jonasblixt/poetato/doc/review/schematic-readability-review-2026-10-13.md

# PoEtato schematic readability review

This review covers **readability only**: signal flow direction, density and sheet structure, font size consistency, naming, and text that collides with other items. Electrical correctness is covered by the 2026-10-09 review and is not repeated here. Like the other reviews, this is a living document: rows are updated in place and fixed items stay in the tables.

| | |
|---|---|
| Review started | 2026-10-13 |
| Revision checked | git `a62dd31` (schematic files unmodified in the working copy; only `poetato.kicad_pcb` had local changes). |
| Tools | `kicad-cli` 10.0.6 PDF export of all 10 sheets, rendered to PNG at 110 and 200 dpi and inspected visually. Font sizes and bold flags were read directly from the `.kicad_sch` files, not estimated from the renders. |
| Sheets | root `poetato`, `ethernet_poe`, `mcu`, `io` with sub-sheets `rs485`, `di` ×3, `do` ×2. |
| Preference applied | Inputs on the left, outputs on the right. Logic on the left and field on the right, where a sheet has both. Field connectors stay on the right even where that makes a channel read right to left (the DI channel stays as drawn). |
| Not checked | Electrical content, ERC and netlist. Anything about layout. |
| Status update | 2026-10-13: review closed. 19 fixed, 9 resolved by decision, 1 partly fixed (FONT-4: the LPUART1 debug port title and frame, left to Jonas). Every change was checked with ERC (0 errors, 0 warnings) and a pin-by-pin netlist comparison against the previous commit; connectivity is unchanged throughout. The schematic now has 12 A3 pages: root, MCU, MCU/Peripherals, Ethernet & PoE, Power, IO, IO/RS485, DO1, DO2, DI1–DI3. |

**Status:**
- **Open**: not addressed.
- **Partly fixed**: some of it is done; the row says what remains.
- **Fixed**: verified fixed in the schematic.
- **Resolved (decision)**: stays as it is by decision.

## Summary

The top level, the Ethernet PHY section, the isolated 24 V supply, the DO channel and the RS-485 transceiver already read left to right. Four power blocks read right to left. The MCU and Ethernet & PoE sheets each hold about 80 parts on A3 and are the hardest to read. Meanwhile RS485 is sparse and the top level is about 70 % empty. The smallest text on every sheet is the power symbol text (0.762 mm), and the LED fields are almost as small (0.99 mm).

Suggested order of work:
1. Fonts and value formatting (FONT-*, VAL-1). These are mechanical.
2. Rename and reorder the DO/DI sheets (NAME-1, NAME-2).
3. Mirror the RS-485 5 V buck (FLOW-3).
4. Split the sheets (DENS-1 to DENS-3). This also fixes FLOW-1 and FLOW-2.

## Outcome

What changed, in commit order (all 2026-10-13):

| Commit | Change |
|---|---|
| `58208a3` | Power tree on the top-level sheet (DENS-3). |
| `8686346`, `5b35b6c` (kicadlib) | Field text 1.27 mm in all hand-made symbol libraries; units on the misc R/C values. |
| `4df666f` | Symbols synced from kicadlib (FONT-1 to FONT-3, VAL-1 in part). |
| `cf830f9` | IO sub-sheets renamed DO1, DO2, DI1–DI3 and pages ordered (NAME-1, NAME-2). |
| `27c7142` | New top-level Power sheet with the 3.3 V, isolated 24 V and RS-485 5 V converters; the bucks mirrored to read left to right; eFuse next to J1 (FLOW-1, FLOW-3, FLOW-5, DENS-1). |
| `6f42cbc` | Local text collisions, KSZ8081 strap summary, BOM-only frame (LOC-*). |
| `6f4d484` | Flash, SE051 and status LEDs on an MCU peripherals sub-sheet (DENS-2). |
| `2837a36` | 2.54 mm block titles on MCU and Peripherals, DI sheets on A3 (FONT-4 in part, DENS-4). |

Jonas's own touch-ups in KiCad are in `a8c7976` and `56a763b` (the latter also updates J3 from kicadlib `81de170`).

## Findings

### Signal flow

| ID | Status | Sheet | Refs | Finding | Suggested fix |
|---|---|---|---|---|---|
| FLOW-1 | Fixed | MCU | U18, L4, C82, C83, C85 | **3.3 V buck reads right to left.** P12V0 enters on the right and P3V3 leaves on the left, because the symbol has SW on the left and VIN on the right. | Mirror the block, or redraw the TPS563252 library symbol with VIN on the left. Better still, move it to a power sheet (DENS-1). **Fixed 2026-10-13:** new top-level **Power** sheet (`power.kicad_sch`, page 4) holds the 3.3 V buck, the isolated 24 V supply (SN6507, T1, enable FET and LED) and the RS-485 5 V buck, laid out like the power tree. The PoE flyback stays on the Ethernet sheet by decision. Symbols keep their UUIDs and references; ERC 0, every net connects the same pins as before. The 3.3 V block is mirrored, so it reads left to right. |
| FLOW-2 | Resolved (decision) | Ethernet & PoE | T3, FB1–FB4, U4, T2, U5, P12V0 | **PoE PD reads right to left across the whole lower half.** Power enters at T3 (far right), passes U4 and then T2, and leaves as P12V0 at the far left edge. | Move it to its own sheet, with POE_CT1/CT2/SP1/SP2 entering from the left as hierarchical labels and P12V0 leaving on the right (DENS-1). **Closed 2026-10-13:** left as is by decision (Jonas). The PoE PD stays on the Ethernet sheet as drawn. |
| FLOW-3 | Fixed | RS485 | U17, L3, C76, C77, C79, C80, C93 | **5 V isolated buck reads right to left.** VIN (P24V0_FIELD) is on the right and P5V_RS485 leaves on the left. | Mirror the block. The page has plenty of room. **Fixed 2026-10-13:** moved to the Power sheet and mirrored; P24V0_FIELD enters on the left, P5V_RS485 leaves on the right. |
| FLOW-5 | Fixed | IO | U19, J1, D24 | The 24 V eFuse output leaves U19 OUT at the right edge. The wire then loops back left around the page to reach J1 in the middle. | Put a `P24V0_FIELD_PROT` net label at U19 OUT and at J1 pin 1, and drop the long wire. Alternatively, move the isolated supply to its own sheet. **Fixed 2026-10-13:** with the supply on the Power sheet, the eFuse block sits next to J1, just right of the isolation barrier, and P24V0_FIELD comes in through a power symbol. The output path to J1 pin 1 is short; the loop around the page is gone. |
| FLOW-6 | Resolved (decision) | MCU | U1 | The DO1_ON/DO2_ON hierarchical labels sit on the left of U1, while DI_EN, DI1–DI3 and P24V_FIELD_EN sit on the right. All of them go to the IO sheet, which is on the right at the top level. This follows from the pin sides of the bank symbol. | Low priority. If U1 is split into units (DENS-2), group the IO bank on the right. **Closed 2026-10-13:** left as is by decision (Jonas). |

### Density and sheet structure

| ID | Status | Sheet | Refs | Finding | Suggested fix |
|---|---|---|---|---|---|
| DENS-1 | Resolved (decision) | Ethernet & PoE, MCU | — | **Ethernet & PoE holds ~83 parts on A3 (test points not counted).** The T3 centre taps V1–V4 run from the PHY box down into the PoE box. The blue isolation barrier polyline also cuts across the PHY section to get there. Power is spread over four sheets: 12 V on Ethernet, 3.3 V on MCU, 24 V on IO and 5 V on RS485. | New **PoE & power** sheet: Si3402 → flyback → P12V0 → 3.3 V buck, left to right on one A3. That leaves the Ethernet sheet with just the PHY, straps, T3 and link LEDs. Note that an orphan `power.kicad_sch` was removed in `05cff1d`, so whether a power sheet comes back is your call. **Resolved 2026-10-13:** new top-level **Power** sheet (`power.kicad_sch`, page 4) holds the 3.3 V buck, the isolated 24 V supply (SN6507, T1, enable FET and LED) and the RS-485 5 V buck, laid out like the power tree. The PoE flyback stays on the Ethernet sheet by decision. Symbols keep their UUIDs and references; ERC 0, every net connects the same pins as before. The Ethernet sheet keeps the PD and flyback. |
| DENS-2 | Fixed | MCU | — | **The MCU sheet holds ~77 parts (test points not counted) and 11 functional blocks:** MCU, SWD, LPUART debug, USB, reset supervisor, flash, SE051, 3.3 V buck, RTC backup, status LEDs, crystals and decoupling. Several nets cross the page as long wires even though they also carry labels: SE_SCL/SE_SDA, SYS_STS_RED/GREEN, RESET_N (from J3 down to the supervisor), ISP_N and LPUART1_RXD/TXD. | Split into **MCU core** (U1, decoupling, crystals, reset/supervisor, VDD_CORE DCDC, RTC backup) and **MCU peripherals** (flash, SE051, SWD, LPUART, USB with ESD, status LEDs). Join them with labels rather than page-length wires. **Partly fixed 2026-10-13:** the 3.3 V buck has moved to the Power sheet. The MCU core/peripherals split is still open. **Fixed 2026-10-13:** flash (U11), SE051 (U10) and the status LEDs moved to a sub-sheet /MCU/Peripherals/ (`mcu_periph.kicad_sch`, A4, page 3). On the MCU sheet U1 connects to it through short labelled stubs, so the long SE_SCL/SE_SDA and SYS_STS wires are gone. Series resistor R44 stays next to U1. MCU sheet retitled "MCU core, debug and USB". Netlist unchanged, including net names. |
| DENS-3 | Fixed | Top level | — | The top level is about 70 % empty, and the power architecture does not appear on it. | Add a small power tree (PoE → 12 V → 3.3 V; isolated 24 V field supply; isolated 5 V RS-485 supply) as text or graphics in the free space. **Fixed 2026-10-13:** "Power tree" block added below the sheet symbols. It is drawn in native graphics only (no wires or symbols) and shows rail net names, both isolation barriers and the three ground domains. ERC 0 violations. |
| DENS-4 | Resolved (decision) | RS485 | — | Only ~29 parts on A3. The content sits in the middle and the lower left is empty. | No split needed. Mirroring the buck (FLOW-3) is a good moment to tighten it. Changing the sheet to A4 is optional. **2026-10-13:** with the 5 V buck on the Power sheet, the RS485 sheet holds only the transceiver, bus protection and LEDs, so A4 is now worth considering. **Resolved 2026-10-13:** A3 everywhere by decision. RS485 stays on A3; the DI sheets moved from A4 to A3 with the content placed where it sits on the DO sheets (ERC exclusion for COOL_POUR moved with it). |

### Font sizes

All sizes below are read from the files. The baseline is 1.27 mm for references, values, labels, sheet pins and notes.

| ID | Status | Sheet | Refs | Finding | Suggested fix |
|---|---|---|---|---|---|
| FONT-1 | Fixed | all | GND, P3V3, P12V0, GND_FIELD, P24V0_FIELD etc. | **Power symbol text is 0.762 mm**, which is about 60 % of the baseline and about 2 pt when printed on A3. All 154 placed GND and supply symbols use it: MCU 73, Ethernet 35, IO 19, RS485 18, DI 6, DO 3. This is the hardest text to read on every sheet. | Set 1.27 mm in the library symbols, then reset the placed instances with *Edit → Edit Text & Graphic Properties*. Field sizes are stored per instance, so a library update alone does not change them. **Fixed 2026-10-13:** kicadlib `8686346` sets field text to 1.27 mm in all hand-made symbol libraries; pulled in with Update Symbols from Library. Value sizes were synced to the library by script, because resetting Value in KiCad would also reset power-symbol net names. Field positions kept as before the update; R1, C6, Q6 and C75 text nudged where the larger power-symbol text collided. ERC 0, netlist unchanged. |
| FONT-2 | Fixed | all | D7, D8, D9, D13–D16, D22 + the other DI copies | **LED Reference and Color fields are 0.99 mm.** | Use 1.27 mm, as in FONT-1. **Fixed 2026-10-13:** kicadlib `8686346` sets field text to 1.27 mm in all hand-made symbol libraries; pulled in with Update Symbols from Library. Value sizes were synced to the library by script, because resetting Value in KiCad would also reset power-symbol net names. Field positions kept as before the update; R1, C6, Q6 and C75 text nudged where the larger power-symbol text collided. ERC 0, netlist unchanged. |
| FONT-3 | Fixed | MCU, Eth, IO, RS485, DI, DO | U7, U8, U9, U11, U17, U18, U20, J4, J5, J6, J8, Q1, Q3, Q6–Q10, Q12, D27 | **Reference and Value are 1.524 mm on some ICs, FETs and connectors**, while U1, U3, U4, U10, U12, U16 and everything else use 1.27 mm. Neighbouring parts on the same sheet therefore don't match. These parts probably came from libraries with a different default. | Pick one size (1.27 mm) and batch-set it. Fix the library defaults too. **Fixed 2026-10-13:** kicadlib `8686346` sets field text to 1.27 mm in all hand-made symbol libraries; pulled in with Update Symbols from Library. Value sizes were synced to the library by script, because resetting Value in KiCad would also reset power-symbol net names. Field positions kept as before the update; R1, C6, Q6 and C75 text nudged where the larger power-symbol text collided. ERC 0, netlist unchanged. |
| FONT-4 | Partly fixed | MCU, IO, RS485 | — | **Block titles are inconsistent.** "SWD Debug port", "3.3V Supply", "Voltage supervisor / Reset generation", "Ethernet PHY" and "PoE (Power over Ethernet)" are 2.54 mm inside a dashed box. "RTC & SRAM Backup power (>= 8h)" is a 1.27 mm title. "LPUART1 Debug Port" is 1.27 mm with no box. "RS485 5V Supply" is 2.54 mm with no box and sits *below* its block. On IO, "Isolated 24V, 3W supply" is loose 1.27 mm text on the right of the page, not near the supply. | Use one convention: a 2.54 mm title in the top left corner of a dashed box, one per functional block. Give LPUART debug, RS485 transceiver, RS485 5 V supply, the isolated 24 V supply and the status LEDs their own boxes. **Partly fixed 2026-10-13:** all block titles are now 2.54 mm in a dashed frame: Power sheet (3.3 V, 24 V, 5 V), Peripherals (Secure Element, 8MiB Mass storage flash, System status LEDs, left-aligned in each frame), and the MCU RTC block ("RTC & SRAM backup (≥ 8 h)", two lines; contents moved down 7.62 mm to make room). Remaining: the LPUART1 debug port still has a small title and no frame; J4 sits against the page border, so it needs moving first. |

### Naming and ordering

| ID | Status | Sheet | Refs | Finding | Suggested fix |
|---|---|---|---|---|---|
| NAME-1 | Fixed | IO, DO, DI | — | **Sub-sheet names are off by one compared with the channel numbers.** "Digital Output" is DO1, but "Digital Output1" is DO2 (K2, DO2_ON). "Digital Input", "Digital Input1" and "Digital Input2" are DI1, DI2 and DI3. The sheet path in the title block (for example `/IO/Digital Output1/`) therefore names the wrong channel. | Rename the sheets `DO1`, `DO2`, `DI1`, `DI2`, `DI3` to match the nets and the J1 pinout. **Fixed 2026-10-13:** renamed to DO1, DO2, DI1, DI2, DI3 (sheet UUIDs unchanged, so PCB footprint links are kept). The only nets renamed are the three ISO1211 `COOL_POUR` nets, now `/IO/DI1/COOL_POUR` to `/IO/DI3/COOL_POUR`. |
| NAME-2 | Fixed | — | — | **Page numbers interleave the channels:** 6 = DO, 7 = DI, 8 = DO1, 9 = DI1, 10 = DI2. | Renumber so the pages go DO1, DO2, DI1, DI2, DI3, and put RS485 next to IO. **Fixed 2026-10-13:** pages are now 1 root, 2 MCU, 3 Ethernet & PoE, 4 IO, 5 RS485, 6 DO1, 7 DO2, 8 DI1, 9 DI2, 10 DI3. |
| VAL-1 | Resolved (decision) | Eth, DO, DI | R11, R28, R30, R52, R53, R57, C50, C89, C90, C91 | **Value formatting is mixed.** Some resistors have no Ω: R52/R53 "10", R57 "1k", R11/R28/R30 "0". Capacitors use "uF" while inductors use "µH". Precision varies: "22uF" (C50) vs "22.0uF" elsewhere, and "1nF" (C89–C91) vs "1.0nF" (C62–C69). | Use one style, e.g. "10Ω", "1kΩ", "0Ω", "22.0µF", "1.0nF". This overlaps with F2-1 in the 2026-10-09 review. **Partly fixed 2026-10-13:** kicadlib `5b35b6c`: R11/R28/R30 0Ω, R52/R53 10Ω, R57–R59 1kΩ, R15 12MΩ, C89–C92 1.0nF. Left as is: "uF" vs "µH" and the 2-digit electrolytic values (C50 "22uF"), which follow the database library conventions. **Closed 2026-10-13:** left as is by decision (Jonas). The remaining items (uF vs µH, 2-digit electrolytic values) follow the database library conventions. |

### Local collisions and clutter

| ID | Status | Sheet | Refs | Finding | Suggested fix |
|---|---|---|---|---|---|
| LOC-1 | Fixed | MCU | SYS_STS_GREEN, P4_16/P4_17 wires | The SYS_STS_GREEN wire runs through the note "These share the same light pipe". The LED wires run through "TP18/TP70 Switch node measurement". | Move the notes, or replace the wires with labels (DENS-2). **Fixed 2026-10-13:** light-pipe note reworded to "D14 and D15 share the same light pipe" and moved right of D14, clear of the wire. The TP18/TP70 note no longer crosses anything after Jonas's touch-ups. |
| LOC-2 | Resolved (decision) | MCU | TP18, L1, DCDC_LX, PWR_FLAG | TP18, the vertical DCDC_LX label, L1 and PWR_FLAG are stacked on top of each other next to U1 pin 53. | Give the VDD_CORE DCDC a little more room, and put the label horizontally. **2026-10-13:** still cramped but readable; fixing it needs room around U1 pin 53, left to Jonas. **Closed 2026-10-13:** reviewed by Jonas, left as is. |
| LOC-3 | Fixed | MCU | TP22, P3V3_FB_1 | The P3V3_FB_1 label overlaps the TP22 reference. | Move one of them. **Fixed 2026-10-13:** the 3.3 V feedback divider moved to the Power sheet, where TP22 and the R88/R63/R89 text no longer collide. |
| LOC-4 | Fixed | MCU | TP64, TP65, ETH_RXDV | TP64 and TP65 crowd the ETH_RXDV net name at U1 pins 5–6. TP64 also sits next to the pin 5 no-connect marker. | Move the TPs a grid step to the left, or pull the net name back. **Fixed 2026-10-13:** TP64 reference left of the test point, TP65 reference right of it, both off the signal rows. |
| LOC-5 | Fixed | MCU | 3.3 V supply PWR_FLAG ×2 | The "PWR_FLAG" text is far to the left of its symbols, outside the block. | Move the text next to the symbol. **Fixed 2026-10-13:** the 3.3 V block moved to the Power sheet; the PWR_FLAG labels sit next to their symbols inside the frame. |
| LOC-6 | Resolved (decision) | Ethernet | R10, R27, R31, R32, R33, R35–R39, R41 | On the vertical strap and pull resistors, the value is rotated and printed through the resistor body, and R10/R27 text nearly touch. The 33 Ω series resistors (R17–R20, R24–R26) and R42/R43/R44 on MCU also print the value inside the body. Every other resistor puts its fields beside the body. | Put the fields beside the body, as on the other resistors. **2026-10-13:** left as is for now. The bottom strap row is on a 5.08 mm pitch, so values beside the bodies would collide; changing it means respacing the resistors. Jonas to decide. **Closed 2026-10-13:** reviewed by Jonas, left as is. |
| LOC-7 | Fixed | Ethernet | R10, R27, R31–R41 | Nothing says what the straps select (PHYAD, RMII mode, CONFIG, ISO), so reading the sheet needs the KSZ8081 datasheet. | Add a short strap table as a note next to U3. **Fixed 2026-10-13:** strap summary text box in the top left of the Ethernet PHY block (PHYAD 001 = address 1, CONFIG 001 = RMII, NWAYEN/SPEED high, NAND_Tree# high, DUPLEX/ISO/B-CAST_OFF internal defaults), from KSZ8081 DS00002202D Table 2-4 and the netlist. |
| LOC-8 | Resolved (decision) | Ethernet | TP6, TP69, TP1, TP10 | The TP6 reference overlaps the POE_VDD label. The "TP Placement" note is in the lower middle of the PoE box, far from TP1, TP4 and TP10. The dashed lines joining the TP pairs cross wires. | Move TP6 clear of POE_VDD, and put the placement notes next to the TPs they describe. **Partly fixed 2026-10-13:** TP6 reference moved above the test point, clear of POE_VDD. The TP placement note stays where it is; there is no free space next to the TP pairs. **Closed 2026-10-13:** reviewed by Jonas, left as is. |
| LOC-9 | Resolved (decision) | Ethernet | — | The "Place TP63 on signal without stub…" note is squeezed between the RXD1 and RXDV rows and runs right up to TP63. | Move it into free space, e.g. below the TXEN row, close to TP63/TP66. **2026-10-13:** left as is: the note does not overlap anything, and every nearby spot crosses the strap wires. **Closed 2026-10-13:** reviewed by Jonas, left as is. |
| LOC-10 | Fixed | IO | — | Spec notes ("Output 1 - 2: ≤ 30 V DC…", "Input 1 - 3: IEC 61131-2…", "Isolated 24V, 3W supply") float loosely to the right, beside the "Isolation:" text box. | Put each note next to its block (DO sheets, DI sheets, supply), or merge them all into the box. **Fixed 2026-10-13:** the two rating lines moved into the notes box under a "Ratings:" heading; the "Isolated 24V, 3W supply" line went with the supply to the Power sheet (block title). |
| LOC-11 | Fixed | RS485 | R81, C78, P5V_RS485_FB | R81's "1%" field and C78's (DNP) "C0G" field sit on the P5V_RS485_FB wire. | Move the fields, or route the FB wire one grid step lower. **Fixed 2026-10-13:** the 5 V feedback divider moved to the Power sheet and was laid out again there. |
| LOC-12 | Fixed | DO (×2) | K1/K2, R52/R53, F1/F2 | The notes "1.5-2.1 A peak @ 24V short", "< 20ms TtT @ 2A" and "PhotoMos: 3A, < 100ms req" are crowded between K1, R52 and F1, so it is unclear which part each one describes. | Put each note directly under the part it describes (R52, F1, K1). **Fixed 2026-10-13:** PhotoMOS note moved under K1 ("PhotoMOS: 3 A, < 100 ms required"); the R52 and F1 notes already sit under their parts. |
| LOC-13 | Fixed | Top level | BOM Entry ×16 | The BOM-only symbols in the lower left have no heading. | Add a "Mechanical / BOM-only items" heading, ideally inside a box. **Fixed 2026-10-13:** dashed frame with a "Mechanical / BOM-only items" title around the BOM entries. |
