jonasblixt/poetato/doc/pcb-stackup.md

# PoEtato — PCB stackup and controlled impedance

The board is 6 layers on JLCPCB's **JLC06161H-2116A** stackup (decided
2026-10-13), with controlled impedance for the RMII, USB and Ethernet MDI nets.

The same stackup and the impedance table are drawn on the `User.Stackup`
layer (User.3) of `hw/poetato/poetato.kicad_pcb`, to the right of the board,
with the fabrication notes of §7 below it. Board Setup → Physical Stackup
holds the same values, so the Gerber job file, IPC-2581 and ODB++ exports
carry them. The widths come from `doc/scripts/impedance.py` (§4).

---

## 1. Stackup

1.6 mm finished, 1 oz outer copper, 0.5 oz inner copper (both finished
weights), FR-4. Thicknesses and Dk are from JLCPCB's impedance page
(jlcpcb.com/impedance), read 2026-10-13. JLCPCB does not state the frequency
the Dk applies at.

| Layer | Use | Material | Thickness | Dk |
|---|---|---|---|---|
| F.Cu | **L1 signal** | Copper 1 oz | 0.035 mm | |
| | | Prepreg 2116 | 0.1164 mm | 4.16 |
| In1.Cu | **L2 GND** | Copper 0.5 oz | 0.0152 mm | |
| | | Core | 0.13 mm | 4.6 |
| In2.Cu | **L3 signal** | Copper 0.5 oz | 0.0152 mm | |
| | | Prepreg 2116 | 0.1164 mm | 4.16 |
| | | Core, no copper | 0.70 mm | 4.6 |
| | | Prepreg 2116 | 0.1164 mm | 4.16 |
| In3.Cu | **L4 PWR** | Copper 0.5 oz | 0.0152 mm | |
| | | Core | 0.13 mm | 4.6 |
| In4.Cu | **L5 GND** | Copper 0.5 oz | 0.0152 mm | |
| | | Prepreg 2116 | 0.1164 mm | 4.16 |
| B.Cu | **L6 signal** | Copper 1 oz | 0.035 mm | |

Laminate total 1.556 mm, plus solder mask (Dk 3.8).

The layer order was read from a flattened table on JLCPCB's page. Check it
against their stackup viewer before ordering.

## 2. Why this stackup

The layer assignment is Sig / GND / Sig / PWR / GND / Sig. Two things follow
from it:

- **L3 must return its current in GND, not PWR.** It needs to sit much closer
  to L2 than to L4. On 2116A it is 0.13 mm from L2 and 0.93 mm from L4.
- **L4 PWR and L5 GND should be close.** The planes then act as a distributed
  decoupling capacitor. On 2116A they are 0.13 mm apart.

Only JLCPCB's thin-core stackups do both. Of those, 2116A has the thickest
outer prepreg, so it gives the widest traces.

| Rejected | Why |
|---|---|
| JLC06161H-3313, -1080A, -2116B (thick cores) | L3 sits 0.10–0.15 mm from L4 PWR and 0.5–0.6 mm from L2 GND, so it references PWR. L4–L5 is 0.5 mm or more, so the planes barely couple |
| JLC06161H-1080B, -1080C, -3313E (thin cores, thinner outer prepreg) | Same structure as 2116A but with 0.076–0.099 mm to L2. The 100 Ω differential pairs come out at 0.06–0.10 mm wide, at or below JLCPCB's 0.09 mm minimum, where the etch tolerance becomes a large share of the width |
| 0.18 mm or more to L2 (-3313C, -3313D, -2116, -2116C, the 7628 family) | The outer 50 Ω trace grows to roughly 0.3 mm or more (estimated, not solved), wider than the 0.5 mm-pitch QFP pads it starts from. The L4–L5 gap is 0.1–0.4 mm |

## 3. Impedance classes

| Class | KiCad net class | Nets | L1 / L6, W / S | L3, W / S | Reference |
|---|---|---|---|---|---|
| 50 Ω single-ended | `50Ohm_RMII` | `ETH_REF_CLK`, `ETH_TXD0/1`, `ETH_TXEN`, `ETH_RXD0/1`, `ETH_RXDV`, and their PHY-side segments after the 33 Ω resistors | 0.18 mm | 0.16 mm | L2 / L5 GND |
| 50 Ω single-ended | `50Ohm_QSPI` | `FLASH_SCK`, `FLASH_CS_N`, `FLASH_D0`–`D3` | 0.18 mm | 0.16 mm | L2 / L5 GND |
| 50 Ω single-ended | `50Ohm_SWD` | `SWDCLK`, `SWDIO`, `SWO`, MCU → J3 | 0.18 mm | 0.16 mm | L2 / L5 GND |
| 90 Ω differential | `90Ohm-diff_USB` | `USB_D_P` / `USB_D_N`, connector → USBLC6 → MCU | 0.16 / 0.15 mm | 0.13 / 0.15 mm | L2 / L5 GND |
| 100 Ω differential | `100Ohm-diff_MDI` | `ETH_TX_P/N`, `ETH_RX_P/N`, PHY → magjack | 0.14 / 0.20 mm | 0.12 / 0.20 mm | L2 / L5 GND |

W is the trace width, S the gap between the two traces of a pair. The USB pair
was `USB_DP` / `USB_DM` until 2026-10-13. It was renamed because KiCad only
pairs nets whose names end in P/N or +/−.

- **`ETH_REF_CLK` matters most.** It is the 50 MHz clock from the MCU into the
  PHY's XI pin through a 33 Ω series resistor. Treat the rest of RMII as best
  effort.
- **QSPI is optional.** The S25FL064L runs up to about 108 MHz, but on traces
  of a few centimetres the series termination matters more than the impedance.
  Route at the 50 Ω width anyway, because it costs nothing.
- **SWD** runs up to 25 MHz, with SWD_CLK rise and fall times up to 3 ns
  (MCX N247 datasheet, Table 33 p.46). Added 2026-10-14. There are no series
  resistors on the board, so the probe's own termination is what damps the
  cable. If it rings, a 22–33 Ω series resistor on `SWDCLK` near U1 is the fix;
  that would be a schematic change. `RESET_N` is slow and has an RC, so it
  stays Default.
- **Not controlled:** RS-485 A/B (slow, short on-board stubs), MDC/MDIO,
  the crystals, field I/O.

## 4. How the widths were computed

`doc/scripts/impedance.py` is a 2D field solver. It solves the cross-section
on a nonuniform grid and computes Z0 from the capacitance with and without the
dielectric. `--check` compares it with two analytic cases, centred stripline
and microstrip, and it agrees with both within about 1 %.

```sh
pip install numpy scipy
python doc/scripts/impedance.py                 # JLC06161H-2116A
python doc/scripts/impedance.py --stackup all   # the thin-core candidates
python doc/scripts/impedance.py --check
```

Assumptions:

- 35 µm finished outer copper, 15.2 µm inner copper.
- Solder mask Dk 3.8, 30 µm over laminate, 15 µm over copper.
- Rectangular trace cross-section. Real traces are trapezoidal, which raises
  the impedance by a few ohms.

Expect the results to be within about ±5 % of the fab. **JLCPCB's impedance
calculator is the reference for the order:** confirm the widths there for
JLC06161H-2116A, and update §3 and the drawing on the board if they differ.

## 5. Routing rules that follow from the stackup

- Route controlled nets on L1 and L6 over unbroken GND on L2 and L5. No splits
  or slots under them.
- Route L3 signals only where L2 is unbroken GND. L4 is too far away to serve
  as a return path.
- When a controlled net changes layer, place a GND stitching via next to the
  signal via, so the return current can follow it between L2 and L5.

## 6. Open items

- **Confirm the widths** in JLCPCB's impedance calculator (§4).
- **Surface finish.** §7 says ENIG. At JLCPCB, 6-layer boards come in ENIG or
  OSP only, no HASL. ENIG is flat for the 0.5 mm QFP and keeps on the shelf.
  Change it here, in Board Setup and in the drawing if OSP is preferred.
- **Loss tangent.** Board Setup uses KiCad's placeholder 0.02, because JLCPCB
  publishes no Df. Nothing on this board is fast enough for it to matter.
- **Update PCB from Schematic (F8)** to bring the net classes and the USB
  rename into the board, then refill zones. The inner-layer via pads were
  removed in the file, so the zone fills are stale until then.
- **Isolation barrier rules** (§8) are on hold. When they are added, they go
  in `poetato.kicad_dru` as rule areas per domain.
- **Silkscreen.** The 0.15 mm silk clearance and 0.15 mm text-thickness
  minimum add about 80 silkscreen DRC findings on the current placement.
  Tidy them during layout.
- **Order with impedance control,** stackup JLC06161H-2116A and the Tg 155
  option. The impedance test report is checked in `doc/verification-plan.md`
  §8.

## 7. Fabrication requirements

This is what goes to the fab. It is written to work for any vendor: §1 is the
reference build at JLCPCB, but another fab can build to its own materials as
long as it meets these requirements. The same notes are on the board drawing.

1. **Build to IPC-6012 Class 2.** 6-layer rigid FR-4, Tg ≥ 150 °C, rated for
   lead-free assembly. Reference build: JLCPCB stackup JLC06161H-2116A, Tg 155
   option.
2. **Finished board thickness** 1.60 mm ±10 %.
3. **Finished copper:** outer layers 1 oz (35 µm), inner layers 0.5 oz.
4. **Layer order and use** as in §1. The dielectric thicknesses are nominal.
   Other materials and constructions are acceptable if the impedance targets
   and the finished thickness are met, and L1–L2, L2–L3, L4–L5 and L5–L6 each
   stay ≤ 0.15 mm. That last condition keeps what §2 depends on: L3 next to
   GND and the power planes tightly coupled.
5. **Controlled impedance** per §3, ±10 %. The fab may change the width of
   controlled traces by up to ±0.025 mm, keeping the pair pitch, to meet the
   targets. TDR test coupons and an impedance test report are required
   (IPC-TM-650 2.5.5.7).
6. **Surface finish** ENIG. LPI solder mask on both sides, Dk about 3.8.
7. **Vias** are plain plated through-holes, smallest finished hole 0.25 mm. No
   via filling or capping is required (no IPC-4761 Type VII). Non-functional
   inner-layer pads are removed in the data.

**Materials at JLCPCB.** Multilayer boards come as Tg 135–140 or Tg 155; order
Tg 155. The laminates on their certifications page are Nan Ya NP-155F,
Kingboard KB-6165F and Shengyi S1000H. JLCPCB doesn't say which one a given
order uses. Their impedance tolerance is ±10 % as standard, and ±5 % on
request.

**Keeping things in step.** The drawing comes from
`doc/scripts/stackup_drawing.py`. When the stackup, the widths or these notes
change, update this document, Board Setup → Physical Stackup and the script's
`STACK`, `IMP` and `FAB_NOTES`. Then close the board in KiCad and re-run the
script; it replaces the previous drawing:

```sh
python doc/scripts/stackup_drawing.py hw/poetato/poetato.kicad_pcb
```

## 8. Design rules

Decided 2026-10-13. The board-wide rules and net classes are in
`hw/poetato/poetato.kicad_pro` (Board Setup). The L3 widths are in
`hw/poetato/poetato.kicad_dru`. JLCPCB's limits are from their capabilities
page (jlcpcb.com/capabilities/pcb-capabilities, multilayer, 1 oz), read
2026-10-13.

| Rule | PoEtato | JLCPCB limit | Note |
|---|---|---|---|
| Track width, default | 0.18 mm | | The 50 Ω width on L1/L6, so plain signals there are 50 Ω for free. About 46 Ω on L3 |
| Track width, minimum | 0.12 mm | 0.09 mm, width tolerance ±20 % | The narrowest impedance geometry (L3, 100 Ω differential) |
| Clearance | 0.15 mm | 0.09 mm trace/space; 0.15 mm SMD pad to pad | Equals the USB pair gap. Leaves 0.2 mm between pads at 0.5 mm pitch |
| Via, default | 0.3 / 0.6 mm (hole / diameter) | min 0.15 / 0.25 mm; no extra cost from a 0.3 mm hole, or 0.2–0.25 mm with ≥ 0.45 mm diameter | Annular ring 0.15 mm; 5.3:1 aspect ratio in 1.6 mm |
| Via, small | 0.25 / 0.45 mm | as above | For tight fanout only, used sparingly. The board-wide minimums (hole 0.25, via 0.45) allow it |
| Via annular ring, minimum | 0.1 mm | via diameter ≥ hole + 0.1 mm | |
| Unused via pads | Removed on inner layers, kept on F.Cu/B.Cu | | Set on every via (`remove_unused_layers`, `keep_end_layers`). New vias need the same: use KiCad's Remove Unused Pads tool or the via properties |
| Hole clearance (hole to copper) | 0.3 mm | via 0.2; PTH 0.28 (0.35 recommended); inner via hole to copper 0.2, inner PTH pad to copper 0.3 | Covers the inner-layer limits too |
| Hole to hole | 0.3 mm | via 0.2; pad holes 0.45 | Keep component holes ≥ 0.45 apart by footprint |
| Copper to board edge | 0.5 mm | routed 0.2; V-cut 0.4 | Margin for the enclosure and for panelling |
| Solder mask | 1:1 (expansion 0), min web 0.1 mm | 1:1 since the LDI upgrade; bridge 0.10 mm (green, 1 oz) | |
| Silkscreen | text ≥ 1.0 mm high, ≥ 0.15 mm stroke; 0.15 mm to pads | the same | |

**Differential pair presets:** 0.16 / 0.15 mm (90 Ω, L1/L6), 0.14 / 0.20 mm
(100 Ω, L1/L6), 0.13 / 0.15 and 0.12 / 0.20 mm (the same on L3). Diff pair via
gap 0.25 mm.

**Where the net classes are assigned.** In the schematic, only with rule
areas: a dashed box with a net-class flag gives its class to every net with a
wire or pin inside it. The board gets them through Update PCB from Schematic.
Use rule areas for new assignments too, not hidden fields on labels, so every
assignment is visible on the sheet.

| Sheet | Rule area | Class |
|---|---|---|
| Ethernet & PoE | RXD0/RXD1, R17/R18 and their PHY-side wires | `50Ohm_RMII` |
| Ethernet & PoE | RXDV, TXD0/1, TXEN, R24/R19/R20/R25 and their PHY-side wires | `50Ohm_RMII` |
| Ethernet & PoE | ETH_REF_CLK, R26, ETH_REF_CLK_PHY | `50Ohm_RMII` |
| Ethernet & PoE | ETH_TX_P/N, ETH_RX_P/N between the PHY pins and the ESD taps | `100Ohm-diff_MDI` |
| MCU | the QSPI bundle, including R44 and its MCU-side stub | `50Ohm_QSPI` |
| MCU | SWDIO, SWDCLK, SWO between the pull-ups and the labels | `50Ohm_SWD` |
| MCU | USB_D_P / USB_D_N | `90Ohm-diff_USB` |

Each box covering a series resistor also covers both of its pins, so the net
on each side gets the class. The boxes stop short of IC pin ends, which
keeps no-connect pins and other nets out. The RMII nets are hierarchical, so
the Ethernet-sheet boxes also cover their wires on the MCU sheet. The PHY
side of R26 has a label, `ETH_REF_CLK_PHY`, for a readable net name on the
board.

**Vias in pads.** The design does not rely on filled and capped vias (IPC-4761
Type VII). JLCPCB makes them the default on 6-layer boards, but another fab
would charge for them. Avoid vias in pads where possible. Where an exposed
thermal pad needs vias, keep them small and few, and window the paste
stencil around them.

**Not covered here:**
- **Isolation barriers** (on hold, §6): cable/PoE side ↔ everything else at
  1500 Vrms, logic ↔ field.
- **Current-carrying widths** for the PoE input, flyback primary and 12 V
  rail. Size them for their current; inner copper is 0.5 oz.
