jonasblixt/poetato/datasheets/mcu/MCX_N_Series_Design_In_checklist_v4.xlsx

Sheet: Project Information
Copyright 2015, 2024 NXP
DESIGN-IN REVIEW CHECK-LIST (draft)
PROJECT INFORMATION
Completed by :
Date :
Customer : | Mass Production date:
Project name : | Platform Solution :
Revision : | NXP Driver version:

Sheet: CheckList_Schematic
Check number | SCHEMATICS DESIGN-IN REVIEW CHECK-LIST | Y/N/NA | Customer comments and/or actions | Check done by | NXP Feedback
1 | GENERAL
1.1 | Have the power supply requirements and strategy been discussed?
1.2 | Have the schematics been checked versus NXP reference schematics & Application Notes?
1.3 | Have the schematics been reviewed by several people?
1.4 | Does the application use standard components (components that have been previously used for such applications)?
1.5 | Have any non-standard components been qualified so that they can be used in the application?
1.6 | Are recommendations for layout written on the schematics?
1.7 | Are the components sized for the desired current drive capability?
1.8 | Has the MCX symbol pinning been checked?
1.9 | Have the programming and debug method been discussed?
2 | HF Reference Oscillator (Note : 24 MHz is required if USB ISP mode required with default configuration)
2.1 | Does the XTAL follow the recommended characteristics ?
2.2 | Are external load capacitors appropriate and included?
3 | RTC (32 KHz) Crystal Oscillator
3.1 | Does the XTAL follow the recommended characteristics?
3.2 | Are external load capacitors omitted?
4 | Power Supply
4.1 | Have all the VDD pins been connected according to NXP recommendations?
4.2 | Have all GND connections been connected to GND according to NXP recommendations
4.3 | If using the HLQFP100 package, has the thermal pad been connected to ground?
4.4 | Are the power supply regulators well sized?
4.5 | Has the decoupling of the supply regulators output been implemented?
4.6 | Have the power supply pins of the IC been properly decoupled (according to the Application Note and Reference Design schematics?)
4.7 | If the DCDC is to be used, has an appropriate inductor been sourced and included?
4.8 | If the DCDC is to be used, has the core LDO been disabled properly (if applicable)?
4.9 | If the Core LDO is to be used, has the DCDC been disabled properly (if applicable)?
4.10 | Do the ouput capacitors of the on-board regulators (LDO_SYS, LDO_CORE / DCDC) meet datasheet specifications?
4.11 | Has it been verified that the power sequencing requirements will not be violated?
4.12 | Have Vrefh / Vrefl been properly constrained within their specified operating limits?
4.13 | Has proper filtering of VDDA been applied such that the maximum allowable ripple will not be exceeded?
5 | GPIO
5.1 | Has the compatibilty of the I/O logic levels of the MCX with other components been checked?
5.2 | Does the max source/sink current of the GPIO fit the application?
5.3 | If pull-ups are used on any GPIO in the design, are the pull-ups sourced from the correct power supply for that GPIO port?
5.4 | If the Tamper pins are to be used, have they been properly connected?
5.5 | Do Tamper pins 0, 1, and 2 have a note to bury them between ground planes? Alternatively (if this cannot be done) 3pF bypass capacitors could be added to each pin.
5.6 | Has the VBAT_WAKEUP_b pin (P5_2) been properly handled for the application (this pin drives low on reset)?
5.7 | Does the design ensure that GPIO will not be driven before the application of power to the supplies?
6 | ADC
6.1 | Does the ADC characteristics fit the application?
6.2 | Has the VREFH voltage been chosen according to the desired ADC range?
6.3 | Does the input impedance to the ADC channels fall under the maximum ADC impedance?
7 | DAC
7.1 | Has the VREFH voltage been chosen according to the desired DAC range?
7.2 | Have the load capacitors for the DAC been included?
8 | VREFOUT
8.1 | Has a 100nF capacitor to GND been connected to VREF_OUT in case the VREF_OUT functionality is being used for either an internal or external reference?
9 | Programming and Debug
9.1 | Has the debug connector been connected to the correct I/O on the microcontroller?
9.2 | Has a connector been added that allows the microcontroller to be put into programming mode?
9.3 | Is RESET_b properly connected to the debug connector?
10 | External Memory
10.1 | Is the external memory used a supported memory type?
10.2 | If used for boot, is it connected to FlexSPI A?
10.3 | If using DDR mode, is DQS connected to the memory devices's DQS pin and only this pin?
10.4 | Has the flash memory symbol pinning been checked?
11 | Reset and ISP pin
11.1 | Has the ISP mode pin been configured appropriately?
11.2 | Have capacitors been placed on the reset pin?
11.3 | If using ISP mode, are the bootloader pins correctly connected for the chosen interface(s)?
12 | USB FS
12.1 | Has the VBUS pin been properly connected through a voltage divider circuit?
12.2 | Have the inline 33 ohm resistors been placed with the CAD note that they should be placed as close as possible to the USB0_DM and USB0_DP pins?
12.3 | Has the USB circuit been properly de-coupled (if used)?
12.4 | Have transient protection diodes been placed on USB data lines and supply lines (if using USB)?
12.5 | Has the USB shield (casing) been properly grounded (if using USB)?
13 | USB HS
13.1 | Has the VBUS pin been directly connected to the USB VBUS?
13.2 | Have the inline resistors been from USB0_DM and USB0_DP pins?
13.3 | Has the ID pin been appropriately connected for OTG applications?

Sheet: CheckList_Layout
Check number | LAYOUT DESIGN-IN REVIEW CHECK-LIST | Y/N/NA | Customer comments and/or actions | Check done by | NXP feedback
1 | GENERAL
1.1 | Has the number of layers been clearly discussed?
1.2 | Has the layout been checked versus NXP reference board (latest revision) ?
1.3 | Has the correct PCB material been specified?
1.4 | Has the correct PCB thicknesses been specified?
2 | High Frequency Crystal reference Oscillator
2.1 | Has the XTAL been placed close to the IC?
2.2 | Have GND vias been placed around the XTAL ?
3 | Power Supply
3.1 | Have all the decoupling capacitors been placed as close as possible to the power pins and voltage regulators outputs?
3.2 | Have multiple vias been added to inter-connect power lines when power is routed on several layers ?
3.3 | For low supply voltage application – close to 1.71V, please ensure that the supply track is well dimensioned so as to avoid IR drop and hence falsely trigger the brown-out. (IR drop is the voltage drop due to the supply current "I" flowing into the supply track resistance "R").
3.4 | Have the VDD lines been isolated from potential interferences on all layers?
3.5 | Have the crystal references been placed on the same side of the board as the MCU?
3.6 | If the DCDC regulator is used, has the inductor been placed on the same side of the board as the MCU?
3.7 | If the DCDC regulator is used, has the recommended DCDC layout been followed?
4 | EMC and Misc
4.1 | In case more than 2 layers are used, does layer two right below the top/component side act as a continuous ground plane (GND reference plane)?
4.2 | Have traces been avoided below noisy or sensitive components?
4.3 | Do traces cut across power or ground planes unnecessarily?
4.4 | Where possible has a GND area or trace been added to isolate one signal from another one? (the ground area or trace must be properly connected to the reference GND plane with vias; otherwise it is better to remove it)
4.5 | Have all the connections between a component and GND be doubled with a via to the GND plane?
4.6 | Have the small GND fills and isolated fingers that cannot be connected to the reference GND plane with a via been removed?
4.7 | Have silk screens been added with relevant information? (components ref, logo, board name…)
4.8 | Are all silkscreen texts readable when the board is populated?
4.9 | Is the footprint strictly similar to the NXP reference?
4.10 | Are copper wires or areas clearance to the PCB edge respected according to the PCB manufacturer rules ?
4.11 | Have the soldering/non soldering areas been respected? Is solder resist layer check in the empty area?
4.12 | If using the DCDC regulator, have the charge / discharge loops been minimized per the Hardware Design Guidelines?

Sheet: Additional Comments
Copyright 2015, 2024 NXP
ADDITIONNAL COMMENTS DESIGN-IN REVIEW CHECK-LIST | Y/N/NR | Comments and/or actions | Owner

Sheet: Revision History
Copyright 2015, 2024 NXP
TOP DESIGN REVIEW CHECK-LIST
REVISION HISTORY
Version # | Done by | Date | Section changed | Change owner | Comment
1 | NXA07750 | 2024-05-13 | All | SE team - Austin | Creation
2 | NXA07750 | 2024-12-06 | CheckList_Schematic - Section 4, Section 5, Section 13 Checklist_Layout - Section 3 | SE team - Austin | Added check for output capacitors of on-board regulators. Added check for VBAT_WAKEUP_b pin. Added check for ensuring GPIO are not driven before supply voltage is applied. Corrected borders in section 13. Added check for proper DCDC layout.
3 | NXA07750 | 2026-01-15 | Added HLQFP100 thermal pad check to Schematic Section 4 Updated item 4.8 and 4.9 in Schematic tab. Updated item 5.6 in the Schematic tab. Updated item 9.3 in the Schematic tab.
