jonasblixt/poetato/datasheets/mcu/MCXNP184M150F70_Pinout.xlsx

Sheet: MCX_N94_N54_N53_N52_N24_Pinmux
184BGA ALL | 184BGA ALL Pin Name | 172HDQFP ALL | 172HDQFP ALL Pin Name | 100HLQFP N94 | 100HLQFP N94 Pin Name | 100HLQFP N54/N53/N52/N24 | 100HLQFP N54/N53/N52/N24 Pin Name | I/O Supply | Default | ISP | ANALOG | ALT0 | ALT1 | ALT2 | ALT3 | ALT4 | ALT5 | ALT6 | ALT7 | ALT8 | ALT9 | ALT10 | ALT11 | VDD_SYS | Pad type
A1 | P1_8 | 172 | P1_8 | 1 | P1_8 | 1 | P1_8 | VDD | DIS | UART_RXD | TSI0_CH17/ADC1_A8 | P1_8 | TRACE_DATA0 | FC4_P0 | FC5_P4 | CT_INP8 | SCT0_OUT2 | FLEXIO0_D16 | SMARTDMA_PIO4 | PLU_OUT0 | ENET0_TXD2 | I3C1_SDA |  | WUU0_IN10/LPTMR1_ALT3 | MED+I2C+I3C
B1 | P1_9 | 1 | P1_9 | 2 | P1_9 | 2 | P1_9 | VDD | DIS | UART_TXD | TSI0_CH18/ADC1_A9 | P1_9 | TRACE_DATA1 | FC4_P1 | FC5_P5 | CT_INP9 | SCT0_OUT3 | FLEXIO0_D17 | SMARTDMA_PIO5 | PLU_OUT1 | ENET0_TXD3 | I3C1_SCL |  |  | MED+I2C
C3 | P1_10 | 2 | P1_10 | 3 | P1_10 | 3 | P1_10 | VDD | DIS | CAN_TXD | TSI0_CH19/ADC1_A10 | P1_10 | TRACE_DATA2 | FC4_P2 | FC5_P6 | CT2_MAT0 | SCT0_IN2 | FLEXIO0_D18 | SMARTDMA_PIO6 | PLU_IN0 | ENET0_TXER |  | CAN0_TXD |  | MED
D3 | P1_11 | 3 | P1_11 | 4 | P1_11 | 4 | P1_11 | VDD | DIS | CAN_RXD | TSI0_CH20/ADC1_A11 | P1_11 | TRACE_DATA3 | FC4_P3 |  | CT2_MAT1 | SCT0_IN3 | FLEXIO0_D19 | SMARTDMA_PIO7 | PLU_IN1 | ENET0_RX_CLK | I3C1_PUR | CAN0_RXD | WUU0_IN11 | MED
D2 | P1_12 | 4 | P1_12 | 5 | P1_12 | 5 | P1_12 | VDD | DIS |  | TSI0_CH21/ADC1_A12 | P1_12 | TRACE_CLK | FC4_P4 | FC3_P0 | CT2_MAT2 | SCT0_OUT4 | FLEXIO0_D20 | SMARTDMA_PIO8 | PLU_OUT2 | ENET0_RXER |  | CAN1_RXD | WUU0_IN12 | MED
D1 | P1_13 | 5 | P1_13 | 6 | P1_13 | 6 | P1_13 | VDD | DIS |  | TSI0_CH22/ADC1_A13 | P1_13 | TRIG_IN3 | FC4_P5 | FC3_P1 | CT2_MAT3 | SCT0_OUT5 | FLEXIO0_D21 | SMARTDMA_PIO9 | PLU_OUT3 | ENET0_RXDV |  | CAN1_TXD |  | MED
D4 | P1_14 | 6 | P1_14 | 7 | P1_14 | 7 | P1_14 | VDD | DIS |  | TSI0_CH23/ADC1_A14 | P1_14 |  | FC4_P6 | FC3_P2 | CT_INP10 | SCT0_IN4 | FLEXIO0_D22 | SMARTDMA_PIO10 | PLU_IN2 | ENET0_RXD0 |  |  |  | MED
E4 | P1_15 | 7 | P1_15 | 8 | P1_15 | 8 | P1_15 | VDD | DIS |  | TSI0_CH24/ADC1_A15 | P1_15 |  |  | FC3_P3 | CT_INP11 | SCT0_IN5 | FLEXIO0_D23 | SMARTDMA_PIO11 | PLU_IN3 | ENET0_RXD1 | I3C1_PUR |  | WUU0_IN13 | MED
P14 | VSS |  |  |  |  |  |  | VDD |  |  |  |  |  |  |  |  |  |  |  |  |  |  |  |  | VSSIO
F6 | P1_16 | 8 | P1_16 |  |  |  |  | VDD | DIS |  | ADC1_A16 | P1_16 |  | FC5_P0 | FC3_P4 | CT_INP12 | SCT0_OUT6 | FLEXIO0_D24 | SMARTDMA_PIO12 | PLU_OUT4 | ENET0_RXD2 | I3C1_SDA |  | WUU0_IN14 | MED+I2C+I3C
F4 | P1_17 | 9 | P1_17 |  |  |  |  | VDD | DIS |  | ADC1_A17 | P1_17 |  | FC5_P1 | FC3_P5 | CT_INP13 | SCT0_OUT7 | FLEXIO0_D25 | SMARTDMA_PIO13 | PLU_OUT5 | ENET0_RXD3 | I3C1_SCL |  |  | MED+I2C
G4 | P1_18 | 10 | P1_18 |  |  |  |  | VDD | DIS |  | ADC1_A18 | P1_18 | FREQME_CLK_IN0 | FC5_P2 | FC3_P6 | CT3_MAT0 | SCT0_IN6 | FLEXIO0_D26 | SMARTDMA_PIO14 | PLU_IN4 | ENET0_COL |  | CAN0_TXD |  | MED
G5 | P1_19 | 11 | P1_19 |  |  |  |  | VDD | DIS |  | ADC1_A19 | P1_19 | FREQME_CLK_IN1 | FC5_P3 |  | CT3_MAT1 | SCT0_IN7 | FLEXIO0_D27 | SMARTDMA_PIO15 | PLU_IN5 | ENET0_CRS |  | CAN0_RXD | WUU0_IN15 | MED
K5 | P1_20 |  |  |  |  |  |  | VDD | DIS |  | ADC1_A20/CMP1_IN3 | P1_20 | TRIG_IN2 | FC5_P4 | FC4_P0 | CT3_MAT2 | SCT0_OUT8 | FLEXIO0_D28 | SMARTDMA_PIO16 | PLU_OUT6 | ENET0_MDC |  | CAN1_TXD |  | MED
L5 | P1_21 |  |  |  |  |  |  | VDD | DIS |  | ADC1_A21/CMP2_IN3 | P1_21 | TRIG_OUT2 | FC5_P5 | FC4_P1 | CT3_MAT3 | SCT0_OUT9 | FLEXIO0_D29 | SMARTDMA_PIO17 | PLU_OUT7 | ENET0_MDIO | SAI1_MCLK | CAN1_RXD |  | MED
L4 | P1_22 |  |  |  |  |  |  | VDD | DIS |  | ADC1_A22 | P1_22 | TRIG_IN3 | FC5_P6 | FC4_P2 | CT_INP14 | SCT0_OUT4 | FLEXIO0_D30 | SMARTDMA_PIO18 |  |  |  |  |  | MED
M4 | P1_23 |  |  |  |  |  |  | VDD | DIS |  | ADC1_A23 | P1_23 |  |  | FC4_P3 | CT_INP15 | SCT0_OUT5 | FLEXIO0_D31 | SMARTDMA_PIO19 |  |  |  |  |  | MED
F3 | RESET_B | 12 | RESET_B | 9 | RESET_B | 9 | RESET_B | VDD | RESET_B |  |  |  |  |  |  |  |  |  |  |  |  |  |  |  | RST
F1 | P1_30 | 13 | P1_30 | 10 | P1_30 | 10 | P1_30 | VDD | DIS |  | XTAL48M | P1_30 | TRIG_OUT3 |  |  | CT_INP16 | SCT0_OUT8 |  |  |  |  | SAI0_MCLK |  |  | MED
F2 | P1_31 | 14 | P1_31 | 11 | P1_31 | 11 | P1_31 | VDD | DIS |  | EXTAL48M | P1_31 | TRIG_IN4 |  |  | CT_INP17 | SCT0_OUT9 |  |  |  |  |  |  |  | MED
D6 | VSS | 15 | VSS | 0 | VSS | 0 | VSS | VDD |  |  |  |  |  |  |  |  |  |  |  |  |  |  |  |  | VSSIO
K10 | VDD_CORE | 16 | VDD_CORE | 12 | VDD_CORE | 12 | VDD_CORE | VDD |  |  |  |  |  |  |  |  |  |  |  |  |  |  |  |  | VDDINT
K6 | VDD_LDO_CORE | 17 | VDD_LDO_CORE | 13 | VDD | 13 | VDD | VDD |  |  | VDD_LDO_CORE |  |  |  |  |  |  |  |  |  |  |  |  |  | VDDINT_3V
H8 | VDD | 18 | VDD | 13 | VDD | 13 | VDD | VDD |  |  |  |  |  |  |  |  |  |  |  |  |  |  |  |  | VDDIO
K8 | VDD_P2 | 19 | VDD_P2 | 13 | VDD | 13 | VDD | VDD_P2 |  |  |  |  |  |  |  |  |  |  |  |  |  |  |  |  | VDDIO
E5 | VSS |  |  | 0 | VSS | 0 | VSS | VDD_P2 |  |  |  |  |  |  |  |  |  |  |  |  |  |  |  |  | VSSIO
H2 | P2_0 | 20 | P2_0 | 14 | P2_0 | 14 | P2_0 | VDD_P2 | DIS |  |  | P2_0 | TRIG_IN5 | FC9_P6 | uSDHC0_D5 | SCT0_IN0 | PWM1_A3 | FLEXIO0_D8 | SMARTDMA_PIO20 | FLEXSPI0_B_SS1_b |  | SAI0_RX_BCLK | ESPI0_RST |  | FAST
H1 | P2_1 | 21 | P2_1 | 15 | P2_1 | 15 | P2_1 | VDD_P2 | DIS |  |  | P2_1 | TRACE_CLK |  | uSDHC0_D4 | SCT0_IN1 | PWM1_B3 | FLEXIO0_D9 | SMARTDMA_PIO21 | FLEXSPI0_B_DQS | SINC0_MCLK_OUT0 | SAI0_RX_FS | ESPI0_NOTIFY |  | FAST
H3 | P2_2 | 22 | P2_2 | 16 | P2_2 | 16 | P2_2 | VDD_P2 | DIS |  |  | P2_2 | CLKOUT | FC9_P3 | uSDHC0_D1 | SCT0_OUT0 | PWM1_A2 | FLEXIO0_D10 | SMARTDMA_PIO22 | FLEXSPI0_B_SS0_b | SINC0_MCLK0 | SAI0_TXD0 | ESPI0_CSn | WUU0_IN16 | FAST
J3 | P2_3 | 23 | P2_3 | 17 | P2_3 | 17 | P2_3 | VDD_P2 | DIS |  |  | P2_3 |  | FC9_P1 | uSDHC0_D0 | SCT0_OUT1 | PWM1_B2 | FLEXIO0_D11 | SMARTDMA_PIO23 | FLEXSPI0_B_SCLK | SINC0_MBIT0 | SAI0_RXD0 | ESPI0_CLK |  | FAST
K3 | P2_4 | 24 | P2_4 | 18 | P2_4 | 18 | P2_4 | VDD_P2 | DIS |  |  | P2_4 |  | FC9_P0 | uSDHC0_CLK | SCT0_OUT2 | PWM1_A1 | FLEXIO0_D12 | SMARTDMA_PIO24 | FLEXSPI0_B_DATA0 | SINC0_MCLK1 | SAI0_RXD1 | ESPI0_DATA0 | WUU0_IN17 | FAST
K1 | P2_5 | 25 | P2_5 | 19 | P2_5 | 19 | P2_5 | VDD_P2 | DIS |  |  | P2_5 | TRIG_OUT3 | FC9_P2 | uSDHC0_CMD | SCT0_OUT3 | PWM1_B1 | FLEXIO0_D13 | SMARTDMA_PIO25 | FLEXSPI0_B_DATA1 | SINC0_MBIT1 | SAI0_TXD1 | ESPI0_DATA1 |  | FAST
G2 | VSS | 26 | VSS | 0 | VSS | 0 | VSS | VDD_P2 |  |  |  |  |  |  |  |  |  |  |  |  |  |  |  |  | VSSIO
L7 | VDD_P2 | 27 | VDD_P2 |  |  |  |  | VDD_P2 |  |  |  |  |  |  |  |  |  |  |  |  |  |  |  |  | VDDIO
K2 | P2_6 | 28 | P2_6 | 20 | P2_6 | 20 | P2_6 | VDD_P2 | DIS |  |  | P2_6 | TRIG_IN4 | FC9_P4 | uSDHC0_D3 | SCT0_OUT4 | PWM1_A0 | FLEXIO0_D14 | SMARTDMA_PIO26 | FLEXSPI0_B_DATA2 | SINC0_MCLK2 | SAI0_TX_BCLK | ESPI0_DATA2 |  | FAST
L2 | P2_7 | 29 | P2_7 | 21 | P2_7 | 21 | P2_7 | VDD_P2 | DIS |  |  | P2_7 | TRIG_IN5 | FC9_P5 | uSDHC0_D2 | SCT0_OUT5 | PWM1_B0 | FLEXIO0_D15 | SMARTDMA_PIO27 | FLEXSPI0_B_DATA3 | SINC0_MBIT2 | SAI0_TX_FS | ESPI0_DATA3 |  | FAST
M2 | P2_8 | 30 | P2_8 |  |  |  |  | VDD_P2 | DIS |  |  | P2_8 | TRACE_DATA0 |  | uSDHC0_D7 | SCT0_IN2 | PWM1_X0 | FLEXIO0_D16 | SMARTDMA_PIO28 | FLEXSPI0_B_DATA4 | SINC0_MCLK3 | SAI1_TXD0 |  |  | FAST
M1 | P2_9 | 31 | P2_9 |  |  |  |  | VDD_P2 | DIS |  |  | P2_9 | TRACE_DATA1 |  | uSDHC0_D6 | SCT0_IN3 | PWM1_X1 | FLEXIO0_D17 | SMARTDMA_PIO29 | FLEXSPI0_B_DATA5 | SINC0_MBIT3 | SAI1_RXD0 |  |  | FAST
M3 | P2_10 | 32 | P2_10 |  |  |  |  | VDD_P2 | DIS |  |  | P2_10 | TRACE_DATA2 |  |  | SCT0_IN4 | PWM1_X2 | FLEXIO0_D18 | SMARTDMA_PIO31 | FLEXSPI0_B_DATA6 | SINC0_MCLK4 | SAI1_RXD1 |  |  | FAST
N4 | P2_11 | 33 | P2_11 |  |  |  |  | VDD_P2 | DIS |  |  | P2_11 | TRACE_DATA3 |  |  | SCT0_IN5 | PWM1_X3 | FLEXIO0_D19 | SMARTDMA_PIO30 | FLEXSPI0_B_DATA7 | SINC0_MBIT4 | SAI1_TXD1 |  |  | FAST
H5 | VSS | 34 | VSS | 0 | VSS | 0 | VSS | VDD_P2 |  |  |  |  |  |  |  |  |  |  |  |  |  |  |  |  | VSSIO
 | VDD_P2 | 35 | VDD_P2 |  |  |  |  | VDD_P2 |  |  |  |  |  |  |  |  |  |  |  |  |  |  |  |  | VDDIO
P4 | VDD_P4 | 36 | VDD_P4 |  |  |  |  | VDD_P4 |  |  |  |  |  |  |  |  |  |  |  |  |  |  |  |  | VDDIO
P7 | VSS_P4 | 37 | VSS_P4 |  |  |  |  | VDD_P4 |  |  |  |  |  |  |  |  |  |  |  |  |  |  |  |  | VSSIO
P1 | P4_0 | 38 | P4_0 | 22 | P4_0/ANA_0 | 22 | P4_0/ANA_0 | VDD_P4 | DIS |  |  | P4_0 | TRIG_IN6 | FC2_P0 |  | CT_INP16 |  |  | SMARTDMA_PIO24 | PLU_IN0 | SINC0_MCLK3 |  |  | WUU0_IN18 | SLOW
P3 | ANA_0 | 39 | ANA_0 | 22 | P4_0/ANA_0 | 22 | P4_0/ANA_0 | VDD_P4 |  |  | ADC0_A0 |  |  |  |  |  |  |  |  |  |  |  |  |  | ANA
R3 | ANA_1 | 40 | ANA_1 | 23 | P4_1/ANA_1 | 23 | P4_1/ANA_1 | VDD_P4 |  |  | ADC0_B0 |  |  |  |  |  |  |  |  |  |  |  |  |  | ANA
P2 | P4_1 | 41 | P4_1 | 23 | P4_1/ANA_1 | 23 | P4_1/ANA_1 | VDD_P4 | DIS |  |  | P4_1 | TRIG_IN7 | FC2_P1 |  | CT_INP17 |  |  | SMARTDMA_PIO25 | PLU_IN1 |  |  |  |  | SLOW
T1 | P4_2 | 42 | P4_2 | 24 | P4_2 | 24 | P4_2 | VDD_P4 | DIS |  | DAC0_OUT/ADC0_A4/ADC1_A4/CMP0_IN4N/CMP1_IN4N/CMP2_IN4N | P4_2 | TRIG_IN6 | FC2_P2 |  | CT_INP12 |  |  | SMARTDMA_PIO26 | PLU_IN2 | SINC0_MBIT3 |  |  |  | SLOW
U1 | P4_3 | 43 | P4_3 | 25 | P4_3 | 25 | P4_3 | VDD_P4 | DIS |  | DAC1_OUT/ADC0_B4/ADC1_B4/CMP0_IN5N/CMP1_IN5N/CMP2_IN5N | P4_3 | TRIG_IN7 | FC2_P3 |  | CT_INP13 |  |  | SMARTDMA_PIO27 | PLU_IN3 |  |  |  | WUU0_IN19 | SLOW
M6 | P4_4 | 44 | P4_4 | 26 | P4_4/ANA_4 | 26 | P4_4/ANA_4 | VDD_P4 | DIS |  |  | P4_4 |  | FC2_P4 |  | CT_INP14 |  |  | SMARTDMA_PIO28 | PLU_IN4 | SINC0_MCLK4 |  |  |  | SLOW
T2 | ANA_4 | 45 | ANA_4 | 26 | P4_4/ANA_4 | 26 | P4_4/ANA_4 | VDD_P4 |  |  | ADC1_A0 |  |  |  |  |  |  |  |  |  |  |  |  |  | ANA
T3 | ANA_5 | 46 | ANA_5 | 27 | P4_5/ANA_5 | 27 | P4_5/ANA_5 | VDD_P4 |  |  | ADC1_B0 |  |  |  |  |  |  |  |  |  |  |  |  |  | ANA
M8 | P4_5 | 47 | P4_5 | 27 | P4_5/ANA_5 | 27 | P4_5/ANA_5 | VDD_P4 | DIS |  |  | P4_5 |  | FC2_P5 |  | CT_INP15 |  |  | SMARTDMA_PIO29 | PLU_IN5 | SINC0_MBIT4 |  |  |  | SLOW
U2 | ANA_6 | 48 | ANA_6 | 28 | P4_6/ANA_6 | 28 | P4_6/ANA_6 | VDD_P4 |  |  | DAC2_OUT/ADC0_A3/ADC1_A3 |  |  |  |  |  |  |  |  |  |  |  |  |  | ANA
N7 | P4_6 | 49 | P4_6 | 28 | P4_6/ANA_6 | 28 | P4_6/ANA_6 | VDD_P4 | DIS |  |  | P4_6 | TRIG_OUT4 | FC2_P6 |  | CT_INP18 |  |  | SMARTDMA_PIO30 | PLU_CLK |  |  |  |  | SLOW
T4 | P4_7 | 50 | P4_7 | 29 | P4_7/ANA_7 | 29 | P4_7/ANA_7 | VDD_P4 | DIS |  |  | P4_7 |  |  |  | CT_INP19 |  |  | SMARTDMA_PIO31 |  |  |  |  |  | SLOW
U4 | ANA_7 | 51 | ANA_7 | 29 | P4_7/ANA_7 | 29 | P4_7/ANA_7 | VDD_P4 |  |  | VREFI/VREFO/ADC0_A7/ADC1_A7 |  |  |  |  |  |  |  |  |  |  |  |  |  | ANA
R4 | VDD_ANA | 52 | VDD_ANA | 30 | VDD_ANA | 30 | VDD_ANA | VDD_P4 |  |  |  |  |  |  |  |  |  |  |  |  |  |  |  |  | VDDINT_3V
R5 | VREFH | 53 | VREFH | 31 | VREFH | 31 | VREFH | VDD_P4 |  |  | VREFH |  |  |  |  |  |  |  |  |  |  |  |  |  | ANA
R6 | VREFL | 54 | VREFL | 32 | VREFL | 32 | VREFL | VDD_P4 |  |  | VREFL |  |  |  |  |  |  |  |  |  |  |  |  |  | VSSINT
P6 | VSS_P4 | 55 | VSS_P4 | 33 | VSS_P4 | 33 | VSS_P4 | VDD_P4 |  |  |  |  |  |  |  |  |  |  |  |  |  |  |  |  | VSSIO
N5 | VDD_P4 | 56 | VDD_P4 | 34 | VDD_P4 | 34 | VDD_P4 | VDD_P4 |  |  |  |  |  |  |  |  |  |  |  |  |  |  |  |  | VDDIO
T6 | P4_12 | 57 | P4_12 | 35 | P4_12 | 35 | P4_12 | VDD_P4 | DIS | USB0_VBUS_DET | OPAMP0_INP0/ADC0_A5/ADC1_A5 | P4_12 | USB0_VBUS_DET | FC2_P0 |  | CT4_MAT0 |  | FLEXIO0_D20 |  | PLU_OUT0 | SINC0_MCLK0 |  | CAN0_RXD | WUU0_IN20 | SLOW
T7 | P4_13 | 58 | P4_13 | 36 | P4_13/ANA_14 | 36 | P4_13/ANA_14 | VDD_P4 | DIS |  | OPAMP0_INP1/ADC0_B5/ADC1_B5 | P4_13 | TRIG_IN8 | FC2_P1 | USB1_OTGn_ID | CT4_MAT1 |  | FLEXIO0_D21 |  | PLU_OUT1 | SINC0_MBIT0 |  | CAN0_TXD |  | SLOW
U6 | ANA_14 | 59 | ANA_14 | 36 | P4_13/ANA_14 | 36 | P4_13/ANA_14 | VDD_P4 |  |  | OPAMP0_INN |  |  |  |  |  |  |  |  |  |  |  |  |  | LOLK
N8 | P4_14 | 60 | P4_14 |  |  |  |  | VDD_P4 | DIS |  |  | P4_14 |  |  |  | CT4_MAT2 |  | FLEXIO0_D22 |  | PLU_OUT2 |  |  |  |  | SLOW
T8 | P4_15 | 61 | P4_15 | 37 | P4_15 | 37 | P4_15 | VDD_P4 | DIS |  | OPAMP0_OUT/ADC0_A1/CMP0_IN4P | P4_15 | TRIG_OUT4 |  | USB1_VBUSVALID_EXT | CT4_MAT3 |  | FLEXIO0_D23 |  | PLU_OUT3 | SINC0_MCLK_OUT0 |  | CAN1_RXD | WUU0_IN21 | SLOW
R8 | P4_16 | 62 | P4_16 | 38 | P4_16 | 38 | P4_16 | VDD_P4 | DIS |  | OPAMP1_INP0/ADC0_A6 | P4_16 |  | FC2_P2 | USB1_OTGn_PWR | CT3_MAT0 |  | FLEXIO0_D24 |  | PLU_OUT4 | SINC0_MCLK1 |  | CAN1_TXD |  | SLOW
R9 | P4_17 | 63 | P4_17 | 39 | P4_17/ANA_18 | 39 | P4_17/ANA_18 | VDD_P4 | DIS |  | OPAMP1_INP1/ADC0_B6 | P4_17 | TRIG_IN9 | FC2_P3 | USB1_OTGn_OC | CT3_MAT1 |  | FLEXIO0_D25 |  | PLU_OUT5 | SINC0_MBIT1 |  |  |  | SLOW
U8 | ANA_18 | 64 | ANA_18 | 39 | P4_17/ANA_18 | 39 | P4_17/ANA_18 | VDD_P4 |  |  | OPAMP1_INN |  |  |  |  |  |  |  |  |  |  |  |  |  | LOLK
N10 | P4_18 | 65 | P4_18 |  |  |  |  | VDD_P4 | DIS |  |  | P4_18 |  |  |  | CT3_MAT2 |  | FLEXIO0_D26 |  | PLU_OUT6 |  |  |  |  | SLOW
R10 | P4_19 | 66 | P4_19 | 40 | P4_19 |  |  | VDD_P4 | DIS |  | OPAMP1_OUT/ADC0_B1/CMP1_IN4P | P4_19 | TRIG_OUT5 |  |  | CT3_MAT3 |  | FLEXIO0_D27 |  | PLU_OUT7 | SINC0_MCLK_OUT1 |  |  |  | SLOW
T10 | P4_20 | 67 | P4_20 | 41 | P4_20 |  |  | VDD_P4 | DIS |  | OPAMP2_INP0/ADC1_A6 | P4_20 | TRIG_IN8 | FC2_P4 |  | CT2_MAT0 |  | FLEXIO0_D28 |  |  | SINC0_MCLK2 |  |  |  | SLOW
T11 | P4_21 | 68 | P4_21 | 42 | P4_21/ANA_22 |  |  | VDD_P4 | DIS |  | OPAMP2_INP1/ADC1_B6 | P4_21 | TRIG_IN9 | FC2_P5 |  | CT2_MAT1 |  | FLEXIO0_D29 |  |  | SINC0_MBIT2 |  |  |  | SLOW
U10 | ANA_22 | 69 | ANA_22 | 42 | P4_21/ANA_22 |  |  | VDD_P4 |  |  | OPAMP2_INN |  |  |  |  |  |  |  |  |  |  |  |  |  | LOLK
T12 | P4_22 | 70 | P4_22 |  |  |  |  | VDD_P4 | DIS |  |  | P4_22 |  |  |  | CT2_MAT2 |  | FLEXIO0_D30 |  |  |  |  |  |  | SLOW
U12 | P4_23 | 71 | P4_23 | 43 | P4_23 |  |  | VDD_P4 | DIS |  | OPAMP2_OUT/ADC0_A2/ADC0_B2/ADC1_B3/CMP2_IN4P | P4_23 | TRIG_OUT5 | FC2_P6 |  | CT2_MAT3 |  | FLEXIO0_D31 |  |  | SINC0_MCLK_OUT2 |  |  |  | SLOW
P9 | VSS_P4 | 72 | VSS_P4 |  |  |  |  | VDD_P4 |  |  |  |  |  |  |  |  |  |  |  |  |  |  |  |  | VSSIO
 | VDD_P4 | 73 | VDD_P4 |  |  |  |  | VDD_P4 |  |  |  |  |  |  |  |  |  |  |  |  |  |  |  |  | VDDIO
J4 | VSS |  |  |  |  | 0 | VSS | VDD_USB |  |  |  |  |  |  |  |  |  |  |  |  |  |  |  |  | VSSIO
R13 | USB1_DP | 74 | USB1_DP |  |  | 40 | USB1_DP | VDD_USB |  |  | USB1_DP |  |  |  |  |  |  |  |  |  |  |  |  |  | ANA
R14 | USB1_DM | 75 | USB1_DM |  |  | 41 | USB1_DM | VDD_USB |  |  | USB1_DM |  |  |  |  |  |  |  |  |  |  |  |  |  | ANA
P11 | USB1_ID |  |  |  |  |  |  | VDD_USB |  |  | USB1_ID |  |  |  |  |  |  |  |  |  |  |  |  |  | ANA
U14 | USB1_VBUS | 76 | USB1_VBUS |  |  | 42 | USB1_VBUS | VDD_USB |  |  | USB1_VBUS |  |  |  |  |  |  |  |  |  |  |  |  |  | VDDINT_5V
J8 | VSS | 77 | VSS |  |  | 43 | VSS | VDD_USB |  |  |  |  |  |  |  |  |  |  |  |  |  |  |  |  | VSSIO
R12 | VDD_USB | 78 | VDD_USB | 44 | VDD_USB | 44 | VDD_USB | VDD_USB |  |  |  |  |  |  |  |  |  |  |  |  |  |  |  |  | VDDIO
T14 | USB0_DM | 79 | USB0_DM | 45 | USB0_DM | 45 | USB0_DM | VDD_USB |  |  | USB0_DM |  |  |  |  |  |  |  |  |  |  |  |  | WUU0_IN28 | ANA
T15 | USB0_DP | 80 | USB0_DP | 46 | USB0_DP | 46 | USB0_DP | VDD_USB |  |  | USB0_DP |  |  |  |  |  |  |  |  |  |  |  |  | WUU0_IN29 | ANA
T16 | VSS | 81 | VSS | 0 | VSS | 0 | VSS | VDD_BAT |  |  |  |  |  |  |  |  |  |  |  |  |  |  |  |  | VSSIO
T17 | VDD_BAT | 82 | VDD_BAT | 47 | VDD_BAT | 47 | VDD_BAT | VDD_BAT |  |  |  |  |  |  |  |  |  |  |  |  |  |  |  |  | VDDIO
U16 | P5_0 | 83 | P5_0 | 48 | P5_0 | 48 | P5_0 | VDD_BAT | DIS |  | EXTAL32K/ADC1_B8 | P5_0 | TRIG_IN10 | LPTMR0_ALT2 |  |  |  |  |  |  |  |  |  |  | AON
U17 | P5_1 | 84 | P5_1 | 49 | P5_1 | 49 | P5_1 | VDD_BAT | DIS |  | XTAL32K/ADC1_B9 | P5_1 | TRIG_OUT6 | LPTMR1_ALT2 |  |  |  |  |  |  |  |  |  |  | AON
M10 | P5_2 | 85 | P5_2 | 50 | P5_2 | 50 | P5_2 | VDD_BAT | ALT1 |  | ADC1_B10 | P5_2 | VBAT_WAKEUP_b | SPC_LPREQ | TAMPER0 |  |  |  |  |  |  |  |  |  | RST
N11 | P5_3 | 86 | P5_3 | 51 | P5_3 | 51 | P5_3 | VDD_BAT | DIS |  | ADC1_B11 | P5_3 | TRIG_IN11 | RTC_CLKOUT | TAMPER1 |  |  |  |  |  |  |  |  |  | AON
M12 | P5_4 | 87 | P5_4 |  |  |  |  | VDD_BAT | DIS |  | ADC1_B12 | P5_4 | TRIG_OUT7 | SPC_LPREQ | TAMPER2 |  |  |  |  |  |  |  |  |  | AON
K12 | P5_5 | 88 | P5_5 |  |  |  |  | VDD_BAT | DIS |  | ADC1_B13 | P5_5 | TRIG_IN10 | LPTMR0_ALT2 | TAMPER3 |  |  |  |  |  |  |  |  |  | AON
K13 | P5_6 | 89 | P5_6 |  |  |  |  | VDD_BAT | DIS |  | ADC1_B14 | P5_6 | TRIG_OUT6 | LPTMR1_ALT2 | TAMPER4 |  |  |  |  |  |  |  |  |  | AON
L13 | P5_7 | 90 | P5_7 |  |  |  |  | VDD_BAT | DIS |  | ADC1_B15 | P5_7 | TRIG_IN11 |  | TAMPER5 |  |  |  |  |  |  |  |  |  | AON
L14 | P5_8 | 91 | P5_8 |  |  |  |  | VDD_BAT | DIS |  | ADC1_B16 | P5_8 | TRIG_OUT7 |  | TAMPER6 |  |  |  |  |  |  |  |  |  | AON
M14 | P5_9 | 92 | P5_9 |  |  |  |  | VDD_BAT | DIS |  | ADC1_B17 | P5_9 |  |  | TAMPER7 |  |  |  |  |  |  |  |  |  | AON
E13 | VSS |  |  |  |  |  |  | VDD_BAT |  |  |  |  |  |  |  |  |  |  |  |  |  |  |  |  | VSSIO
P16 | VSS_DCDC | 93,94 | VSS_DCDC | 52 | VSS_DCDC | 52 | VSS_DCDC | VDD_DCDC |  |  |  |  |  |  |  |  |  |  |  |  |  |  |  |  | VSSIO
P17 | DCDC_LX | 95,96 | DCDC_LX | 53 | DCDC_LX | 53 | DCDC_LX | VDD_DCDC |  |  | DCDC_LX |  |  |  |  |  |  |  |  |  |  |  |  |  | ANA
R15 | VDD_DCDC | 97 | VDD_DCDC | 54 | VDD_DCDC | 54 | VDD_DCDC | VDD_DCDC |  |  |  |  |  |  |  |  |  |  |  |  |  |  |  |  | VDDIO
P15 | VDD_LDO_SYS | 98 | VDD_LDO_SYS | 54 | VDD_DCDC | 54 | VDD_DCDC | VDD_P3 |  |  |  |  |  |  |  |  |  |  |  |  |  |  |  |  | VDDIO
N14 | VDD_SYS | 99 | VDD_SYS | 55 | VDD_SYS | 55 | VDD_SYS | VDD_P3 |  |  |  |  |  |  |  |  |  |  |  |  |  |  |  |  | VDDINT
J14 | VSS |  |  | 0 | VSS | 0 | VSS | VDD_P3 |  |  |  |  |  |  |  |  |  |  |  |  |  |  |  |  | VSSIO
M15 | P3_23 | 100 | P3_23 |  |  |  |  | VDD_P3 | DIS |  |  | P3_23 |  |  | FC6_P3 | CT_INP11 | PWM1_X3 | FLEXIO0_D31 | SMARTDMA_PIO23 |  |  | SAI1_TXD1 |  |  | FAST
M16 | P3_22 | 101 | P3_22 |  |  |  |  | VDD_P3 | DIS |  |  | P3_22 |  | FC8_P6 | FC6_P2 | CT_INP10 | PWM1_X2 | FLEXIO0_D30 | SMARTDMA_PIO22 |  | SIM0_VCCEN | SAI1_RXD1 |  |  | FAST
L16 | P3_21 | 102 | P3_21 | 56 | P3_21 | 56 | P3_21 | VDD_P3 | DIS |  |  | P3_21 | TRIG_OUT1 | FC8_P5 | FC6_P1 | CT2_MAT3 | PWM1_B3 | FLEXIO0_D29 | SMARTDMA_PIO21 |  | SIM0_RST | SAI1_RXD0 | PF_SPI_CS1_DIS_n |  | FAST
M17 | P3_20 | 103 | P3_20 | 57 | P3_20 | 57 | P3_20 | VDD_P3 | DIS |  |  | P3_20 | TRIG_OUT0 | FC8_P4 | FC6_P0 | CT2_MAT2 | PWM1_A3 | FLEXIO0_D28 | SMARTDMA_PIO20 |  | SIM0_PD | SAI1_TXD0 | PF_SPI_CS0_DIS_n | WUU0_IN27 | FAST
K17 | P3_19 |  |  |  |  |  |  | VDD_P3 | DIS |  |  | P3_19 |  | FC7_P6 |  | CT2_MAT1 | PWM1_X1 | FLEXIO0_D27 | SMARTDMA_PIO19 |  |  | SAI1_RX_FS |  |  | FAST
K9 | VSS | 104 | VSS | 0 | VSS | 0 | VSS | VDD_P3 |  |  |  |  |  |  |  |  |  |  |  |  |  |  |  |  | VSSIO
L11 | VDD_CORE | 105 | VDD_CORE | 58 | VDD_CORE | 58 | VDD_CORE | VDD_P3 |  |  |  |  |  |  |  |  |  |  |  |  |  |  |  |  | VDDINT
G11 | VDD_P3 | 106 | VDD_P3 | 59 | VDD_P3 | 59 | VDD_P3 | VDD_P3 |  |  |  |  |  |  |  |  |  |  |  |  |  |  |  |  | VDDIO
K16 | P3_18 |  |  |  |  |  |  | VDD_P3 | DIS |  |  | P3_18 |  |  | FC6_P6 | CT2_MAT0 | PWM1_X0 | FLEXIO0_D26 | SMARTDMA_PIO18 |  |  | SAI1_RX_BCLK |  |  | FAST
K15 | P3_17 | 107 | P3_17 | 60 | P3_17 | 60 | P3_17 | VDD_P3 | DIS |  |  | P3_17 |  | FC8_P3 |  | CT_INP9 | PWM1_B2 | FLEXIO0_D25 | SMARTDMA_PIO17 |  | SIM0_IO | SAI1_TX_FS |  | WUU0_IN26 | FAST
J15 | P3_16 | 108 | P3_16 | 61 | P3_16 | 61 | P3_16 | VDD_P3 | DIS |  |  | P3_16 |  | FC8_P2 |  | CT_INP8 | PWM1_A2 | FLEXIO0_D24 | SMARTDMA_PIO16 |  | SIM0_CLK | SAI1_TX_BCLK |  |  | FAST
H15 | P3_15 | 109 | P3_15 | 62 | P3_15 | 62 | P3_15 | VDD_P3 | DIS |  |  | P3_15 |  | FC8_P1 |  | CT_INP7 | PWM1_B1 | FLEXIO0_D23 | SMARTDMA_PIO15 | FLEXSPI0_A_DATA7 |  | SAI0_RX_FS | PF_SPI_SCKIN |  | FAST
H17 | P3_14 | 110 | P3_14 | 63 | P3_14 | 63 | P3_14 | VDD_P3 | DIS |  |  | P3_14 |  | FC8_P0 |  | CT_INP6 | PWM1_A1 | FLEXIO0_D22 | SMARTDMA_PIO14 | FLEXSPI0_A_DATA6 |  | SAI0_RX_BCLK | PF_SPI_DATA | WUU0_IN25 | FAST
H16 | P3_13 | 111 | P3_13 | 64 | P3_13 | 64 | P3_13 | VDD_P3 | DIS |  |  | P3_13 |  | FC7_P5 | FC6_P5 | CT1_MAT3 | PWM1_B0 | FLEXIO0_D21 | SMARTDMA_PIO13 | FLEXSPI0_A_DATA5 |  | SAI0_TXD1 | PF_SPI_CS0_n |  | FAST
G16 | P3_12 | 112 | P3_12 | 65 | P3_12 | 65 | P3_12 | VDD_P3 | DIS |  |  | P3_12 |  | FC7_P4 | FC6_P4 | CT1_MAT2 | PWM1_A0 | FLEXIO0_D20 | SMARTDMA_PIO12 | FLEXSPI0_A_DATA4 |  | SAI0_RXD1 |  |  | FAST
N13 | VSS | 113 | VSS | 0 | VSS | 0 | VSS | VDD_P3 |  |  |  |  |  |  |  |  |  |  |  |  |  |  |  |  | VSSIO
H10 | VDD_P3 | 114 | VDD_P3 | 66 | VDD_P3 | 66 | VDD_P3 | VDD_P3 |  |  |  |  |  |  |  |  |  |  |  |  |  |  |  |  | VDDIO
F16 | P3_11 | 115 | P3_11 | 67 | P3_11 | 67 | P3_11 | VDD_P3 | DIS |  |  | P3_11 |  | FC6_P3 | FC7_P5 | CT1_MAT1 | PWM0_B3 | FLEXIO0_D19 | SMARTDMA_PIO11 | FLEXSPI0_A_DATA3 | SIM0_IO | SAI0_RXD0 | PF_QSPI_DATA3 | WUU0_IN24 | FAST
F17 | P3_10 | 116 | P3_10 | 68 | P3_10 | 68 | P3_10 | VDD_P3 | DIS |  |  | P3_10 |  | FC6_P2 | FC7_P4 | CT1_MAT0 | PWM0_A3 | FLEXIO0_D18 | SMARTDMA_PIO10 | FLEXSPI0_A_DATA2 | SIM0_CLK | SAI0_TXD0 | PF_QSPI_DATA2 |  | FAST
F15 | P3_9 | 117 | P3_9 | 69 | P3_9 | 69 | P3_9 | VDD_P3 | DIS |  |  | P3_9 |  | FC6_P5 | FC7_P2 | CT_INP5 | PWM0_B2 | FLEXIO0_D17 | SMARTDMA_PIO9 | FLEXSPI0_A_DATA1 | SIM0_RST | SAI0_TX_FS | PF_QSPI_DATA1 |  | FAST
E14 | P3_8 | 118 | P3_8 | 70 | P3_8 | 70 | P3_8 | VDD_P3 | DIS |  |  | P3_8 |  | FC6_P4 | FC7_P0 | CT_INP4 | PWM0_A2 | FLEXIO0_D16 | SMARTDMA_PIO8 | FLEXSPI0_A_DATA0 | SIM0_PD | SAI0_TX_BCLK | PF_QSPI_DATA0 | WUU0_IN23 | FAST
D14 | P3_7 | 119 | P3_7 | 71 | P3_7 | 71 | P3_7 | VDD_P3 | DIS |  |  | P3_7 |  | FC6_P6 | FC7_P1 | CT4_MAT3 | PWM0_B1 | FLEXIO0_D15 | SMARTDMA_PIO7 | FLEXSPI0_A_SCLK | SIM0_VCCEN | SAI0_MCLK | PF_QSPI_SCKIN |  | FAST
D17 | P3_6 | 120 | P3_6 | 72 | P3_6 | 72 | P3_6 | VDD_P3 | DIS |  |  | P3_6 | CLKOUT | FC6_P1 |  | CT4_MAT2 | PWM0_A1 | FLEXIO0_D14 | SMARTDMA_PIO6 | FLEXSPI0_A_DQS | SIM1_VCCEN | SAI1_MCLK | PF_QSPI_CS_n |  | FAST
P12 | VSS | 121 | VSS | 0 | VSS | 0 | VSS | VDD_P3 |  |  |  |  |  |  |  |  |  |  |  |  |  |  |  |  | VSSIO
H12 | VDD_P3 | 122 | VDD_P3 | 73 | VDD_P3 | 73 | VDD_P3 | VDD_P3 |  |  |  |  |  |  |  |  |  |  |  |  |  |  |  |  | VDDIO
G14 | P3_5 | 123 | P3_5 |  |  |  |  | VDD_P3 | DIS |  |  | P3_5 |  | FC7_P3 |  | CT_INP19 | PWM0_X3 | FLEXIO0_D13 | SMARTDMA_PIO5 |  | SIM1_IO |  |  |  | FAST
F14 | P3_4 | 124 | P3_4 |  |  |  |  | VDD_P3 | DIS |  |  | P3_4 |  | FC7_P2 |  | CT_INP18 | PWM0_X2 | FLEXIO0_D12 | SMARTDMA_PIO4 |  | SIM1_CLK |  |  |  | FAST
D16 | P3_3 | 125 | P3_3 |  |  |  |  | VDD_P3 | DIS |  |  | P3_3 |  | FC7_P1 |  | CT4_MAT1 | PWM0_X1 | FLEXIO0_D11 | SMARTDMA_PIO3 |  | SIM1_RST |  |  |  | FAST
D15 | P3_2 | 126 | P3_2 |  |  |  |  | VDD_P3 | DIS |  |  | P3_2 |  | FC7_P0 |  | CT4_MAT0 | PWM0_X0 | FLEXIO0_D10 | SMARTDMA_PIO2 |  | SIM1_PD |  |  |  | FAST
C15 | P3_1 | 127 | P3_1 | 74 | P3_1 | 74 | P3_1 | VDD_P3 | DIS |  |  | P3_1 | TRIG_IN1 | FC6_P0 | FC7_P6 | CT_INP17 | PWM0_B0 | FLEXIO0_D9 | SMARTDMA_PIO1 | FLEXSPI0_A_SS1_b |  |  | PF_QSPI_CS1_DIS |  | FAST
B17 | P3_0 | 128 | P3_0 | 75 | P3_0 | 75 | P3_0 | VDD_P3 | DIS |  |  | P3_0 | TRIG_IN0 |  | FC7_P3 | CT_INP16 | PWM0_A0 | FLEXIO0_D8 | SMARTDMA_PIO0 | FLEXSPI0_A_SS0_b |  |  | PF_QSPI_CS0_DIS | WUU0_IN22 | FAST
H9 | VSS |  |  |  |  |  |  | VDD_P3 |  |  |  |  |  |  |  |  |  |  |  |  |  |  |  |  | VSSIO
 | VDD_P3 | 129 | VDD_P3 |  |  |  |  | VDD_P3 |  |  |  |  |  |  |  |  |  |  |  |  |  |  |  |  | VDDIO
 | VDD | 130 | VDD |  |  |  |  | VDD |  |  |  |  |  |  |  |  |  |  |  |  |  |  |  |  | VDDIO
J10 | VSS | 131 | VSS |  |  |  |  | VDD |  |  |  |  |  |  |  |  |  |  |  |  |  |  |  |  | VSSIO
A17 | P0_0 | 132 | P0_0 | 76 | P0_0 | 76 | P0_0 | VDD | ALT1 |  |  | P0_0 | TMS/SWDIO | FC1_P0 |  | CT_INP0 |  |  |  |  |  |  |  |  | MED
A16 | P0_1 | 133 | P0_1 | 77 | P0_1 | 77 | P0_1 | VDD | ALT1 |  |  | P0_1 | TCLK/SWCLK | FC1_P1 |  | CT_INP1 |  |  |  |  |  |  |  |  | MED
B16 | P0_2 | 134 | P0_2 | 78 | P0_2 | 78 | P0_2 | VDD | ALT1 |  |  | P0_2 | TDO/SWO | FC1_P2 |  | CT0_MAT0 | UTICK_CAP0 |  |  |  |  | I3C0_PUR |  |  | MED
B15 | P0_3 | 135 | P0_3 | 79 | P0_3 | 79 | P0_3 | VDD | ALT1 |  | CMP1_IN1 | P0_3 | TDI | FC1_P3 |  | CT0_MAT1 | UTICK_CAP1 |  |  | HSCMP0_OUT |  |  |  |  | MED
B14 | P0_4 | 136 | P0_4 | 80 | P0_4 | 80 | P0_4 | VDD | DIS |  | TSI0_CH8 | P0_4 | EWM0_IN | FC0_P0 | FC1_P4 | CT0_MAT2 | UTICK_CAP2 |  |  | HSCMP1_OUT | PDM0_CLK |  |  | WUU0_IN0 | MED+I2C
A14 | P0_5 | 137 | P0_5 | 81 | P0_5 | 81 | P0_5 | VDD | DIS |  | TSI0_CH9 | P0_5 | EWM0_OUT_b | FC0_P1 | FC1_P5 | CT0_MAT3 | UTICK_CAP3 |  |  |  | PDM0_DATA0 |  |  |  | MED+I2C
C14 | P0_6 | 138 | P0_6 | 82 | P0_6 | 82 | P0_6 | VDD | ALT1 | ISPMODE_N | TSI0_CH10 | P0_6 | ISPMODE_N | FC0_P2 | FC1_P6 | CT_INP2 |  |  |  | HSCMP2_OUT | PDM0_DATA1 |  |  |  | MED
C13 | P0_7 | 139 | P0_7 |  |  |  |  | VDD | DIS |  | CMP2_IN1 | P0_7 |  | FC0_P3 |  | CT_INP3 |  |  |  |  |  |  |  | WUU0_IN1 | MED
C12 | P0_8 | 140 | P0_8 |  |  |  |  | VDD | DIS |  | ADC0_B8 | P0_8 |  | FC0_P4 |  | CT_INP0 |  | FLEXIO0_D0 |  |  |  |  |  |  | MED
A12 | P0_9 | 141 | P0_9 |  |  |  |  | VDD | DIS |  | ADC0_B9 | P0_9 |  | FC0_P5 |  | CT_INP1 |  | FLEXIO0_D1 |  |  |  |  |  |  | MED
B12 | P0_10 | 142 | P0_10 |  |  |  |  | VDD | DIS |  | ADC0_B10 | P0_10 |  | FC0_P6 |  | CT0_MAT0 |  | FLEXIO0_D2 |  |  |  |  |  |  | MED
B11 | P0_11 | 143 | P0_11 |  |  |  |  | VDD | DIS |  | ADC0_B11 | P0_11 |  |  |  | CT0_MAT1 |  | FLEXIO0_D3 |  | HSCMP2_OUT |  |  |  |  | MED
G7 | VDD | 144 | VDD | 83 | VDD | 83 | VDD | VDD |  |  |  |  |  |  |  |  |  |  |  |  |  |  |  |  | VDDIO
D9 | VSS | 145 | VSS | 0 | VSS | 0 | VSS | VDD |  |  |  |  |  |  |  |  |  |  |  |  |  |  |  |  | VSSIO
D11 | P0_12 | 146 | P0_12 |  |  |  |  | VDD | DIS |  | ADC0_B12/NVM_TM0 | P0_12 |  | FC1_P4 | FC0_P0 | CT0_MAT2 |  | FLEXIO0_D4 |  |  |  |  |  |  | MED
F12 | P0_13 | 147 | P0_13 |  |  |  |  | VDD | DIS |  | ADC0_B13/NVM_TM1 | P0_13 |  | FC1_P5 | FC0_P1 | CT0_MAT3 |  | FLEXIO0_D5 |  |  |  |  |  |  | MED
E11 | P0_14 | 148 | P0_14 |  |  |  |  | VDD | DIS |  | ADC0_B14/NVM_TM2 | P0_14 |  | FC1_P6 | FC0_P2 | CT_INP2 | UTICK_CAP0 | FLEXIO0_D6 |  |  |  |  |  |  | MED
G13 | P0_15 | 149 | P0_15 |  |  |  |  | VDD | DIS |  | ADC0_B15/NVM_TM3 | P0_15 |  |  | FC0_P3 | CT_INP3 | UTICK_CAP1 | FLEXIO0_D7 |  |  |  |  |  |  | MED
B10 | P0_16 | 150 | P0_16 | 84 | P0_16 | 84 | P0_16 | VDD | DIS | I2C_SDA | TSI0_CH11/ADC0_A8 | P0_16 |  | FC0_P0 |  | CT0_MAT0 | UTICK_CAP2 | FLEXIO0_D0 |  |  | PDM0_CLK | I3C0_SDA |  | WUU0_IN2 | MED+I2C+I3C
A10 | P0_17 | 151 | P0_17 | 85 | P0_17 | 85 | P0_17 | VDD | DIS | I2C_SCL | TSI0_CH12/ADC0_A9 | P0_17 |  | FC0_P1 |  | CT0_MAT1 | UTICK_CAP3 | FLEXIO0_D1 |  |  | PDM0_DATA0 | I3C0_SCL |  |  | MED+I2C
C10 | P0_18 | 152 | P0_18 | 86 | P0_18 | 86 | P0_18 | VDD | DIS |  | TSI0_CH13/ADC0_A10 | P0_18 | EWM0_IN | FC0_P2 |  | CT0_MAT2 |  | FLEXIO0_D2 |  | HSCMP0_OUT | PDM0_DATA1 |  |  |  | MED
C9 | P0_19 | 153 | P0_19 | 87 | P0_19 | 87 | P0_19 | VDD | DIS |  | TSI0_CH14/ADC0_A11 | P0_19 | EWM0_OUT_b | FC0_P3 |  | CT0_MAT3 |  | FLEXIO0_D3 |  | HSCMP1_OUT |  |  |  | WUU0_IN3 | MED
C8 | P0_20 | 154 | P0_20 | 88 | P0_20 | 88 | P0_20 | VDD | DIS |  | TSI0_CH15/ADC0_A12 | P0_20 |  | FC0_P4 | FC1_P0 | CT_INP0 |  | FLEXIO0_D4 |  |  |  | I3C0_SDA |  | WUU0_IN4 | MED+I2C+I3C
A8 | P0_21 | 155 | P0_21 | 89 | P0_21 | 89 | P0_21 | VDD | DIS |  | TSI0_CH16/ADC0_A13 | P0_21 |  | FC0_P5 | FC1_P1 | CT_INP1 |  | FLEXIO0_D5 |  |  |  | I3C0_SCL |  |  | MED+I2C
B8 | P0_22 | 156 | P0_22 | 90 | P0_22 | 90 | P0_22 | VDD | DIS |  | ADC0_A14/CMP1_IN2 | P0_22 | EWM0_IN | FC0_P6 | FC1_P2 | CT_INP2 |  | FLEXIO0_D6 |  |  |  | I3C0_PUR |  |  | MED
B7 | P0_23 | 157 | P0_23 | 91 | P0_23 | 91 | P0_23 | VDD | DIS |  | ADC0_A15/CMP2_IN2 | P0_23 | EWM0_OUT_b |  | FC1_P3 | CT_INP3 |  | FLEXIO0_D7 |  |  |  |  |  | WUU0_IN5 | MED
H13 | VSS |  |  |  |  |  |  | VDD |  |  |  |  |  |  |  |  |  |  |  |  |  |  |  |  | VSSIO
B6 | P0_24 | 158 | P0_24 |  |  |  |  | VDD | DIS |  | ADC0_B16 | P0_24 |  | FC1_P0 |  | CT0_MAT0 |  |  |  |  |  |  |  |  | MED
A6 | P0_25 | 159 | P0_25 |  |  |  |  | VDD | DIS |  | ADC0_B17 | P0_25 |  | FC1_P1 |  | CT0_MAT1 |  |  |  |  |  |  |  |  | MED
F10 | P0_26 | 160 | P0_26 |  |  |  |  | VDD | DIS |  | ADC0_B18 | P0_26 |  | FC1_P2 |  | CT0_MAT2 |  |  |  |  |  |  |  |  | MED
E10 | P0_27 | 161 | P0_27 |  |  |  |  | VDD | DIS |  | ADC0_B19 | P0_27 |  | FC1_P3 |  | CT0_MAT3 |  |  |  |  |  |  |  |  | MED
E8 | P0_28 |  |  |  |  |  |  | VDD | DIS |  | ADC0_B20 | P0_28 |  | FC1_P4 | FC0_P4 | CT_INP0 |  |  |  |  |  |  |  |  | MED
F8 | P0_29 |  |  |  |  |  |  | VDD | DIS |  | ADC0_B21 | P0_29 |  | FC1_P5 | FC0_P5 | CT_INP1 |  |  |  |  |  |  |  |  | MED
E7 | P0_30 |  |  |  |  |  |  | VDD | DIS |  | ADC0_B22 | P0_30 |  | FC1_P6 | FC0_P6 | CT_INP2 |  |  |  |  |  |  |  |  | MED
D7 | P0_31 |  |  |  |  |  |  | VDD | DIS |  | ADC0_B23 | P0_31 |  |  |  | CT_INP3 |  |  |  |  |  |  |  |  | MED
C6 | P1_0 | 162 | P1_0 | 92 | P1_0 | 92 | P1_0 | VDD | DIS | SPI_SDO | TSI0_CH0/ADC0_A16/CMP0_IN0 | P1_0 | TRIG_IN0 | FC3_P0 | FC4_P4 | CT_INP4 | SCT0_OUT6 | FLEXIO0_D8 |  |  |  | SAI1_TX_BCLK |  | WUU0_IN6/LPTMR0_ALT3 | MED+I2C
C5 | P1_1 | 163 | P1_1 | 93 | P1_1 | 93 | P1_1 | VDD | DIS | SPI_SCK | TSI0_CH1/ADC0_A17/CMP1_IN0 | P1_1 | TRIG_IN1 | FC3_P1 | FC4_P5 | CT_INP5 | SCT0_OUT7 | FLEXIO0_D9 |  |  |  | SAI1_TX_FS |  |  | MED+I2C
C4 | P1_2 | 164 | P1_2 | 94 | P1_2 | 94 | P1_2 | VDD | DIS | SPI_SDI | TSI0_CH2/ADC0_A18/CMP2_IN0 | P1_2 | TRIG_OUT0 | FC3_P2 | FC4_P6 | CT1_MAT0 | SCT0_IN6 | FLEXIO0_D10 |  |  | ENET0_MDC | SAI1_TXD0 | CAN0_TXD |  | MED
B4 | P1_3 | 165 | P1_3 | 95 | P1_3 | 95 | P1_3 | VDD | DIS | SPI_PCS | TSI0_CH3/ADC0_A19/CMP0_IN1 | P1_3 | TRIG_OUT1 | FC3_P3 |  | CT1_MAT1 | SCT0_IN7 | FLEXIO0_D11 |  |  | ENET0_MDIO | SAI1_RXD0 | CAN0_RXD | WUU0_IN7 | MED
H6 | VDD | 166 | VDD | 96 | VDD | 96 | VDD | VDD |  |  |  |  |  |  |  |  |  |  |  |  |  |  |  |  | VDDIO
D12 | VSS | 167 | VSS | 0 | VSS | 0 | VSS | VDD |  |  |  |  |  |  |  |  |  |  |  |  |  |  |  |  | VSSIO
A4 | P1_4 | 168 | P1_4 | 97 | P1_4 | 97 | P1_4 | VDD | DIS |  | TSI0_CH4/ADC0_A20/CMP0_IN2 | P1_4 | FREQME_CLK_IN0 | FC3_P4 | FC5_P0 | CT1_MAT2 | SCT0_OUT0 | FLEXIO0_D12 | SMARTDMA_PIO0 |  | ENET0_TX_CLK | SAI0_TXD1 |  | WUU0_IN8 | MED
B3 | P1_5 | 169 | P1_5 | 98 | P1_5 | 98 | P1_5 | VDD | DIS |  | TSI0_CH5/ADC0_A21/CMP0_IN3 | P1_5 | FREQME_CLK_IN1 | FC3_P5 | FC5_P1 | CT1_MAT3 | SCT0_OUT1 | FLEXIO0_D13 | SMARTDMA_PIO1 |  | ENET0_TXEN | SAI0_RXD1 |  |  | MED
B2 | P1_6 | 170 | P1_6 | 99 | P1_6 | 99 | P1_6 | VDD | DIS |  | TSI0_CH6/ADC0_A22 | P1_6 | TRIG_IN2 | FC3_P6 | FC5_P2 | CT_INP6 | SCT0_IN0 | FLEXIO0_D14 | SMARTDMA_PIO2 |  | ENET0_TXD0 | SAI1_RX_BCLK | CAN1_TXD |  | MED
A2 | P1_7 | 171 | P1_7 | 100 | P1_7 | 100 | P1_7 | VDD | DIS |  | TSI0_CH7/ADC0_A23 | P1_7 | TRIG_OUT2 |  | FC5_P3 | CT_INP7 | SCT0_IN1 | FLEXIO0_D15 | SMARTDMA_PIO3 | PLU_CLK | ENET0_TXD1 | SAI1_RX_FS | CAN1_RXD | WUU0_IN9 | MED
Note: 1. For BGA package, all balls with same name are shorted together on BGA package. 2. VSS_ANA and VSS_P4 are shorted together on package. 3. +I3C in Pad Type means strong pull up resistor is implemented on the pin. PV bit is implemented in the Pin Control register of the pin. 4. +I2C in Pad Type represents I2C filter is implemented on the pin. PFE bit is implemented in the Pin Control register of the pin. 5. DIS in default column means the pin's input buffer is disabled by default. 6. AON and RST pads support passive filter. PFE bit is implemented in the Pin Control register of the pin. 7. PE, PS, SRE, and DSE are supported in the Pin Control register of all types of IO. 8. Some of the peripherals are not available in all part numbers. Please get detail peripheral configuration from datasheet.

Sheet: VFBGA184
 | 1 | 2 | 3 | 4 | 5 | 6 | 7 | 8 | 9 | 10 | 11 | 12 | 13 | 14 | 15 | 16 | 17
A | P1_8 | P1_7 |  | P1_4 |  | P0_25 |  | P0_21 |  | P0_17 |  | P0_9 |  | P0_5 |  | P0_1 | P0_0
B | P1_9 | P1_6 | P1_5 | P1_3 |  | P0_24 | P0_23 | P0_22 |  | P0_16 | P0_11 | P0_10 |  | P0_4 | P0_3 | P0_2 | P3_0
C |  |  | P1_10 | P1_2 | P1_1 | P1_0 |  | P0_20 | P0_19 | P0_18 |  | P0_8 | P0_7 | P0_6 | P3_1
D | P1_13 | P1_12 | P1_11 | P1_14 |  | VSS | P0_31 |  | VSS |  | P0_12 | VSS |  | P3_7 | P3_2 | P3_3 | P3_6
E |  |  |  | P1_15 | VSS |  | P0_30 | P0_28 |  | P0_27 | P0_14 |  | VSS | P3_8
F | P1_30 | P1_31 | RESET_B | P1_17 |  | P1_16 |  | P0_29 |  | P0_26 |  | P0_13 |  | P3_4 | P3_9 | P3_11 | P3_10
G |  | VSS |  | P1_18 | P1_19 |  | VDD |  |  |  | VDD_P3 |  | P0_15 | P3_5 |  | P3_12
H | P2_1 | P2_0 | P2_2 |  | VSS | VDD |  | VDD | VSS | VDD_P3 |  | VDD_P3 | VSS |  | P3_15 | P3_13 | P3_14
J |  |  | P2_3 | VSS |  |  |  | VSS |  | VSS |  |  |  | VSS | P3_16
K | P2_5 | P2_6 | P2_4 |  | P1_20 | VDD_LDO_CORE |  | VDD_P2 | VSS | VDD_CORE |  | P5_5 | P5_6 |  | P3_17 | P3_18 | P3_19
L |  | P2_7 |  | P1_22 | P1_21 |  | VDD_P2 |  |  |  | VDD_CORE |  | P5_7 | P5_8 |  | P3_21
M | P2_9 | P2_8 | P2_10 | P1_23 |  | P4_4 |  | P4_5 |  | P5_2 |  | P5_4 |  | P5_9 | P3_23 | P3_22 | P3_20
N |  |  |  | P2_11 | VDD_P4 |  | P4_6 | P4_14 |  | P4_18 | P5_3 |  | VSS | VDD_SYS
P | P4_0 | P4_1 | ANA_0 | VDD_P4 |  | VSS_P4 | VSS_P4 |  | VSS_P4 |  | USB1_ID | VSS |  | VSS | VDD_LDO_SYS | VSS_DCDC | DCDC_LX
R |  |  | ANA_1 | VDD_ANA | VREFH | VREFL |  | P4_16 | P4_17 | P4_19 |  | VDD_USB | USB1_DP | USB1_DM | VDD_DCDC
T | P4_2 | ANA_4 | ANA_5 | P4_7 |  | P4_12 | P4_13 | P4_15 |  | P4_20 | P4_21 | P4_22 |  | USB0_DM | USB0_DP | VSS | VDD_BAT
U | P4_3 | ANA_6 |  | ANA_7 |  | ANA_14 |  | ANA_18 |  | ANA_22 |  | P4_23 |  | USB1_VBUS |  | P5_0 | P5_1

Sheet: HDQFP172
 |  | P1_8 | P1_7 | P1_6 | P1_5 | P1_4 | VSS | VDD | P1_3 | P1_2 | P1_1 | P1_0 | P0_27 | P0_26 | P0_25 | P0_24 | P0_23 | P0_22 | P0_21 | P0_20 | P0_19 | P0_18 | P0_17 | P0_16 | P0_15 | P0_14 | P0_13 | P0_12 | VSS | VDD | P0_11 | P0_10 | P0_9 | P0_8 | P0_7 | P0_6 | P0_5 | P0_4 | P0_3 | P0_2 | P0_1 | P0_0 | VSS | VDD
 |  | 172 | 171 | 170 | 169 | 168 | 167 | 166 | 165 | 164 | 163 | 162 | 161 | 160 | 159 | 158 | 157 | 156 | 155 | 154 | 153 | 152 | 151 | 150 | 149 | 148 | 147 | 146 | 145 | 144 | 143 | 142 | 141 | 140 | 139 | 138 | 137 | 136 | 135 | 134 | 133 | 132 | 131 | 130
P1_9 | 1 |  |  |  |  |  |  |  |  |  |  |  |  |  |  |  |  |  |  |  |  |  |  |  |  |  |  |  |  |  |  |  |  |  |  |  |  |  |  |  |  |  |  |  | 129 | VDD_P3
P1_10 | 2 |  |  |  |  |  |  |  |  |  |  |  |  |  |  |  |  |  |  |  |  |  |  |  |  |  |  |  |  |  |  |  |  |  |  |  |  |  |  |  |  |  |  |  | 128 | P3_0
P1_11 | 3 |  |  |  |  |  |  |  |  |  |  |  |  |  |  |  |  |  |  |  |  |  |  |  |  |  |  |  |  |  |  |  |  |  |  |  |  |  |  |  |  |  |  |  | 127 | P3_1
P1_12 | 4 |  |  |  |  |  |  |  |  |  |  |  |  |  |  |  |  |  |  |  |  |  |  |  |  |  |  |  |  |  |  |  |  |  |  |  |  |  |  |  |  |  |  |  | 126 | P3_2
P1_13 | 5 |  |  |  |  |  |  |  |  |  |  |  |  |  |  |  |  |  |  |  |  |  |  |  |  |  |  |  |  |  |  |  |  |  |  |  |  |  |  |  |  |  |  |  | 125 | P3_3
P1_14 | 6 |  |  |  |  |  |  |  |  |  |  |  |  |  |  |  |  |  |  |  |  |  |  |  |  |  |  |  |  |  |  |  |  |  |  |  |  |  |  |  |  |  |  |  | 124 | P3_4
P1_15 | 7 |  |  |  |  |  |  |  |  |  |  |  |  |  |  |  |  |  |  |  |  |  |  |  |  |  |  |  |  |  |  |  |  |  |  |  |  |  |  |  |  |  |  |  | 123 | P3_5
P1_16 | 8 |  |  |  |  |  |  |  |  |  |  |  |  |  |  |  |  |  |  |  |  |  |  |  |  |  |  |  |  |  |  |  |  |  |  |  |  |  |  |  |  |  |  |  | 122 | VDD_P3
P1_17 | 9 |  |  |  |  |  |  |  |  |  |  |  |  |  |  |  |  |  |  |  |  |  |  |  |  |  |  |  |  |  |  |  |  |  |  |  |  |  |  |  |  |  |  |  | 121 | VSS
P1_18 | 10 |  |  |  |  |  |  |  |  |  |  |  |  |  |  |  |  |  |  |  |  |  |  |  |  |  |  |  |  |  |  |  |  |  |  |  |  |  |  |  |  |  |  |  | 120 | P3_6
P1_19 | 11 |  |  |  |  |  |  |  |  |  |  |  |  |  |  |  |  |  |  |  |  |  |  |  |  |  |  |  |  |  |  |  |  |  |  |  |  |  |  |  |  |  |  |  | 119 | P3_7
RESET_b | 12 |  |  |  |  |  |  |  |  |  |  |  |  |  |  |  |  |  |  |  |  |  |  |  |  |  |  |  |  |  |  |  |  |  |  |  |  |  |  |  |  |  |  |  | 118 | P3_8
P1_30 | 13 |  |  |  |  |  |  |  |  |  |  |  |  |  |  |  |  |  |  |  |  |  |  |  |  |  |  |  |  |  |  |  |  |  |  |  |  |  |  |  |  |  |  |  | 117 | P3_9
P1_31 | 14 |  |  |  |  |  |  |  |  |  |  |  |  |  |  |  |  |  |  |  |  |  |  |  |  |  |  |  |  |  |  |  |  |  |  |  |  |  |  |  |  |  |  |  | 116 | P3_10
VSS | 15 |  |  |  |  |  |  |  |  |  |  |  |  |  |  |  |  |  |  |  |  |  |  |  |  |  |  |  |  |  |  |  |  |  |  |  |  |  |  |  |  |  |  |  | 115 | P3_11
VDD_CORE | 16 |  |  |  |  |  |  |  |  |  |  |  |  |  |  |  |  |  |  |  |  |  |  |  |  |  |  |  |  |  |  |  |  |  |  |  |  |  |  |  |  |  |  |  | 114 | VDD_P3
VDD_LDO_CORE | 17 |  |  |  |  |  |  |  |  |  |  |  |  |  |  |  |  |  |  |  |  |  |  |  |  |  |  |  |  |  |  |  |  |  |  |  |  |  |  |  |  |  |  |  | 113 | VSS
VDD | 18 |  |  |  |  |  |  |  |  |  |  |  |  |  |  |  |  |  |  |  |  |  |  |  |  |  |  |  |  |  |  |  |  |  |  |  |  |  |  |  |  |  |  |  | 112 | P3_12
VDD_P2 | 19 |  |  |  |  |  |  |  |  |  |  |  |  |  |  |  |  |  |  |  |  |  |  |  |  |  |  |  |  |  |  |  |  |  |  |  |  |  |  |  |  |  |  |  | 111 | P3_13
P2_0 | 20 |  |  |  |  |  |  |  |  |  |  |  |  |  |  |  |  |  |  |  |  |  |  |  |  |  |  |  |  |  |  |  |  |  |  |  |  |  |  |  |  |  |  |  | 110 | P3_14
P2_1 | 21 |  |  |  |  |  |  |  |  |  |  |  |  |  |  |  |  |  |  |  |  |  |  |  |  |  |  |  |  |  |  |  |  |  |  |  |  |  |  |  |  |  |  |  | 109 | P3_15
P2_2 | 22 |  |  |  |  |  |  |  |  |  |  |  |  |  |  |  |  |  |  |  |  |  |  |  |  |  |  |  |  |  |  |  |  |  |  |  |  |  |  |  |  |  |  |  | 108 | P3_16
P2_3 | 23 |  |  |  |  |  |  |  |  |  |  |  |  |  |  |  |  |  |  |  |  |  |  |  |  |  |  |  |  |  |  |  |  |  |  |  |  |  |  |  |  |  |  |  | 107 | P3_17
P2_4 | 24 |  |  |  |  |  |  |  |  |  |  |  |  |  |  |  |  |  |  |  |  |  |  |  |  |  |  |  |  |  |  |  |  |  |  |  |  |  |  |  |  |  |  |  | 106 | VDD_P3
P2_5 | 25 |  |  |  |  |  |  |  |  |  |  |  |  |  |  |  |  |  |  |  |  |  |  |  |  |  |  |  |  |  |  |  |  |  |  |  |  |  |  |  |  |  |  |  | 105 | VDD_CORE
VSS | 26 |  |  |  |  |  |  |  |  |  |  |  |  |  |  |  |  |  |  |  |  |  |  |  |  |  |  |  |  |  |  |  |  |  |  |  |  |  |  |  |  |  |  |  | 104 | VSS
VDD_P2 | 27 |  |  |  |  |  |  |  |  |  |  |  |  |  |  |  |  |  |  |  |  |  |  |  |  |  |  |  |  |  |  |  |  |  |  |  |  |  |  |  |  |  |  |  | 103 | P3_20
P2_6 | 28 |  |  |  |  |  |  |  |  |  |  |  |  |  |  |  |  |  |  |  |  |  |  |  |  |  |  |  |  |  |  |  |  |  |  |  |  |  |  |  |  |  |  |  | 102 | P3_21
P2_7 | 29 |  |  |  |  |  |  |  |  |  |  |  |  |  |  |  |  |  |  |  |  |  |  |  |  |  |  |  |  |  |  |  |  |  |  |  |  |  |  |  |  |  |  |  | 101 | P3_22
P2_8 | 30 |  |  |  |  |  |  |  |  |  |  |  |  |  |  |  |  |  |  |  |  |  |  |  |  |  |  |  |  |  |  |  |  |  |  |  |  |  |  |  |  |  |  |  | 100 | P3_23
P2_9 | 31 |  |  |  |  |  |  |  |  |  |  |  |  |  |  |  |  |  |  |  |  |  |  |  |  |  |  |  |  |  |  |  |  |  |  |  |  |  |  |  |  |  |  |  | 99 | VDD_SYS
P2_10 | 32 |  |  |  |  |  |  |  |  |  |  |  |  |  |  |  |  |  |  |  |  |  |  |  |  |  |  |  |  |  |  |  |  |  |  |  |  |  |  |  |  |  |  |  | 98 | VDD_LDO_SYS
P2_11 | 33 |  |  |  |  |  |  |  |  |  |  |  |  |  |  |  |  |  |  |  |  |  |  |  |  |  |  |  |  |  |  |  |  |  |  |  |  |  |  |  |  |  |  |  | 97 | VDD_DCDC
VSS | 34 |  |  |  |  |  |  |  |  |  |  |  |  |  |  |  |  |  |  |  |  |  |  |  |  |  |  |  |  |  |  |  |  |  |  |  |  |  |  |  |  |  |  |  | 96 | DCDC_LX
VDD_P2 | 35 |  |  |  |  |  |  |  |  |  |  |  |  |  |  |  |  |  |  |  |  |  |  |  |  |  |  |  |  |  |  |  |  |  |  |  |  |  |  |  |  |  |  |  | 95 | DCDC_LX
VDD_P4 | 36 |  |  |  |  |  |  |  |  |  |  |  |  |  |  |  |  |  |  |  |  |  |  |  |  |  |  |  |  |  |  |  |  |  |  |  |  |  |  |  |  |  |  |  | 94 | VSS_DCDC
VSS_P4 | 37 |  |  |  |  |  |  |  |  |  |  |  |  |  |  |  |  |  |  |  |  |  |  |  |  |  |  |  |  |  |  |  |  |  |  |  |  |  |  |  |  |  |  |  | 93 | VSS_DCDC
P4_0 | 38 |  |  |  |  |  |  |  |  |  |  |  |  |  |  |  |  |  |  |  |  |  |  |  |  |  |  |  |  |  |  |  |  |  |  |  |  |  |  |  |  |  |  |  | 92 | P5_9
ANA_0 | 39 |  |  |  |  |  |  |  |  |  |  |  |  |  |  |  |  |  |  |  |  |  |  |  |  |  |  |  |  |  |  |  |  |  |  |  |  |  |  |  |  |  |  |  | 91 | P5_8
ANA_1 | 40 |  |  |  |  |  |  |  |  |  |  |  |  |  |  |  |  |  |  |  |  |  |  |  |  |  |  |  |  |  |  |  |  |  |  |  |  |  |  |  |  |  |  |  | 90 | P5_7
P4_1 | 41 |  |  |  |  |  |  |  |  |  |  |  |  |  |  |  |  |  |  |  |  |  |  |  |  |  |  |  |  |  |  |  |  |  |  |  |  |  |  |  |  |  |  |  | 89 | P5_6
P4_2 | 42 |  |  |  |  |  |  |  |  |  |  |  |  |  |  |  |  |  |  |  |  |  |  |  |  |  |  |  |  |  |  |  |  |  |  |  |  |  |  |  |  |  |  |  | 88 | P5_5
P4_3 | 43 |  |  |  |  |  |  |  |  |  |  |  |  |  |  |  |  |  |  |  |  |  |  |  |  |  |  |  |  |  |  |  |  |  |  |  |  |  |  |  |  |  |  |  | 87 | P5_4
 |  | 44 | 45 | 46 | 47 | 48 | 49 | 50 | 51 | 52 | 53 | 54 | 55 | 56 | 57 | 58 | 59 | 60 | 61 | 62 | 63 | 64 | 65 | 66 | 67 | 68 | 69 | 70 | 71 | 72 | 73 | 74 | 75 | 76 | 77 | 78 | 79 | 80 | 81 | 82 | 83 | 84 | 85 | 86
 |  | P4_4 | ANA_4 | ANA_5 | P4_5 | ANA_6 | P4_6 | P4_7 | ANA_7 | VDD_ANA | VREFH | VREFL | VSS_P4 | VDD_P4 | P4_12 | P4_13 | ANA_14 | P4_14 | P4_15 | P4_16 | P4_17 | ANA_18 | P4_18 | P4_19 | P4_20 | P4_21 | ANA_22 | P4_22 | P4_23 | VSS_P4 | VDD_P4 | USB1_DP | USB1_DM | USB1_VBUS | VSS_USB | VDD_USB | USB0_DM | USB0_DP | VSS | VDD_BAT | P5_0 | P5_1 | P5_2 | P5_3

Sheet: HLQFP100
N54/N53/N52/N24 |  |  | P1_7 | P1_6 | P1_5 | P1_4 | VDD | P1_3 | P1_2 | P1_1 | P1_0 | P0_23 | P0_22 | P0_21 | P0_20 | P0_19 | P0_18 | P0_17 | P0_16 | VDD | P0_6 | P0_5 | P0_4 | P0_3 | P0_2 | P0_1 | P0_0 |  |  | N52x/N53x/N54X
 | N94 |  | P1_7 | P1_6 | P1_5 | P1_4 | VDD | P1_3 | P1_2 | P1_1 | P1_0 | P0_23 | P0_22 | P0_21 | P0_20 | P0_19 | P0_18 | P0_17 | P0_16 | VDD | P0_6 | P0_5 | P0_4 | P0_3 | P0_2 | P0_1 | P0_0 |  | N94X
 |  |  | 100 | 99 | 98 | 97 | 96 | 95 | 94 | 93 | 92 | 91 | 90 | 89 | 88 | 87 | 86 | 85 | 84 | 83 | 82 | 81 | 80 | 79 | 78 | 77 | 76
P1_8 | P1_8 | 1 |  |  |  |  |  |  |  |  |  |  |  |  |  |  |  |  |  |  |  |  |  |  |  |  |  | 75 | P3_0 | P3_0
P1_9 | P1_9 | 2 |  |  |  |  |  |  |  |  |  |  |  |  |  |  |  |  |  |  |  |  |  |  |  |  |  | 74 | P3_1 | P3_1
P1_10 | P1_10 | 3 |  |  |  |  |  |  |  |  |  |  |  |  |  |  |  |  |  |  |  |  |  |  |  |  |  | 73 | VDD_P3 | VDD_P3
P1_11 | P1_11 | 4 |  |  |  |  |  |  |  |  |  |  |  |  |  |  |  |  |  |  |  |  |  |  |  |  |  | 72 | P3_6 | P3_6
P1_12 | P1_12 | 5 |  |  |  |  |  |  |  |  |  |  |  |  |  |  |  |  |  |  |  |  |  |  |  |  |  | 71 | P3_7 | P3_7
P1_13 | P1_13 | 6 |  |  |  |  |  |  |  |  |  |  |  |  |  |  |  |  |  |  |  |  |  |  |  |  |  | 70 | P3_8 | P3_8
P1_14 | P1_14 | 7 |  |  |  |  |  |  |  |  |  |  |  |  |  |  |  |  |  |  |  |  |  |  |  |  |  | 69 | P3_9 | P3_9
P1_15 | P1_15 | 8 |  |  |  |  |  |  |  |  |  |  |  |  |  |  |  |  |  |  |  |  |  |  |  |  |  | 68 | P3_10 | P3_10
RESET_b | RESET_b | 9 |  |  |  |  |  |  |  |  |  |  |  |  |  |  |  |  |  |  |  |  |  |  |  |  |  | 67 | P3_11 | P3_11
P1_30 | P1_30 | 10 |  |  |  |  |  |  |  |  |  |  |  |  |  |  |  |  |  |  |  |  |  |  |  |  |  | 66 | VDD_P3 | VDD_P3
P1_31 | P1_31 | 11 |  |  |  |  |  |  |  |  |  |  |  |  |  |  |  |  |  |  |  |  |  |  |  |  |  | 65 | P3_12 | P3_12
VDD_CORE | VDD_CORE | 12 |  |  |  |  |  |  |  |  |  |  |  |  |  |  |  |  |  |  |  |  |  |  |  |  |  | 64 | P3_13 | P3_13
VDD | VDD | 13 |  |  |  |  |  |  |  |  |  |  |  |  |  |  |  |  |  |  |  |  |  |  |  |  |  | 63 | P3_14 | P3_14
P2_0 | P2_0 | 14 |  |  |  |  |  |  |  |  |  |  |  |  |  |  |  |  |  |  |  |  |  |  |  |  |  | 62 | P3_15 | P3_15
P2_1 | P2_1 | 15 |  |  |  |  |  |  |  |  |  |  |  |  |  |  |  |  |  |  |  |  |  |  |  |  |  | 61 | P3_16 | P3_16
P2_2 | P2_2 | 16 |  |  |  |  |  |  |  |  |  |  |  |  |  |  |  |  |  |  |  |  |  |  |  |  |  | 60 | P3_17 | P3_17
P2_3 | P2_3 | 17 |  |  |  |  |  |  |  |  |  |  |  |  |  |  |  |  |  |  |  |  |  |  |  |  |  | 59 | VDD_P3 | VDD_P3
P2_4 | P2_4 | 18 |  |  |  |  |  |  |  |  |  |  |  |  |  |  |  |  |  |  |  |  |  |  |  |  |  | 58 | VDD_CORE | VDD_CORE
P2_5 | P2_5 | 19 |  |  |  |  |  |  |  |  |  |  |  |  |  |  |  |  |  |  |  |  |  |  |  |  |  | 57 | P3_20 | P3_20
P2_6 | P2_6 | 20 |  |  |  |  |  |  |  |  |  |  |  |  |  |  |  |  |  |  |  |  |  |  |  |  |  | 56 | P3_21 | P3_21
P2_7 | P2_7 | 21 |  |  |  |  |  |  |  |  |  |  |  |  |  |  |  |  |  |  |  |  |  |  |  |  |  | 55 | VDD_SYS | VDD_SYS
P4_0/ANA_0 | P4_0/ANA_0 | 22 |  |  |  |  |  |  |  |  |  |  |  |  |  |  |  |  |  |  |  |  |  |  |  |  |  | 54 | VDD_DCDC | VDD_DCDC
P4_1/ANA_1 | P4_1/ANA_1 | 23 |  |  |  |  |  |  |  |  |  |  |  |  |  |  |  |  |  |  |  |  |  |  |  |  |  | 53 | DCDC_LX | DCDC_LX
P4_2 | P4_2 | 24 |  |  |  |  |  |  |  |  |  |  |  |  |  |  |  |  |  |  |  |  |  |  |  |  |  | 52 | VSS_DCDC | VSS_DCDC
P4_3 | P4_3 | 25 |  |  |  |  |  |  |  |  |  |  |  |  |  |  |  |  |  |  |  |  |  |  |  |  |  | 51 | P5_3 | P5_3
 |  |  | 26 | 27 | 28 | 29 | 30 | 31 | 32 | 33 | 34 | 35 | 36 | 37 | 38 | 39 | 40 | 41 | 42 | 43 | 44 | 45 | 46 | 47 | 48 | 49 | 50
 | N94 |  | P4_4/ANA_4 | P4_5/ANA_5 | P4_6/ANA_6 | P4_7/ANA_7 | VDD_ANA | VREFH | VREFL | VSS_P4 | VDD_P4 | P4_12 | P4_13/ANA_14 | P4_15 | P4_16 | P4_17/ANA_18 | P4_19 | P4_20 | P4_21/ANA_22 | P4_23 | VDD_USB | USB0_DM | USB0_DP | VDD_BAT | P5_0 | P5_1 | P5_2 |  | N94X
N54/N53/N52/N24 |  |  | P4_4/ANA_4 | P4_5/ANA_5 | P4_6/ANA_6 | P4_7/ANA_7 | VDD_ANA | VREFH | VREFL | VSS_P4 | VDD_P4 | P4_12 | P4_13/ANA_14 | P4_15 | P4_16 | P4_17/ANA_18 | USB1_DP | USB1_DM | USB1_VBUS | VSS_USB | VDD_USB | USB0_DM | USB0_DP | VDD_BAT | P5_0 | P5_1 | P5_2 |  |  | N52x/N53x/N54X
