jonasblixt/poetato/doc/mech/poetato-outline.dxf

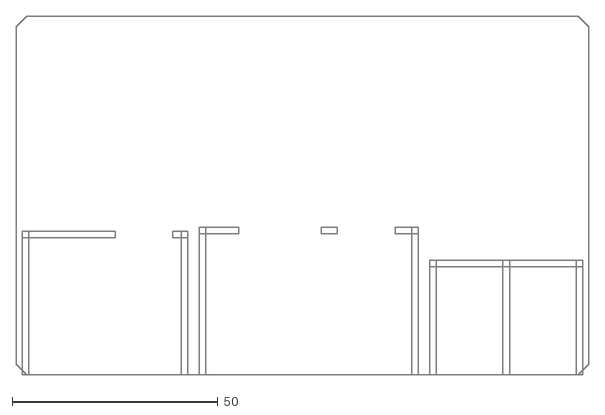
[picture p1: CAD file, 2026-10-07]
doc/mech/poetato-outline.dxf
139.0 x 87.0
