jonasblixt/poetato/hw/poetato/poetato.step

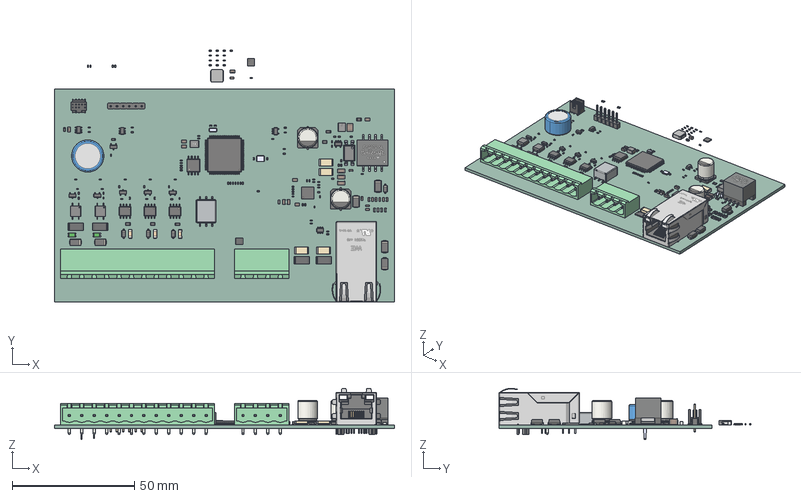
[picture p2: CAD file, 2026-10-07]
hw/poetato/poetato.step
139.0 x 102.9 x 21.0 mm
CP_Elec_8x10 x 2
R_0402_1005Metric x 55
D_SOD-123 x 4
C_0402_1005Metric x 34
IHLP2020BZ
Body001 (Mirror #1) x 4
XY-plane x 24
X-axis x 24
R_0805_2012Metric x 6
R_2512_6332Metric x 4
SOT-23 x 6
C_0603_1608Metric x 11
SOT-23-5 x 2
C_Murata_GA3_5.7x2.8 x 4
C_0805_2012Metric x 9
D_SMA x 6
R_MiniMELF_MMA-0204 x 3
LED_0402_1005Metric x 9
NX3225SA-12.000M-STD-CRS-2
L_0603_1608Metric x 5
PinHeader_1x06_P254mm_Vertical
SOIC-8_3.9x4.9mm_P1.27mm x 3
SOIC-8_5.3x5.3mm_P1.27mm
R_0603_1608Metric x 2
SOT-23-6 x 3
T_Wurth_WE-RJ45LAN_7499511440
C_1206_3216Metric x 3
NX3215SA-32.768K-STD-MUA-8
UQFN-20-1EP_3x3mm_Pitch0.4mm
MSTBA_01x04_G_5_08mm
MSTBA_01x12_G_5_08mm
User Library-IHLP1212 x 2
R_1210_3225Metric
T_Wurth_WE-PPTI-1308
KW-5R5C104_224_334-R
LQFP-100_14x14mm_P0.5mm
FA2672-AL
VO618A-3X017T
C_1210_3225Metric
FTSH-105-01-L-DV-007-K-TR_body
FTSH-105-01-L-DV-007-K-TR_pins1
FTSH-105-01-L-DV-007-K-TR_pins2
QFN_32_1EP_5x5mm_P05mm_EP33x33mm
poetato_PCB
