jonasblixt/poetato/hw/poetato/poetato.kicad_pcb

## KiCad design hw/poetato/poetato.kicad_pcb (2026-10-17)

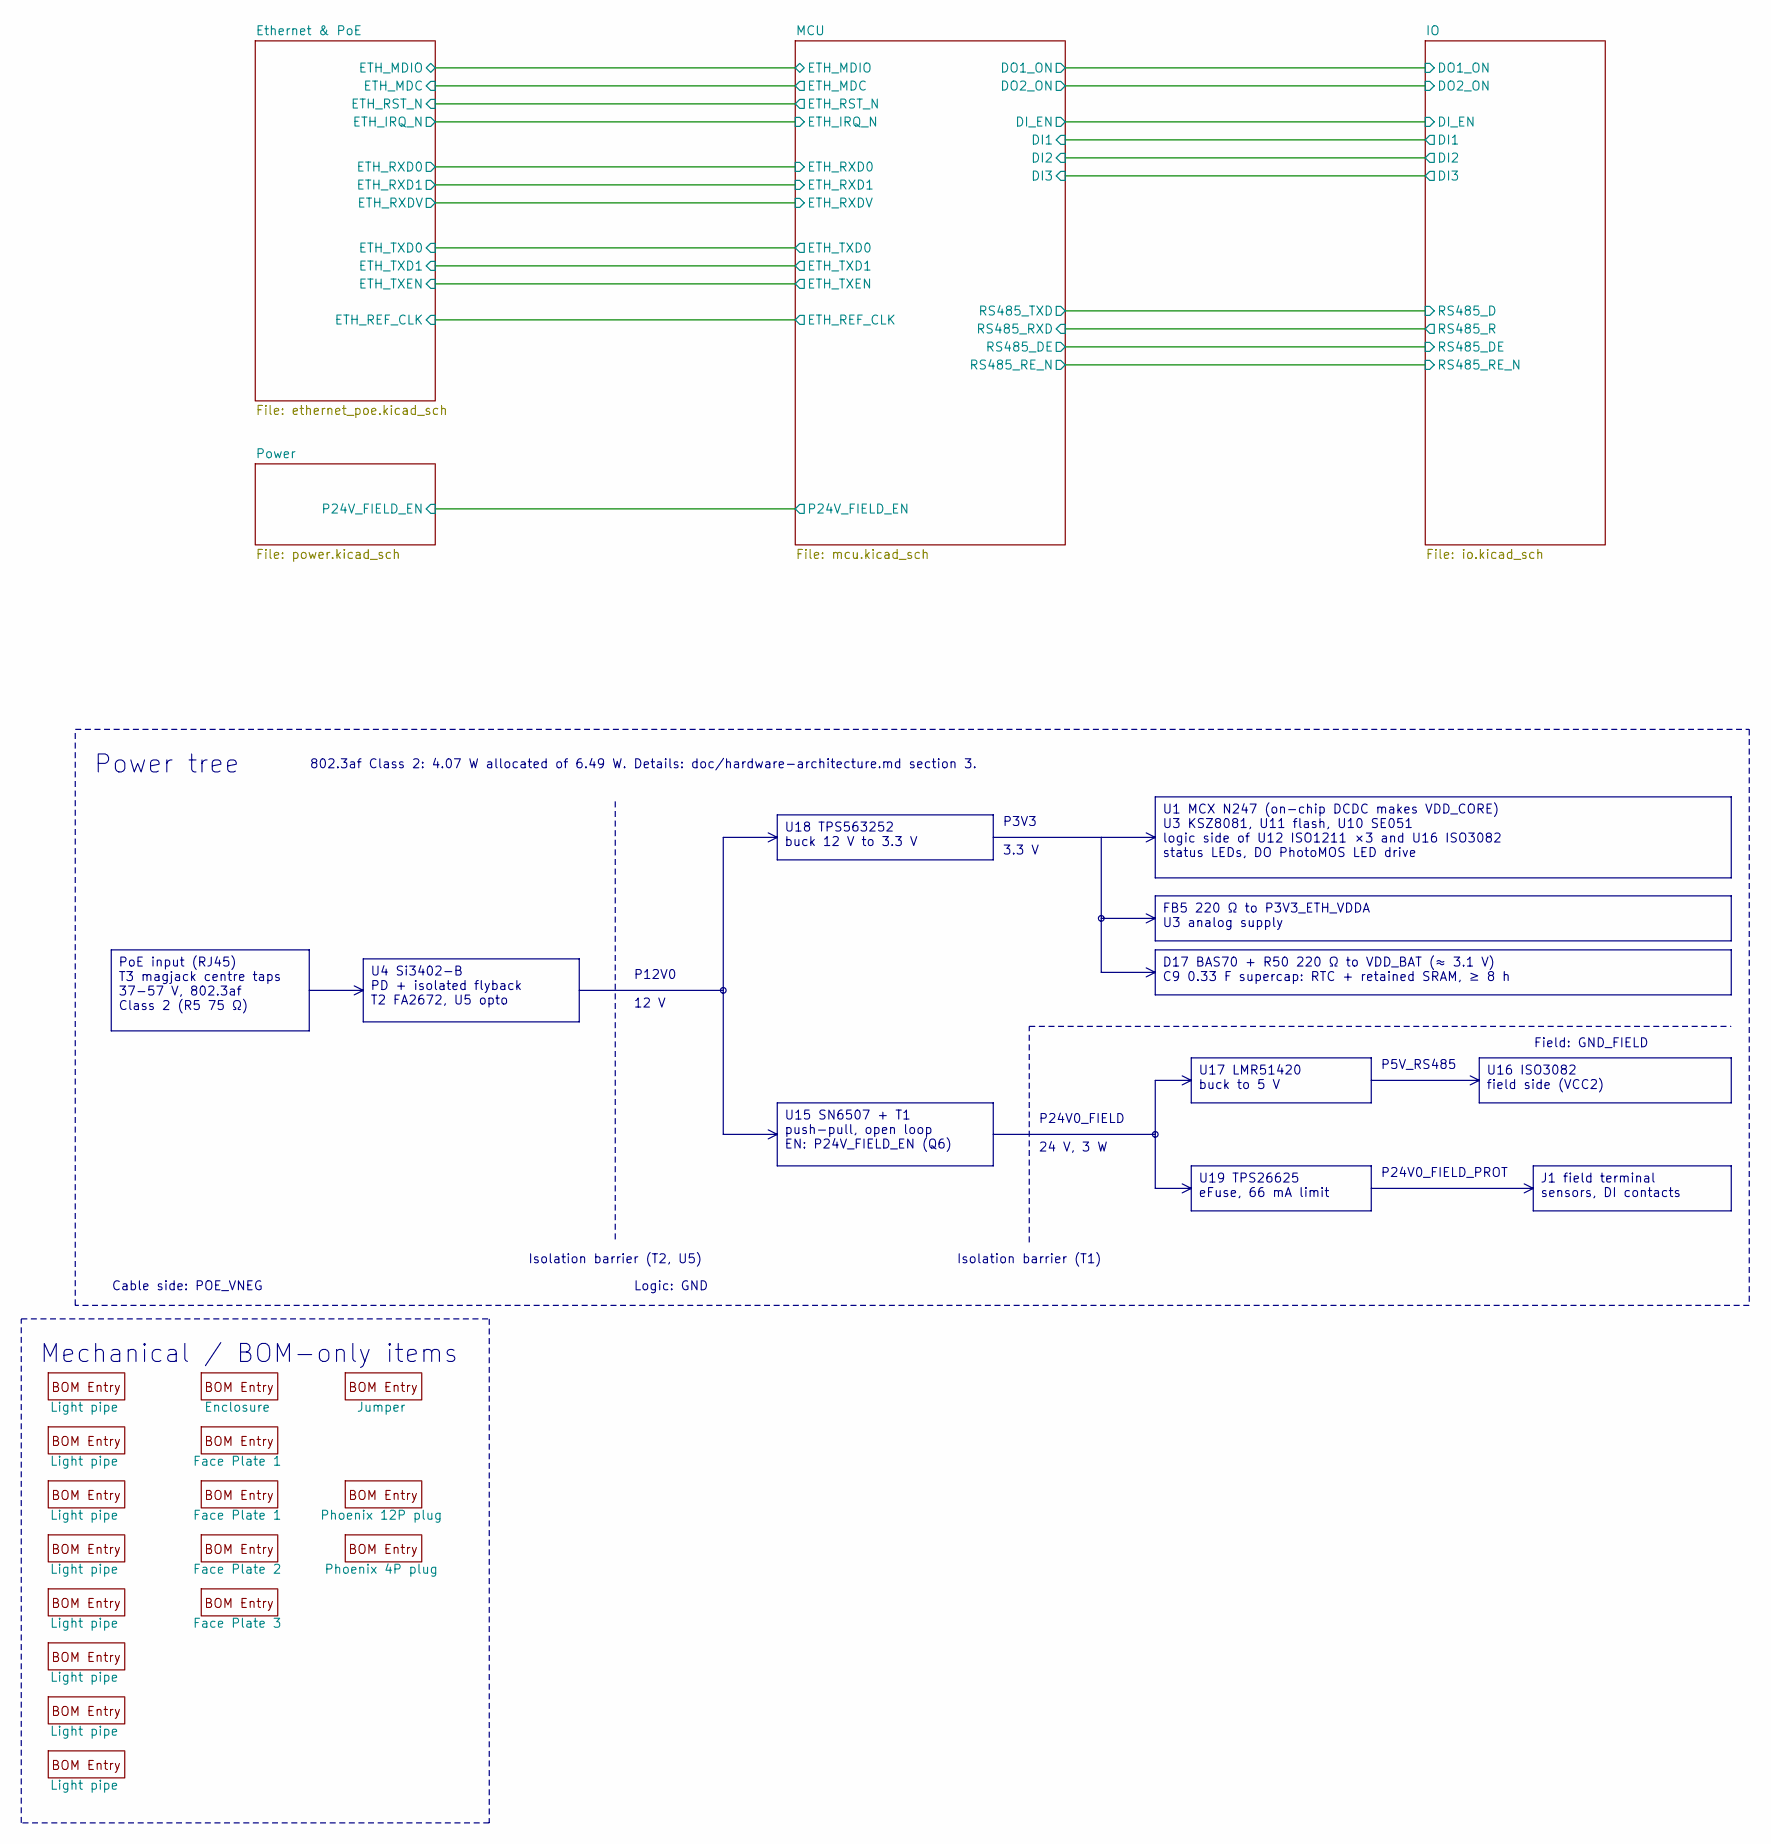
[picture p3: schematic poetato.kicad_sch, PoEtato - Top level]

Parts:
M1, M2, M3, M4, M5, M6, M7, M8: Light pipe; Part Number PLP2-750
M9: Enclosure; Part Number 35.0807000.BL
M10: Jumper; Part Number 60900213421
M11, M12: Face Plate 1; Part Number P05040206T.BL
M13: Face Plate 2; Part Number P05040201T.BL
M14: Face Plate 3; Part Number P05040254T.BL
M15: Phoenix 12P plug; Part Number 1757116
M16: Phoenix 4P plug; Part Number 1757035

Notes on the sheet:
P12V0
802.3af Class 2: 4.07 W allocated of 6.49 W. Details: doc/hardware-architecture.md section 3.
P5V_RS485
Power tree
P3V3
P24V0_FIELD_PROT
Field: GND_FIELD
Mechanical / BOM-only items
Logic: GND
Isolation barrier (T1)
Isolation barrier (T2, U5)
24 V, 3 W
Cable side: POE_VNEG
12 V
P24V0_FIELD
3.3 V
U18 TPS563252 buck 12 V to 3.3 V
U15 SN6507 + T1 push-pull, open loop EN: P24V_FIELD_EN (Q6)
U16 ISO3082 field side (VCC2)
PoE input (RJ45) T3 magjack centre taps 37-57 V, 802.3af Class 2 (R5 75 Ω)
FB5 220 Ω to P3V3_ETH_VDDA U3 analog supply
U19 TPS26625 eFuse, 66 mA limit
D17 BAS70 + R50 220 Ω to VDD_BAT (≈ 3.1 V) C9 0.33 F supercap: RTC + retained SRAM, ≥ 8 h
U1 MCX N247 (on-chip DCDC makes VDD_CORE) U3 KSZ8081, U11 flash, U10 SE051 logic side of U12 ISO1211 ×3 and U16 ISO3082 status LEDs, DO PhotoMOS LED drive
U4 Si3402-B PD + isolated flyback T2 FA2672, U5 opto
J1 field terminal sensors, DI contacts
U17 LMR51420 buck to 5 V

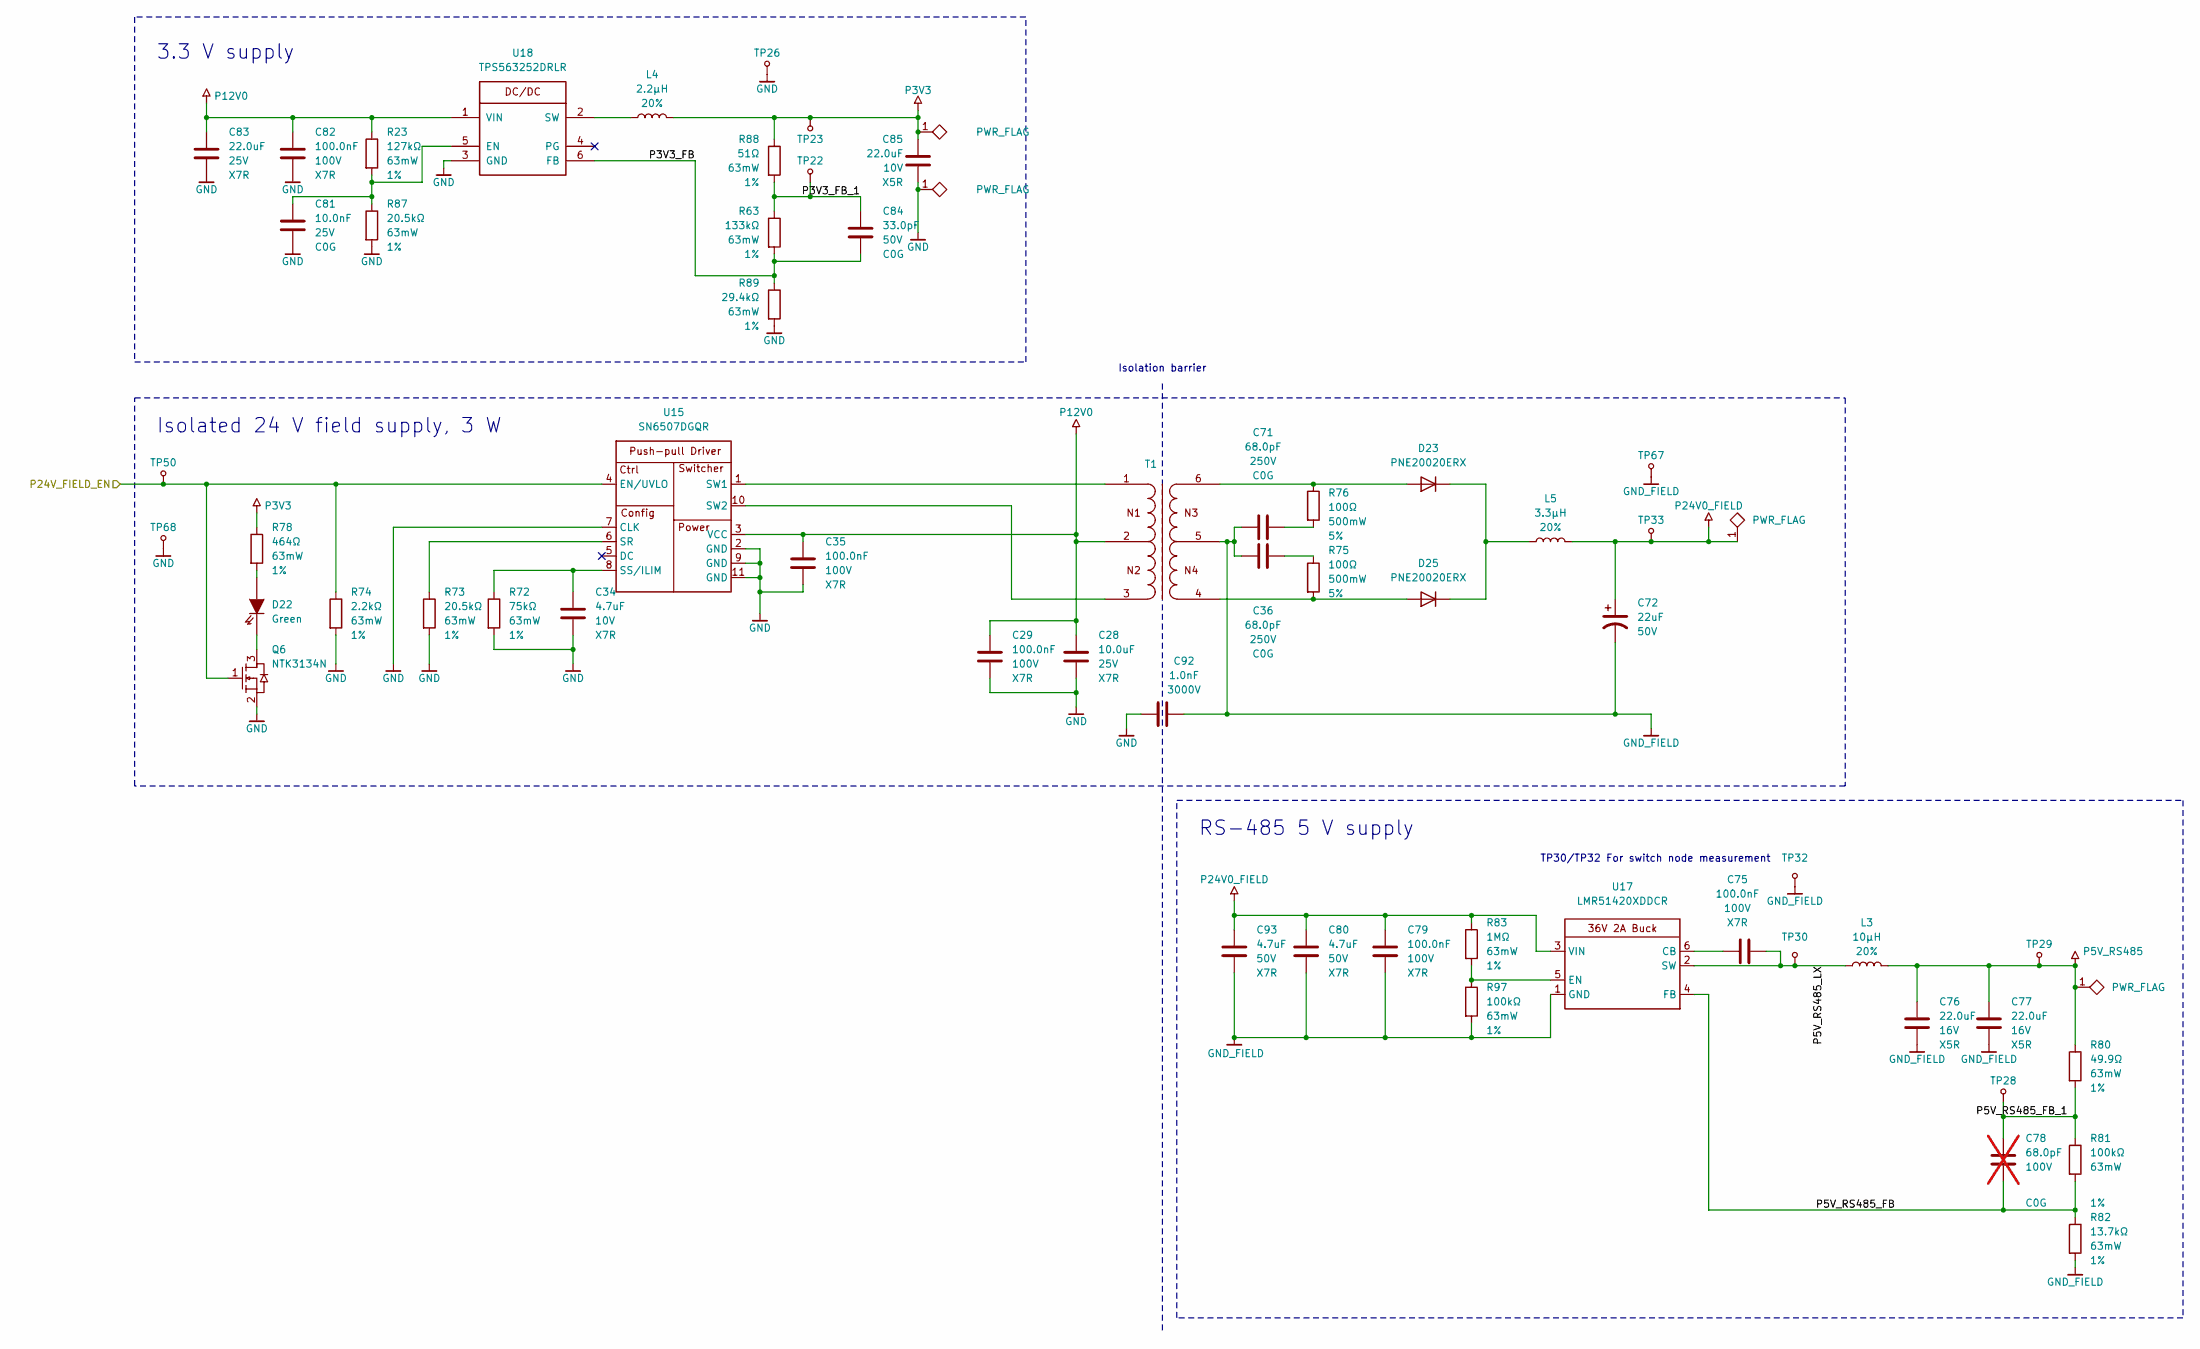
[picture p4: schematic power.kicad_sch, PoEtato - DC/DC converters]

Parts:
C28: 10.0uF; C_0805_2012Metric; Voltage 25V; Part Number GRM21BZ71E106KE15
C29, C35, C75, C79, C82: 100.0nF; C_0603_1608Metric; Voltage 100V; Part Number GRM188R72A104KA35
C34: 4.7uF; C_0603_1608Metric; Voltage 10V; Part Number GRM188Z71A475KE15
C36, C71: 68.0pF; C_0603_1608Metric; Voltage 250V; Part Number GQM1875C2E680JB12
C72: 22uF; CP_Elec_5x5.8; Voltage 50V; Part Number EMZR500ARA220ME61G
C76, C77: 22.0uF; C_0805_2012Metric; Voltage 16V; Part Number GRM21BR61C226ME44
C78: 68.0pF; C_0402_1005Metric; Voltage 100V; Part Number GRM1555C2A680JA01; not fitted
C80, C93: 4.7uF; C_1206_3216Metric; Voltage 50V; Part Number GRM31CR71H475KA12
C81: 10.0nF; C_0402_1005Metric; Voltage 25V; Part Number GRM1555C1E103JE01
C83: 22.0uF; C_1210_3225Metric; Voltage 25V; Part Number GRM32ER71E226KE15
C84: 33.0pF; C_0402_1005Metric; Voltage 50V; Part Number GRM1555C1H330GA01
C85: 22.0uF; C_0603_1608Metric; Voltage 10V; Part Number GRM188R61A226ME15
C92: 1.0nF; C_1808_4520Metric; Voltage 3000V; Part Number C1808C102KHRACTU
D22: LED0402_150040VS73240; LED_0402_1005Metric; Part Number 150040VS73240
D23, D25: PNE20020ERX; Nexperia_CFP3_SOD-123W; Part Number PNE20020ERX
L3: 10µH; IHLP2020CZ; Tolerance 20%; Part Number IHLP2020CZER100M01
L4: 2.2µH; IHLP1212BZ; Tolerance 20%; Part Number IHLP1212BZEZ2R2M1Z
L5: 3.3µH; IHLP1212BZ; Tolerance 20%; Part Number IHLP1212BZEZ3R3M1Z
Q6: NTK3134N; SOT-723; Part Number NTK3134NT1G
R23: 127kΩ; R_0402_1005Metric; Tolerance 1%; Part Number CRCW0402127KFKED
R63: 133kΩ; R_0402_1005Metric; Tolerance 1%; Part Number CRCW0402133KFKED
R72: 75kΩ; R_0402_1005Metric; Tolerance 1%; Part Number CRCW040275K0FKED
R73, R87: 20.5kΩ; R_0402_1005Metric; Tolerance 1%; Part Number CRCW040220K5FKED
R74: 2.2kΩ; R_0402_1005Metric; Tolerance 1%; Part Number CRCW04022K20FKED
R75, R76: 100Ω; R_1210_3225Metric; Tolerance 5%; Part Number ERJT14J101U
R78: 464Ω; R_0402_1005Metric; Tolerance 1%; Part Number CRCW0402464RFKED
R80: 49.9Ω; R_0402_1005Metric; Tolerance 1%; Part Number CRCW040249R9FKED
R81, R97: 100kΩ; R_0402_1005Metric; Tolerance 1%; Part Number CRCW0402100KFKED
R82: 13.7kΩ; R_0402_1005Metric; Tolerance 1%; Part Number CRCW040213K7FKED
R83: 1MΩ; R_0402_1005Metric; Tolerance 1%; Part Number CRCW04021M00FKED
R88: 51Ω; R_0402_1005Metric; Tolerance 1%; Part Number CRCW040251R0FKED
R89: 29.4kΩ; R_0402_1005Metric; Tolerance 1%; Part Number CRCW040229K4FKED
T1: 1308_750319693; T_Wurth_WE-PPTI-1308; Part Number 750319693
TP22, TP23, TP26, TP28, TP29, TP30, TP32, TP33, TP50, TP67, TP68: TP; TestPoint_Pad_D1.0mm
U15: SN6507DGQR; HVSSOP-10-1EP_3x3mm_P0.5mm_EP1.83x1.89mm; Part Number SN6507DGQR
U17: LMR51420XDDCR; TSOT-23-6; Part Number LMR51420XDDCR
U18: TPS563252DRLR; SOT-563; Part Number TPS563252DRLR

Connections:
/MCU/P24V_FIELD_EN: Q6.1, R74.1, TP50.1, U15.4 (EN/UVLO); also elsewhere on the board
/Power/P3V3_FB: C84.2, R63.2, R89.1, U18.6 (FB)
/Power/P3V3_FB_1: C84.1, R63.1, R88.2, TP22.1
/Power/P5V_RS485_FB: C78.2, R81.2, R82.1, U17.4 (FB)
/Power/P5V_RS485_FB_1: C78.1, R80.2, R81.1, TP28.1
/Power/P5V_RS485_LX: C75.1, L3.2, TP30.1, U17.2 (SW)
GND: C28.2, C29.2, C34.2, C35.2, C81.2, C82.2, C83.2, C85.2, C92.1, Q6.2, R72.2, R73.2, R74.2, R87.2, R89.2, TP26.1, TP68.1, U15.2 (GND), U15.7 (CLK), U15.9 (GND), U15.11 (GND), U18.3 (GND); also elsewhere on the board
GND_FIELD: C36.1, C71.1, C72.2, C76.2, C77.2, C79.1, C80.2, C92.2, C93.2, R82.2, R97.2, T1.5, TP32.1, TP67.1, U17.1 (GND); also elsewhere on the board
unnamed: C36.2, R75.1
unnamed: C71.2, R76.2
unnamed: D22.1, Q6.3
unnamed: D22.2, R78.2
unnamed: D23.2 (A), R76.1, T1.6
unnamed: D23.1 (K), D25.1 (K), L5.1
unnamed: D25.2 (A), R75.2, T1.4
unnamed: R73.1, U15.6 (SR)
unnamed: C34.1, R72.1, U15.8 (SS/ILIM)
unnamed: T1.1, U15.1 (SW1)
unnamed: T1.3, U15.10 (SW2)
unnamed: C75.2, U17.6 (CB)
unnamed: R83.2, R97.1, U17.5 (EN)
unnamed: C81.1, R23.2, R87.1, U18.5 (EN)
unnamed: L4.2, U18.2 (SW)
P3V3: C85.1, L4.1, R78.1, R88.1, TP23.1; also elsewhere on the board
P5V_RS485: C76.1, C77.1, L3.1, R80.1, TP29.1; also elsewhere on the board
P12V0: C28.1, C29.1, C35.1, C82.1, C83.1, R23.1, T1.2, U15.3 (VCC), U18.1 (VIN); also elsewhere on the board
P24V0_FIELD: C72.1, C79.2, C80.1, C93.1, L5.2, R83.1, TP33.1, U17.3 (VIN); also elsewhere on the board

Notes on the sheet:
3.3 V supply
RS-485 5 V supply
TP30/TP32 For switch node measurement
Isolated 24 V field supply, 3 W
Isolation barrier

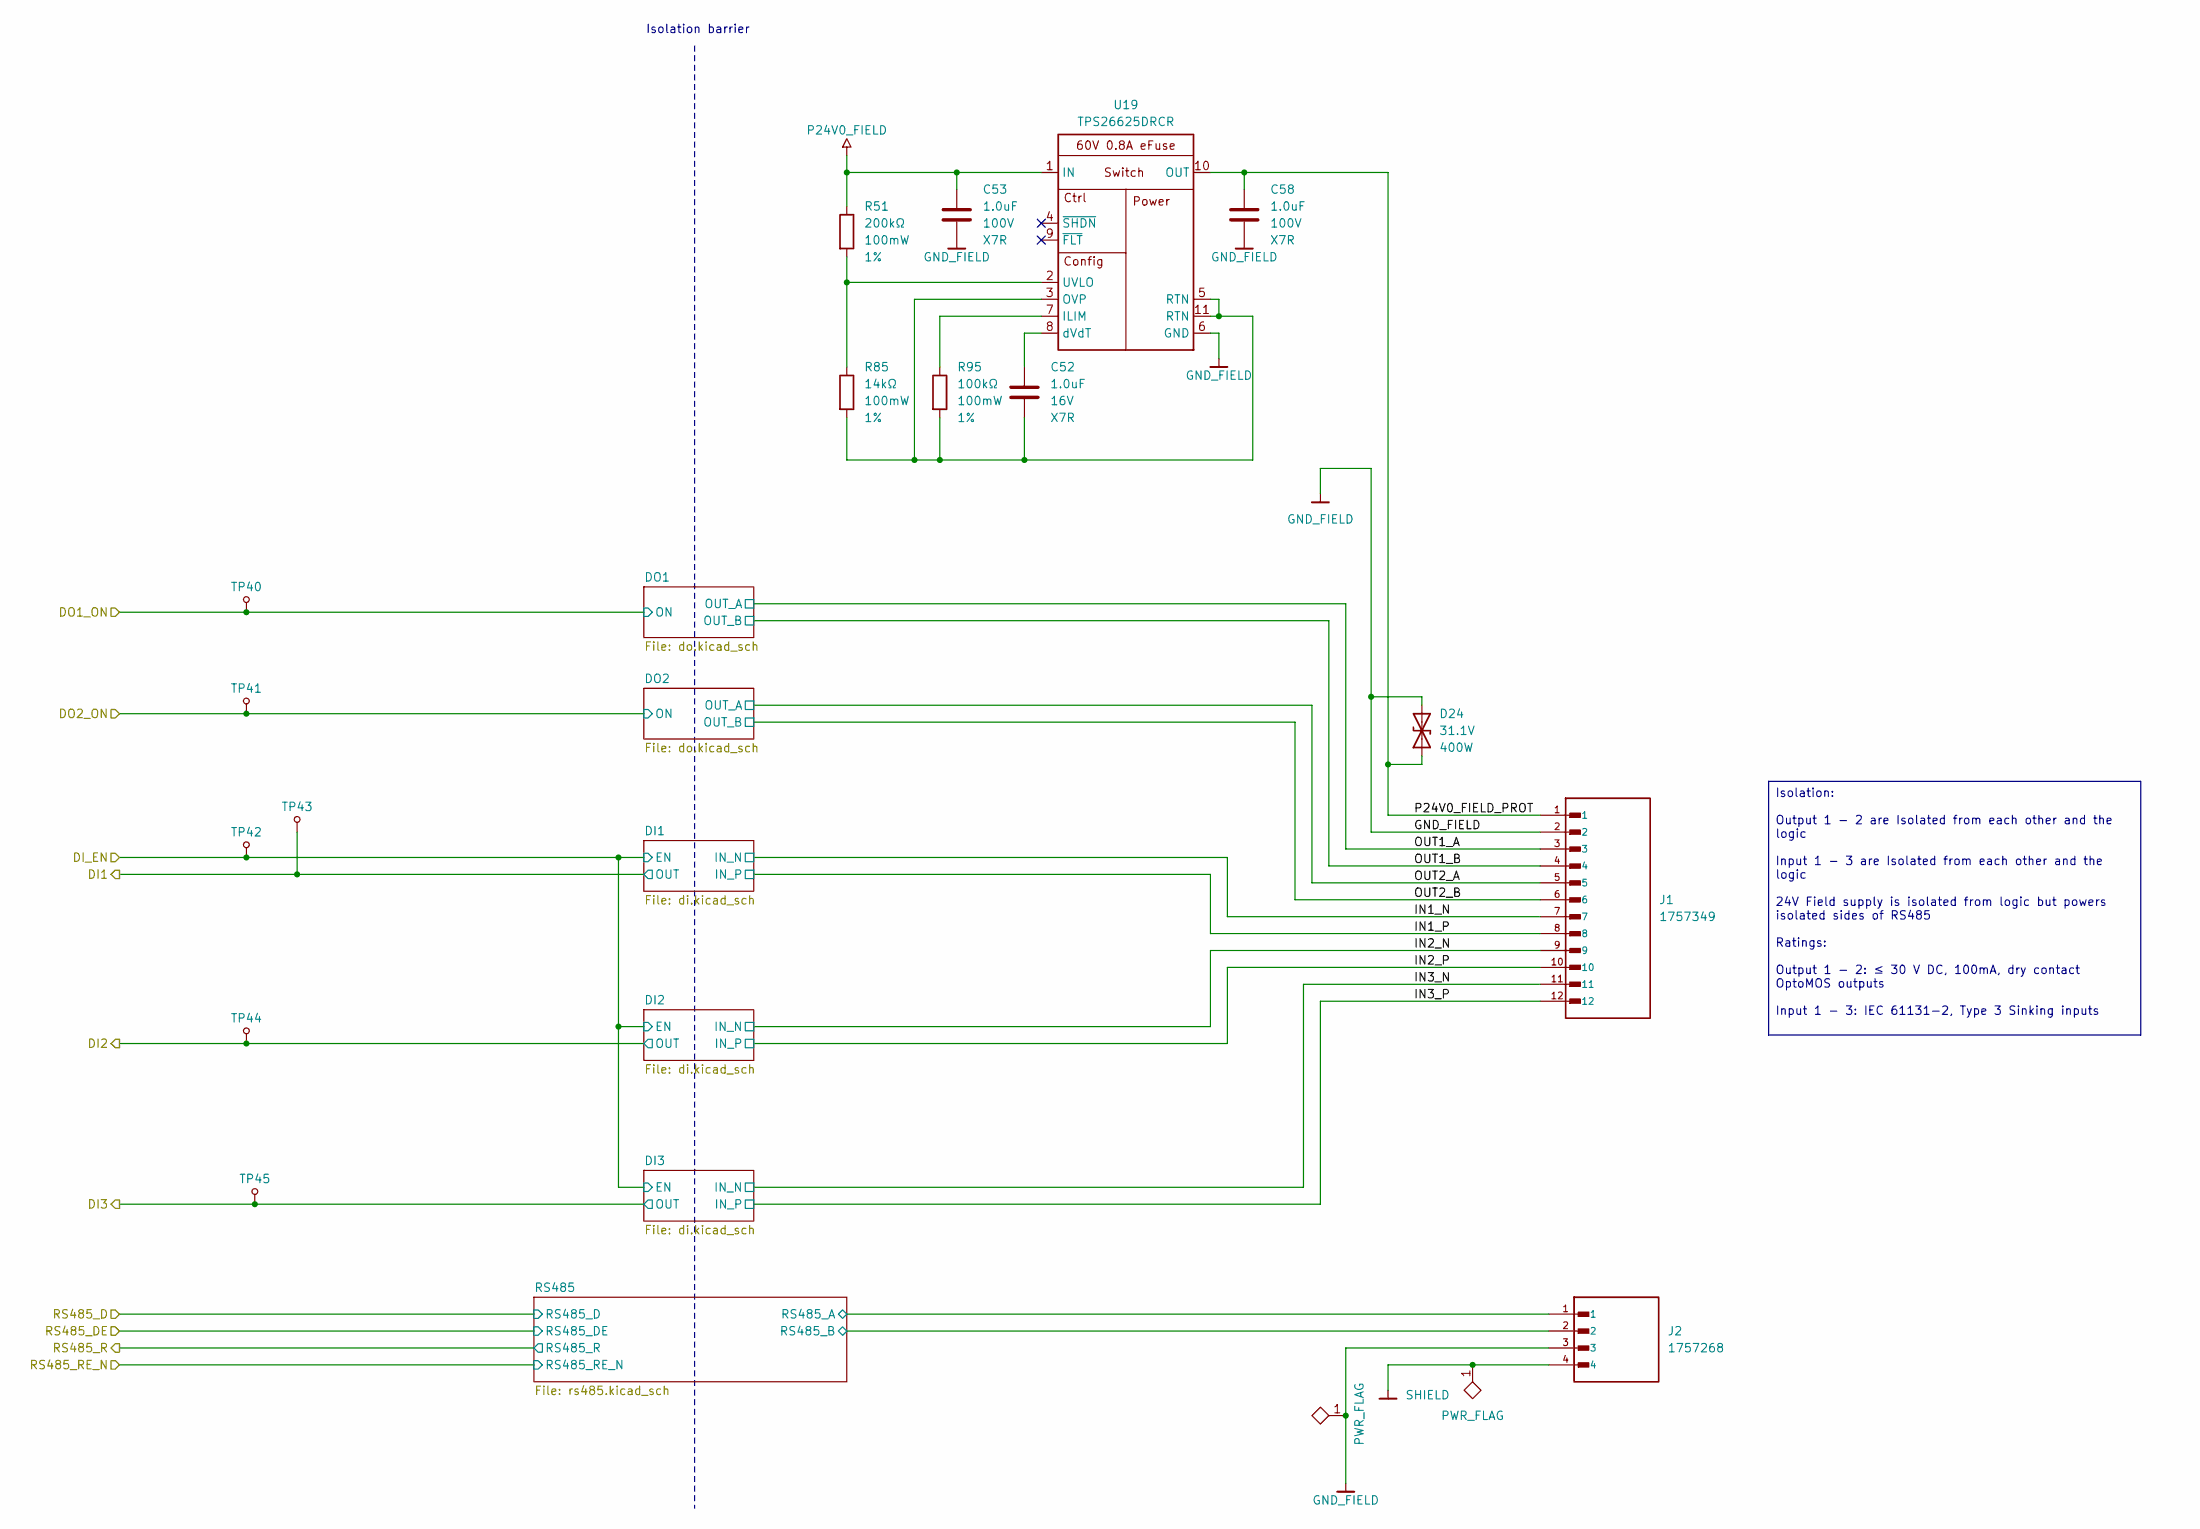
[picture p5: schematic io.kicad_sch, PoEtato - Field I/O]

Parts:
C52: 1.0uF; C_0805_2012Metric; Voltage 16V; Part Number GRM21BR71C105KA01
C53, C58: 1.0uF; C_1206_3216Metric; Voltage 100V; Part Number GRM31CR72A105KA01
D24: 31.1V; D_SMA; Breakdown Voltage 31.1V; Standoff Voltage 28V; Part Number SMAJ28CA
J1: 1757349; PhoenixContact_MSTBA_2,5_12-G-5,08_1x12_P5.08mm_Horizontal; Part Number 1757349
J2: 1757268; PhoenixContact_MSTBA_2,5_4-G-5,08_1x04_P5.08mm_Horizontal; Part Number 1757268
R51: 200kΩ; R_0603_1608Metric; Tolerance 1%; Part Number CRCW0603200KFKEA
R85: 14kΩ; R_0603_1608Metric; Tolerance 1%; Part Number CRCW060314K0FKEA
R95: 100kΩ; R_0603_1608Metric; Tolerance 1%; Part Number CRCW0603100KFKEA
TP40, TP41, TP42, TP43, TP44, TP45: TP; TestPoint_Pad_D1.0mm
U19: TPS26625DRCR; VSON-10-1EP_3x3mm_P0.5mm_EP1.65x2.4mm; Part Number TPS26625DRCR

Connections:
/IO/DI1: TP43.1; also elsewhere on the board
/IO/DI2: TP44.1; also elsewhere on the board
/IO/DI3: TP45.1; also elsewhere on the board
/IO/DI_EN: TP42.1; also elsewhere on the board
/IO/IN1_N: J1.7; also elsewhere on the board
/IO/IN1_P: J1.8; also elsewhere on the board
/IO/IN2_N: J1.9; also elsewhere on the board
/IO/IN2_P: J1.10; also elsewhere on the board
/IO/IN3_N: J1.11; also elsewhere on the board
/IO/IN3_P: J1.12; also elsewhere on the board
/IO/OUT1_A: J1.3; also elsewhere on the board
/IO/OUT1_B: J1.4; also elsewhere on the board
/IO/OUT2_A: J1.5; also elsewhere on the board
/IO/OUT2_B: J1.6; also elsewhere on the board
/IO/P24V0_FIELD_PROT: C58.1, D24.1 (A1), J1.1, U19.10 (OUT)
/IO/RS485/RS485_A: J2.1; also elsewhere on the board
/IO/RS485/RS485_B: J2.2; also elsewhere on the board
/MCU/DO1_ON: TP40.1; also elsewhere on the board
/MCU/DO2_ON: TP41.1; also elsewhere on the board
GND_FIELD: C53.2, C58.2, D24.2 (A2), J1.2, J2.3, U19.6 (GND); also elsewhere on the board
unnamed: R95.1, U19.7 (ILIM)
unnamed: C52.2, R85.2, R95.2, U19.3 (OVP), U19.5 (RTN), U19.11 (RTN)
unnamed: R51.2, R85.1, U19.2 (UVLO)
unnamed: C52.1, U19.8 (dVdT)
P24V0_FIELD: C53.1, R51.1, U19.1 (IN); also elsewhere on the board
SHIELD: J2.4; also elsewhere on the board

Notes on the sheet:
Isolation barrier
Isolation: Output 1 - 2 are Isolated from each other and the logic Input 1 - 3 are Isolated from each other and the logic 24V Field supply is isolated from logic but powers isolated sides of RS485 Ratings: Output 1 - 2: ≤ 30 V DC, 100mA, dry contact OptoMOS outputs Input 1 - 3: IEC 61131-2, Type 3 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

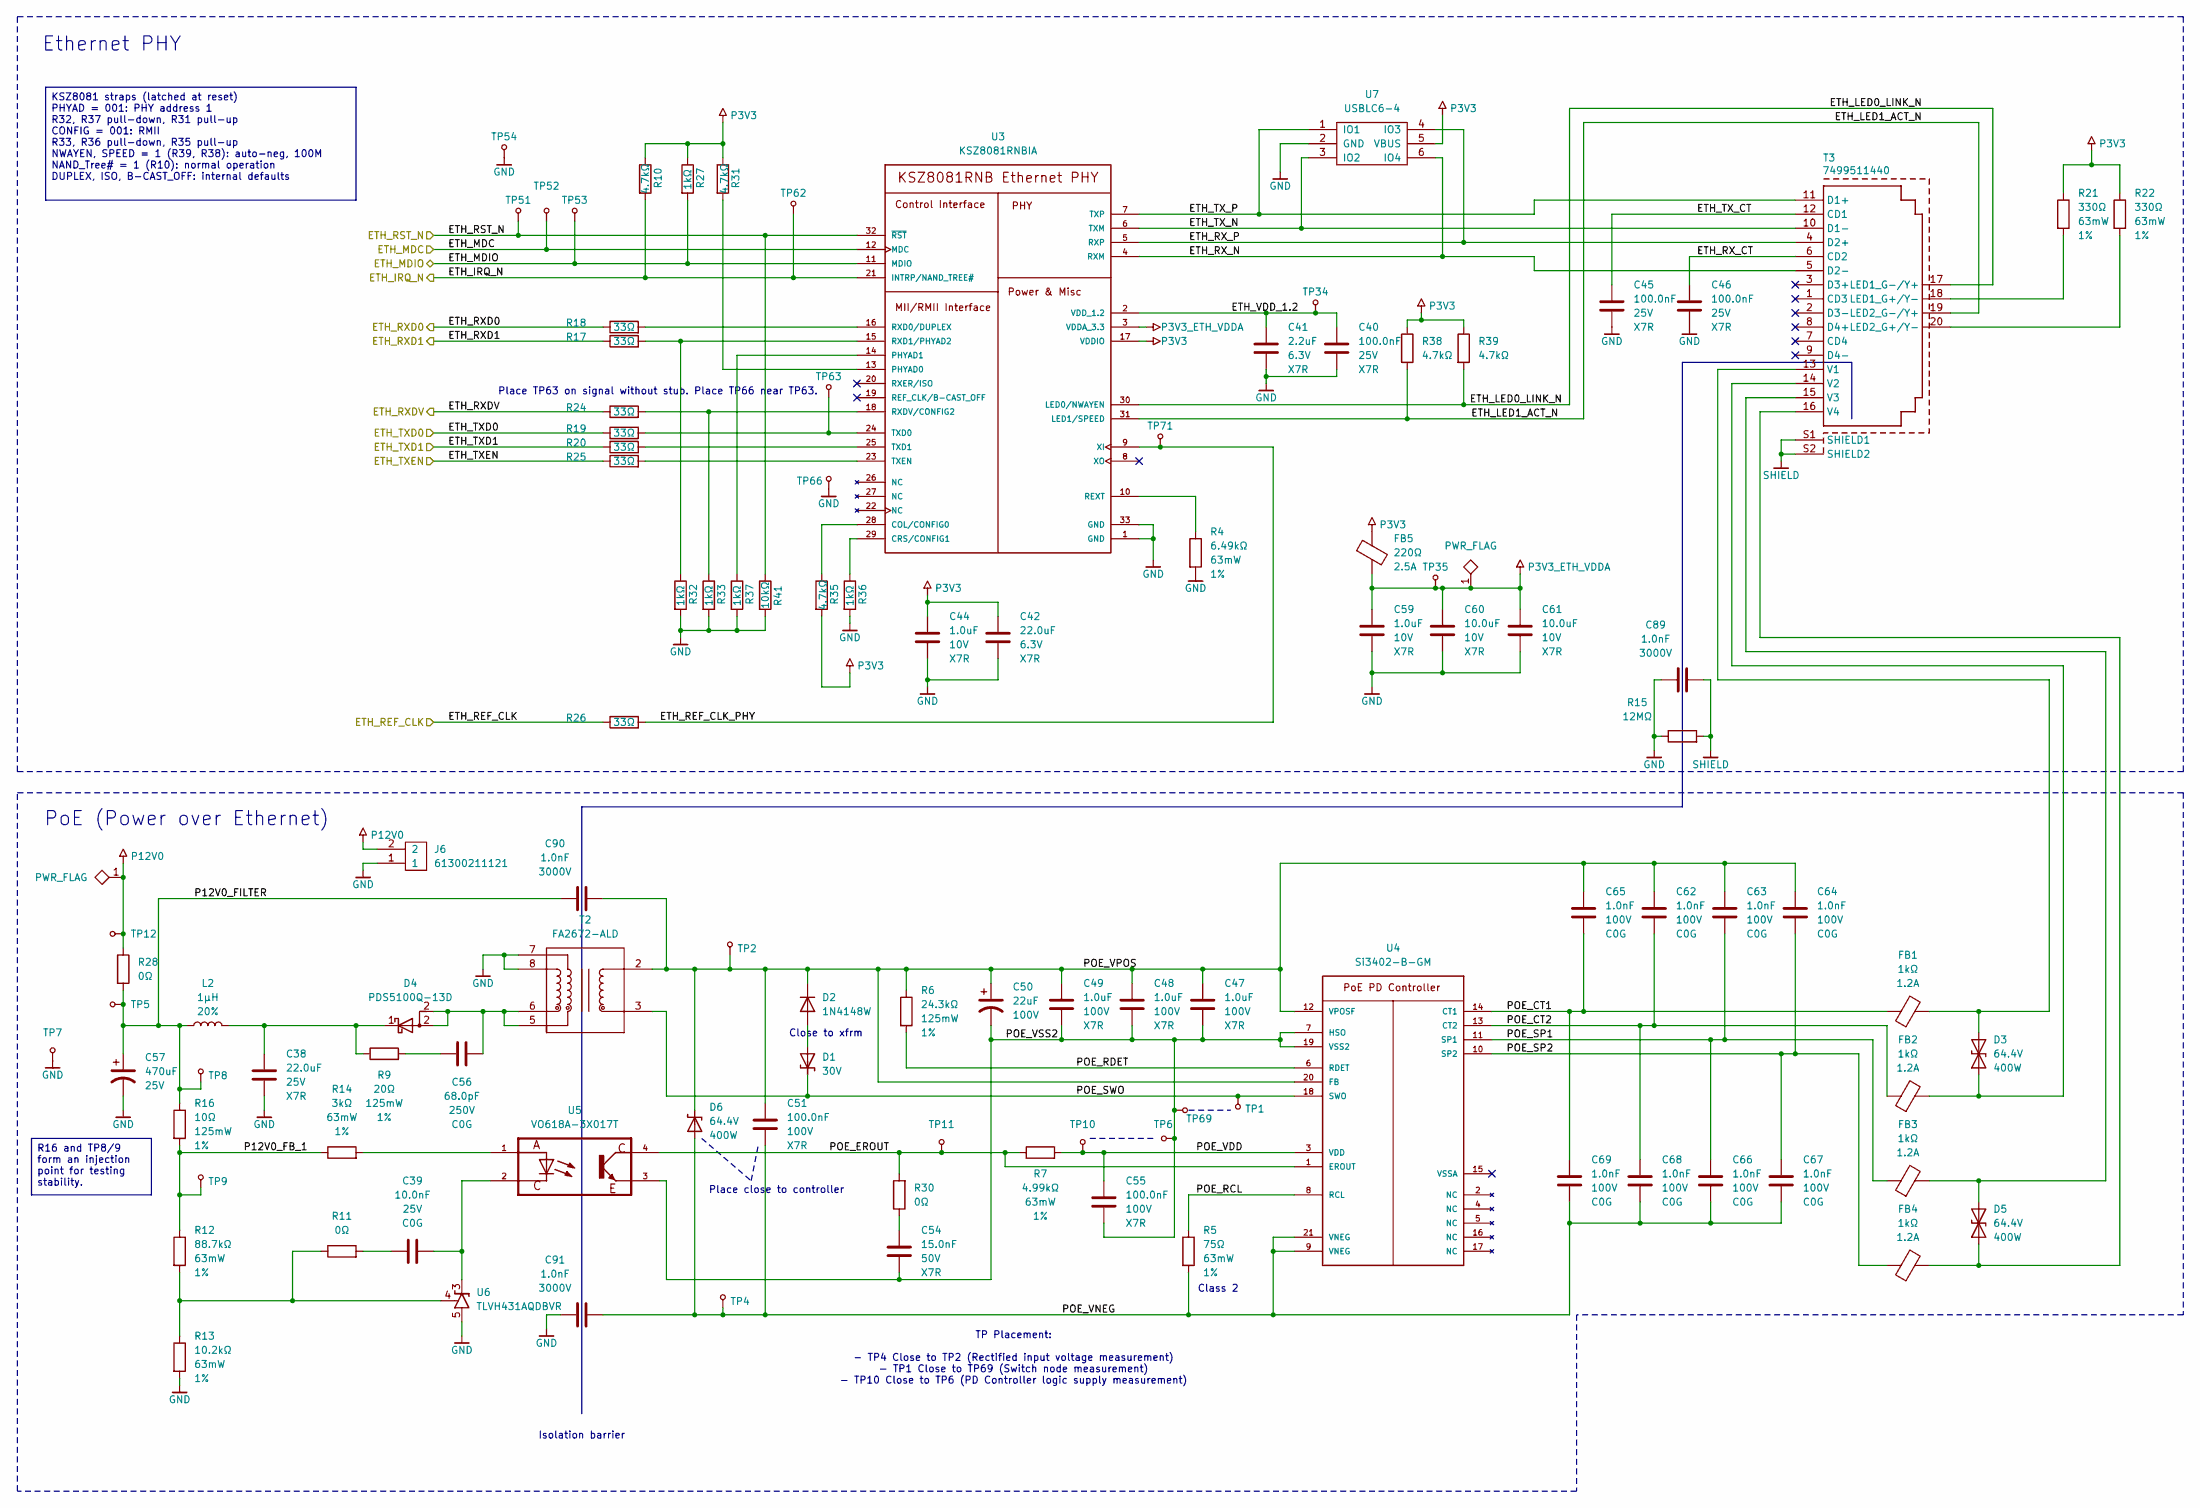
[picture p6: schematic ethernet_poe.kicad_sch, PoEtato - Ethernet PHY and PoE PD]

Parts:
C38: 22.0uF; C_1210_3225Metric; Voltage 25V; Part Number GRM32ER71E226KE15
C39: 10.0nF; C_0402_1005Metric; Voltage 25V; Part Number GRM1555C1E103JE01
C40, C45, C46: 100.0nF; C_0402_1005Metric; Voltage 25V; Part Number GRM155R71E104KE14
C41: 2.2uF; C_0603_1608Metric; Voltage 6.3V; Part Number GRM188R70J225KE15
C42: 22.0uF; C_0805_2012Metric; Voltage 6.3V; Part Number GRM21BZ70J226ME44
C44, C59: 1.0uF; C_0402_1005Metric; Voltage 10V; Part Number GRM155Z71A105KE01
C47, C48, C49: 1.0uF; C_1206_3216Metric; Voltage 100V; Part Number GRM31CR72A105KA01
C50: 22uF; CP_Elec_8x10; Voltage 100V; Part Number EMVE101ARA220MHA0G
C51, C55: 100.0nF; C_0603_1608Metric; Voltage 100V; Part Number GRM188R72A104KA35
C54: 15.0nF; C_0402_1005Metric; Voltage 50V; Part Number GRM155R71H153KA12
C56: 68.0pF; C_0805_2012Metric; Voltage 250V; Part Number GRM21A5C2E680FW01
C57: 470uF; CP_Elec_8x10; Voltage 25V; Part Number EMZL250ARA471MHA0G
C60, C61: 10.0uF; C_0805_2012Metric; Voltage 10V; Part Number GRM21BR71A106KA73
C62, C63, C64, C65, C66, C67, C68, C69: 1.0nF; C_0603_1608Metric; Voltage 100V; Part Number GRM1885C2A102JA01
C89, C90, C91: 1.0nF; C_1808_4520Metric; Voltage 3000V; Part Number C1808C102KHRACTU
D1: 30V; D_PowerDI-123; Part Number DFLT30A-7
D2: 1N4148W; D_SOD-123; Part Number 1N4148W
D3, D5: 64.4V; D_SMA; Breakdown Voltage 64.4V; Standoff Voltage 58V; Part Number SMAJ58CA
D4: PDS5100Q-13D; D_PowerDI-5; Part Number PDS5100Q-13D
D6: 64.4V; D_SMA; Breakdown Voltage 64.4V; Standoff Voltage 58V; Part Number SMAJ58A
FB1, FB2, FB3, FB4: 1kΩ; L_0603_1608Metric; Tolerance ±25%; Part Number BLM18SP102SH1
FB5: 220Ω; L_0603_1608Metric; Tolerance ±25%; Part Number BLM18SG221TN1
J6: 61300211121; PinHeader_1x02_P2.54mm_Vertical; Part Number 61300211121
L2: 1µH; IHLP1212AE; Tolerance 20%; Part Number IHLP1212AEEZ1R0M1Z
R4: 6.49kΩ; R_0402_1005Metric; Tolerance 1%; Part Number CRCW04026K49FKED
R5: 75Ω; R_0402_1005Metric; Tolerance 1%; Part Number CRCW040275R0FKED
R6: 24.3kΩ; R_0805_2012Metric; Tolerance 1%; Part Number CRCW080524K3FKEA
R7: 4.99kΩ; R_0402_1005Metric; Tolerance 1%; Part Number CRCW04024K99FKED
R9: 20Ω; R_0805_2012Metric; Tolerance 1%; Part Number CRCW080520R0FKEA
R10, R31, R35, R38, R39: 4.7kΩ; R_0402_1005Metric; Tolerance 1%; Part Number CRCW04024K70FKED
R11, R30: 0Ω; R_0402_1005Metric; Part Number CRCW04020000Z0EDHP
R12: 88.7kΩ; R_0402_1005Metric; Tolerance 1%; Part Number CRCW040288K7FKED
R13: 10.2kΩ; R_0402_1005Metric; Tolerance 1%; Part Number CRCW040210K2FKED
R14: 3kΩ; R_0402_1005Metric; Tolerance 1%; Part Number CRCW04023K00FKED
R15: 12MΩ; R_2512_6332Metric; Part Number CRHV2512AF12M0FKE5
R16: 10Ω; R_0805_2012Metric; Tolerance 1%; Part Number CRCW080510R0FKEA
R17, R18, R19, R20, R24, R25, R26: 33Ω; R_0402_1005Metric; Tolerance 1%; Part Number CRCW040233R0FKED
R21, R22: 330Ω; R_0402_1005Metric; Tolerance 1%; Part Number CRCW0402330RFKED
R27, R32, R33, R36, R37: 1kΩ; R_0402_1005Metric; Tolerance 1%; Part Number CRCW04021K00FKED
R28: 0Ω; R_0805_2012Metric; Part Number CRCW08050000Z0EAHP
R41: 10kΩ; R_0402_1005Metric; Tolerance 1%; Part Number CRCW040210K0FKED
T2: FA2672-ALD; Coilcraft_FA2672; Part Number FA2672-ALD
T3: 7499511440; T_Wurth_WE-RJ45LAN_7499511440; Part Number 7499511440
TP1, TP2, TP4, TP5, TP6, TP7, TP8, TP9, TP10, TP11, TP12, TP34, TP35, TP51, TP52, TP53, TP54, TP62, TP63, TP66, TP69, TP71: TP; TestPoint_Pad_D1.0mm
U3: KSZ8081RNBIA; QFN-32-1EP_5x5mm_P0.5mm_EP3.1x3.1mm; Part Number KSZ8081RNBIA
U4: Si3402-B-GM; QFN-20_5x5mm_EP2.7x2.7mm_P0.8mm; Part Number Si3402-B-GM
U5: VO618A-3X017T; Vishay_SOIC254P1016X440-4N; Part Number VO618A-3X017T
U6: TLVH431AQDBVR; SOT-23-5; Part Number TLVH431AQDBVR
U7: USBLC6-4; SOT-23-6; Part Number USBLC6-4SC6Y

Connections:
/Ethernet & PoE/ETH_IRQ_N: R10.2, TP62.1, U3.21 (INTRP/NAND_TREE#); also elsewhere on the board
/Ethernet & PoE/ETH_LED0_LINK_N: R39.2, T3.17 (LED1_G-/Y+), U3.30 (LED0/NWAYEN)
/Ethernet & PoE/ETH_LED1_ACT_N: R38.2, T3.19 (LED2_G-/Y+), U3.31 (LED1/SPEED)
/Ethernet & PoE/ETH_MDC: TP52.1, U3.12 (MDC); also elsewhere on the board
/Ethernet & PoE/ETH_MDIO: R27.2, TP53.1, U3.11 (MDIO); also elsewhere on the board
/Ethernet & PoE/ETH_REF_CLK: R26.1; also elsewhere on the board
/Ethernet & PoE/ETH_REF_CLK_PHY: R26.2, TP71.1, U3.9 (XI)
/Ethernet & PoE/ETH_RST_N: R41.1, TP51.1, U3.32 (~RST); also elsewhere on the board
/Ethernet & PoE/ETH_RXD0: R18.1; also elsewhere on the board
/Ethernet & PoE/ETH_RXD1: R17.1; also elsewhere on the board
/Ethernet & PoE/ETH_RXDV: R24.1; also elsewhere on the board
/Ethernet & PoE/ETH_RX_CT: C46.1, T3.6 (CD2)
/Ethernet & PoE/ETH_RX_N: T3.5 (D2-), U3.4 (RXM), U7.6 (IO4)
/Ethernet & PoE/ETH_RX_P: T3.4 (D2+), U3.5 (RXP), U7.4 (IO3)
/Ethernet & PoE/ETH_TXD0: R19.1; also elsewhere on the board
/Ethernet & PoE/ETH_TXD1: R20.1; also elsewhere on the board
/Ethernet & PoE/ETH_TXEN: R25.1; also elsewhere on the board
/Ethernet & PoE/ETH_TX_CT: C45.1, T3.12 (CD1)
/Ethernet & PoE/ETH_TX_N: T3.10 (D1-), U3.6 (TXM), U7.3 (IO2)
/Ethernet & PoE/ETH_TX_P: T3.11 (D1+), U3.7 (TXP), U7.1 (IO1)
/Ethernet & PoE/ETH_VDD_1.2: C40.1, C41.1, TP34.1, U3.2 (VDD_1.2)
/Ethernet & PoE/P12V0_FB_1: R12.1, R14.1, R16.2, TP9.1
/Ethernet & PoE/P12V0_FILTER: C57.1, C90.1, L2.1, R16.1, R28.2, TP5.1, TP8.1
/Ethernet & PoE/POE_CT1: C65.2, C69.1, FB1.1, U4.14 (CT1)
/Ethernet & PoE/POE_CT2: C62.2, C68.1, FB2.1, U4.13 (CT2)
/Ethernet & PoE/POE_EROUT: R7.1, R30.2, TP11.1, U4.1 (EROUT), U5.4
/Ethernet & PoE/POE_RCL: R5.1, U4.8 (RCL)
/Ethernet & PoE/POE_RDET: R6.2, U4.6 (RDET)
/Ethernet & PoE/POE_SP1: C63.2, C66.1, FB3.1, U4.11 (SP1)
/Ethernet & PoE/POE_SP2: C64.2, C67.1, FB4.1, U4.10 (SP2)
/Ethernet & PoE/POE_SWO: D1.1 (A1), T2.3, TP1.1, U4.18 (SWO)
/Ethernet & PoE/POE_VDD: C55.1, R7.2, TP10.1, U4.3 (VDD)
/Ethernet & PoE/POE_VNEG: C51.2, C66.2, C67.2, C68.2, C69.2, C91.2, D6.2 (A2), R5.2, TP4.1, U4.9 (VNEG), U4.21 (VNEG)
/Ethernet & PoE/POE_VPOS: C47.1, C48.1, C49.1, C50.1, C51.1, C62.1, C63.1, C64.1, C65.1, C90.2, D2.1 (K), D6.1 (A1), R6.1, T2.2, TP2.1, U4.12 (VPOSF), U4.20 (FB)
/Ethernet & PoE/POE_VSS2: C47.2, C48.2, C49.2, C50.2, C54.2, C55.2, TP6.1, TP69.1, U4.7 (HSO), U4.19 (VSS2), U5.3
GND: C38.2, C40.2, C41.2, C42.2, C44.2, C45.2, C46.2, C57.2, C59.2, C60.2, C61.2, C89.1, C91.1, J6.1, R4.2, R13.2, R15.1, R32.2, R33.2, R36.2, R37.2, R41.2, T2.7, T2.8, TP7.1, TP54.1, TP66.1, U3.1 (GND), U3.33 (GND), U6.5, U7.2 (GND); also elsewhere on the board
unnamed: C39.1, R11.2
unnamed: C39.2, U5.2, U6.3
unnamed: C54.1, R30.1
unnamed: C56.1, R9.2
unnamed: D1.2 (A2), D2.2 (A)
unnamed: D3.1 (A1), FB2.2, T3.14 (V2)
unnamed: D3.2 (A2), FB1.2, T3.13 (V1)
unnamed: C56.2, D4.2 (A), T2.5, T2.6
unnamed: C38.1, D4.1 (K), L2.2, R9.1
unnamed: D5.1 (A1), FB4.2, T3.16 (V4)
unnamed: D5.2 (A2), FB3.2, T3.15 (V3)
unnamed: R11.1, R12.2, R13.1, U6.4
unnamed: R14.2, U5.1
unnamed: R21.2, T3.18 (LED1_G+/Y-)
unnamed: R22.2, T3.20 (LED2_G+/Y-)
unnamed: R35.1, U3.28 (COL/CONFIG0)
unnamed: R36.1, U3.29 (CRS/CONFIG1)
unnamed: R31.2, U3.13 (PHYAD0)
unnamed: R37.1, U3.14 (PHYAD1)
unnamed: R4.1, U3.10 (REXT)
unnamed: R18.2, U3.16 (RXD0/DUPLEX)
unnamed: R17.2, R32.1, U3.15 (RXD1/PHYAD2)
unnamed: R24.2, R33.1, U3.18 (RXDV/CONFIG2)
unnamed: R19.2, TP63.1, U3.24 (TXD0)
unnamed: R20.2, U3.25 (TXD1)
unnamed: R25.2, U3.23 (TXEN)
P3V3: C42.1, C44.1, FB5.1, R10.1, R21.1, R22.1, R27.1, R31.1, R35.2, R38.1, R39.1, U3.17 (VDDIO), U7.5 (VBUS); also elsewhere on the board
P3V3_ETH_VDDA: C59.1, C60.1, C61.1, FB5.2, TP35.1, U3.3 (VDDA_3.3)
P12V0: J6.2, R28.1, TP12.1; also elsewhere on the board
SHIELD: C89.2, R15.2, T3.S1 (SHIELD1), T3.S2 (SHIELD2); also elsewhere on the board

Notes on the sheet:
Isolation barrier
PoE (Power over Ethernet)
Place close to controller
Ethernet PHY
Class 2
TP Placement: - TP4 Close to TP2 (Rectified input voltage measurement) - TP1 Close to TP69 (Switch node measurement) - TP10 Close to TP6 (PD Controller logic supply measurement)
Close to xfrm
Place TP63 on signal without stub. Place TP66 near TP63.
KSZ8081 straps (latched at reset) PHYAD = 001: PHY address 1 R32, R37 pull-down, R31 pull-up CONFIG = 001: RMII R33, R36 pull-down, R35 pull-up NWAYEN, SPEED = 1 (R39, R38): auto-neg, 100M NAND_Tree# = 1 (R10): normal operation DUPLEX, ISO, B-CAST_OFF: internal defaults
R16 and TP8/9 form an injection point for testing stability.
