jonasblixt/poetato/hw/poetato/poetato.kicad_pcb

## KiCad design hw/poetato/poetato.kicad_pcb (continued)

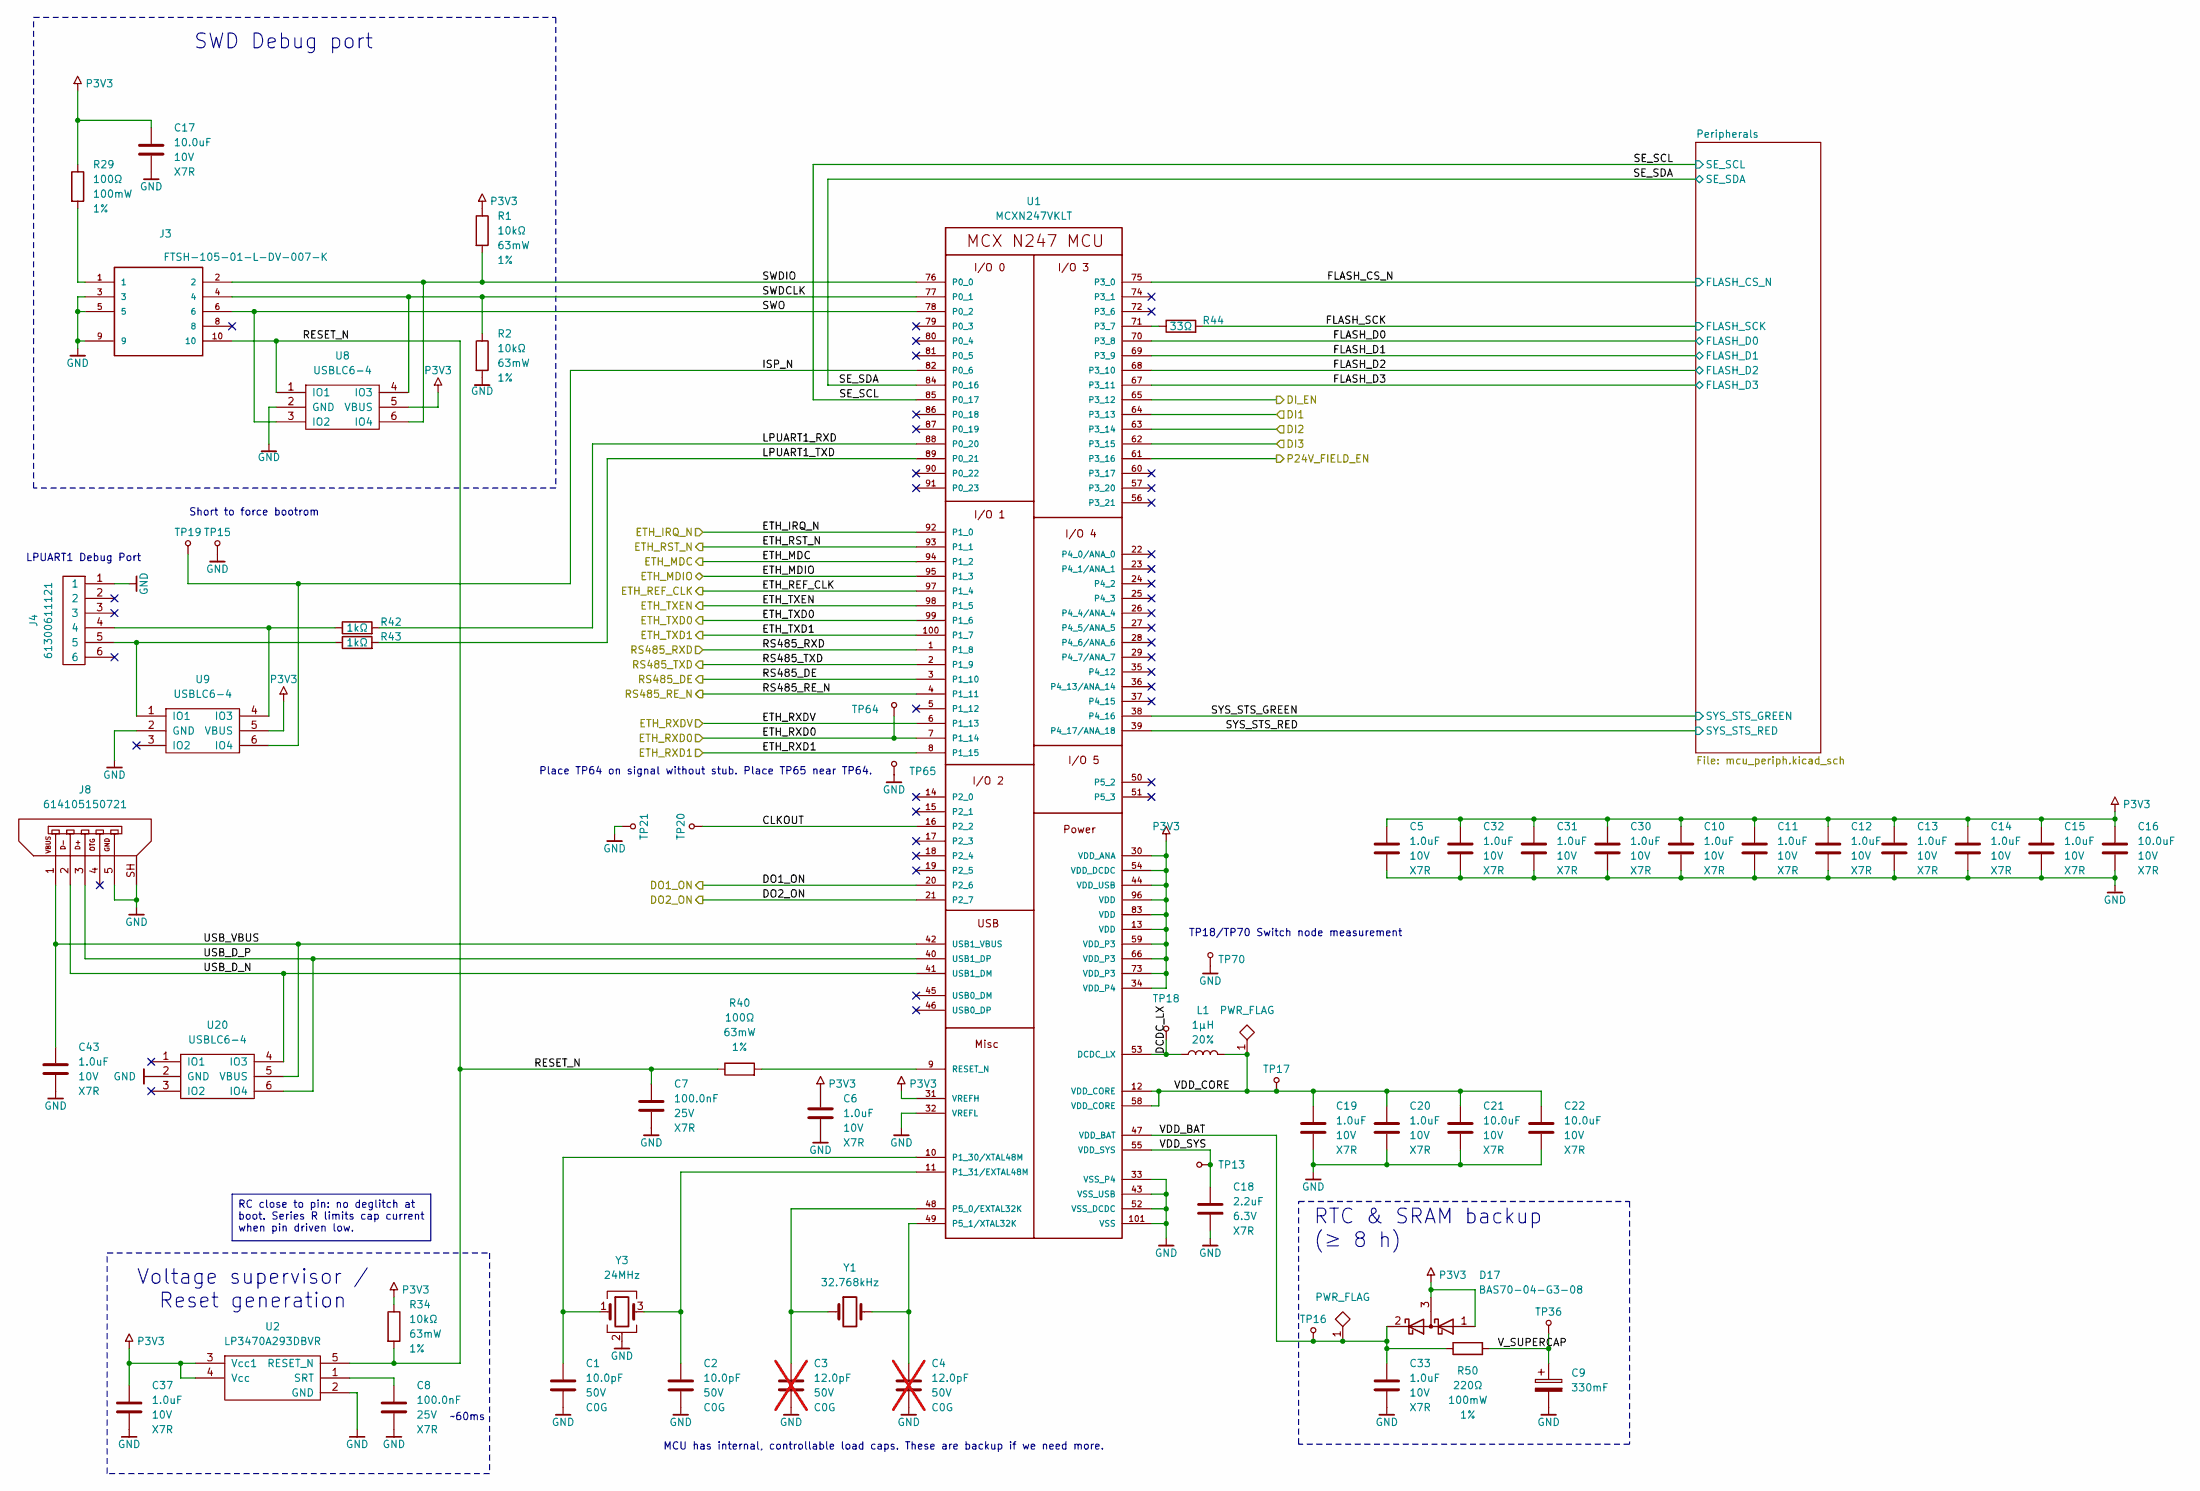
[picture p7: schematic mcu.kicad_sch, PoEtato - MCU core, debug and USB]

Parts:
C1, C2: 10.0pF; C_0402_1005Metric; Voltage 50V; Part Number GRM1555C1H100GA01
C3, C4: 12.0pF; C_0402_1005Metric; Voltage 50V; Part Number GRM1555C1H120GA01; not fitted
C5, C6, C10, C11, C12, C13, C14, C15, C19, C20, C30, C31, C32, C33, C37, C43: 1.0uF; C_0402_1005Metric; Voltage 10V; Part Number GRM155Z71A105KE01
C7, C8: 100.0nF; C_0402_1005Metric; Voltage 25V; Part Number GRM155R71E104KE14
C9: 330mF; Eaton_KW_13.5x8.8mm; Voltage 5.5V; Part Number KW-5R5C334H-R
C16, C17, C21, C22: 10.0uF; C_0805_2012Metric; Voltage 10V; Part Number GRM21BR71A106KA73
C18: 2.2uF; C_0603_1608Metric; Voltage 6.3V; Part Number GRM188R70J225KE15
D17: BAS70-04-G3-08; SOT-23; Part Number BAS70-04-G3-08
J3: FTSH-105-01-L-DV-007-K; SAMTEC_FTSH-105-01-L-DV-007-K; Part Number FTSH-105-01-L-DV-007-K-TR
J4: 61300611121; PinHeader_1x06_P2.54mm_Vertical; Part Number 61300611121
J8: 614105150721; USB_Micro-B_Wuerth_614105150721_Vertical; Part Number 614105150721
L1: 1µH; IHLP1212AE; Tolerance 20%; Part Number IHLP1212AEEZ1R0M1Z
R1, R2, R34: 10kΩ; R_0402_1005Metric; Tolerance 1%; Part Number CRCW040210K0FKED
R29: 100Ω; R_0603_1608Metric; Tolerance 1%; Part Number CRCW0603100RFKEA
R40: 100Ω; R_0402_1005Metric; Tolerance 1%; Part Number CRCW0402100RFKED
R42, R43: 1kΩ; R_0402_1005Metric; Tolerance 1%; Part Number CRCW04021K00FKED
R44: 33Ω; R_0402_1005Metric; Tolerance 1%; Part Number CRCW040233R0FKED
R50: 220Ω; R_0603_1608Metric; Tolerance 1%; Part Number CRCW0603220RFKEA
TP13, TP15, TP16, TP17, TP18, TP19, TP20, TP21, TP36, TP64, TP65, TP70: TP; TestPoint_Pad_D1.0mm
U1: MCXN247VKLT; LQFP-100-1EP_14x14mm_P0.5mm_EP6.9x6.9mm; Part Number MCXN247VKLT
U2: LP3470A293DBVR; SOT-23-5; Part Number LP3470A293DBVR
U8, U9, U20: USBLC6-4; SOT-23-6; Part Number USBLC6-4SC6Y
Y1: 32.768kHz; NX3215SA; Frequency Tolerance ±20ppm; Part Number X1A0001410006
Y3: 24MHz; NX3225SA; Frequency Tolerance ±10ppm; Part Number X1E0000210048

Connections:
/Ethernet & PoE/ETH_IRQ_N: U1.92 (P1_0); also elsewhere on the board
/Ethernet & PoE/ETH_MDC: U1.94 (P1_2); also elsewhere on the board
/Ethernet & PoE/ETH_MDIO: U1.95 (P1_3); also elsewhere on the board
/Ethernet & PoE/ETH_REF_CLK: U1.97 (P1_4); also elsewhere on the board
/Ethernet & PoE/ETH_RST_N: U1.93 (P1_1); also elsewhere on the board
/Ethernet & PoE/ETH_RXD0: TP64.1, U1.7 (P1_14); also elsewhere on the board
/Ethernet & PoE/ETH_RXD1: U1.8 (P1_15); also elsewhere on the board
/Ethernet & PoE/ETH_RXDV: U1.6 (P1_13); also elsewhere on the board
/Ethernet & PoE/ETH_TXD0: U1.99 (P1_6); also elsewhere on the board
/Ethernet & PoE/ETH_TXD1: U1.100 (P1_7); also elsewhere on the board
/Ethernet & PoE/ETH_TXEN: U1.98 (P1_5); also elsewhere on the board
/IO/DI1: U1.64 (P3_13); also elsewhere on the board
/IO/DI2: U1.63 (P3_14); also elsewhere on the board
/IO/DI3: U1.62 (P3_15); also elsewhere on the board
/IO/DI_EN: U1.65 (P3_12); also elsewhere on the board
/MCU/CLKOUT: TP20.1, U1.16 (P2_2)
/MCU/DCDC_LX: L1.1, TP18.1, U1.53 (DCDC_LX)
/MCU/DO1_ON: U1.20 (P2_6); also elsewhere on the board
/MCU/DO2_ON: U1.21 (P2_7); also elsewhere on the board
/MCU/FLASH_CS_N: U1.75 (P3_0); also elsewhere on the board
/MCU/FLASH_D0: U1.70 (P3_8); also elsewhere on the board
/MCU/FLASH_D1: U1.69 (P3_9); also elsewhere on the board
/MCU/FLASH_D2: U1.68 (P3_10); also elsewhere on the board
/MCU/FLASH_D3: U1.67 (P3_11); also elsewhere on the board
/MCU/FLASH_SCK: R44.2; also elsewhere on the board
/MCU/ISP_N: TP19.1, U1.82 (P0_6), U9.6 (IO4)
/MCU/LPUART1_RXD: R42.2, U1.88 (P0_20)
/MCU/LPUART1_TXD: R43.2, U1.89 (P0_21)
/MCU/P24V_FIELD_EN: U1.61 (P3_16); also elsewhere on the board
/MCU/RESET_N: C7.1, J3.10, R34.2, R40.1, U2.5 (RESET_N), U8.1 (IO1)
/MCU/RS485_DE: U1.3 (P1_10); also elsewhere on the board
/MCU/RS485_RE_N: U1.4 (P1_11); also elsewhere on the board
/MCU/RS485_RXD: U1.1 (P1_8); also elsewhere on the board
/MCU/RS485_TXD: U1.2 (P1_9); also elsewhere on the board
/MCU/SE_SCL: U1.85 (P0_17); also elsewhere on the board
/MCU/SE_SDA: U1.84 (P0_16); also elsewhere on the board
/MCU/SWDCLK: J3.4, R2.1, U1.77 (P0_1), U8.4 (IO3)
/MCU/SWDIO: J3.2, R1.2, U1.76 (P0_0), U8.6 (IO4)
/MCU/SWO: J3.6, U1.78 (P0_2), U8.3 (IO2)
/MCU/SYS_STS_GREEN: U1.38 (P4_16); also elsewhere on the board
/MCU/SYS_STS_RED: U1.39 (P4_17/ANA_18); also elsewhere on the board
/MCU/USB_D_N: J8.2, U1.41 (USB1_DM), U20.4 (IO3)
/MCU/USB_D_P: J8.3, U1.40 (USB1_DP), U20.6 (IO4)
/MCU/USB_VBUS: C43.1, J8.1, U1.42 (USB1_VBUS), U20.5 (VBUS)
/MCU/VDD_BAT: C33.1, D17.2 (K), R50.1, TP16.1, U1.47 (VDD_BAT)
/MCU/VDD_CORE: C19.1, C20.1, C21.1, C22.1, L1.2, TP17.1, U1.12 (VDD_CORE), U1.58 (VDD_CORE)
/MCU/VDD_SYS: C18.1, TP13.1, U1.55 (VDD_SYS)
/MCU/V_SUPERCAP: C9.1, R50.2, TP36.1
GND: C1.2, C2.2, C3.2, C4.2, C5.2, C6.2, C7.2, C8.2, C9.2, C10.2, C11.2, C12.2, C13.2, C14.2, C15.2, C16.2, C17.2, C18.2, C19.2, C20.2, C21.2, C22.2, C30.2, C31.2, C32.2, C33.2, C37.2, C43.2, J3.3, J3.5, J3.9, J4.1, J8.5, J8.SH, R2.2, TP15.1, TP21.1, TP65.1, TP70.1, U1.32 (VREFL), U1.33 (VSS_P4), U1.43 (VSS_USB), U1.52 (VSS_DCDC), U1.101 (VSS), U2.2 (GND), U8.2 (GND), U9.2 (GND), U20.2 (GND), Y3.2 (G), Y3.4 (G); also elsewhere on the board
unnamed: J3.1, R29.2
unnamed: C1.1, U1.10 (P1_30/XTAL48M), Y3.1
unnamed: C2.1, U1.11 (P1_31/EXTAL48M), Y3.3
unnamed: R44.1, U1.71 (P3_7)
unnamed: C3.1, U1.48 (P5_0/EXTAL32K), Y1.1
unnamed: C4.1, U1.49 (P5_1/XTAL32K), Y1.2
unnamed: R40.2, U1.9 (RESET_N)
unnamed: C8.1, U2.1 (SRT)
unnamed: J4.5, R43.1, U9.1 (IO1)
unnamed: J4.4, R42.1, U9.4 (IO3)
P3V3: C5.1, C6.1, C10.1, C11.1, C12.1, C13.1, C14.1, C15.1, C16.1, C17.1, C30.1, C31.1, C32.1, C37.1, D17.1 (A), D17.3 (common), R1.1, R29.1, R34.1, U1.13 (VDD), U1.30 (VDD_ANA), U1.31 (VREFH), U1.34 (VDD_P4), U1.44 (VDD_USB), U1.54 (VDD_DCDC), U1.59 (VDD_P3), U1.66 (VDD_P3), U1.73 (VDD_P3), U1.83 (VDD), U1.96 (VDD), U2.3 (Vcc1), U2.4 (Vcc), U8.5 (VBUS), U9.5 (VBUS); also elsewhere on the board

Notes on the sheet:
~60ms
RTC & SRAM backup (≥ 8 h)
Voltage supervisor / Reset generation
SWD Debug port
MCU has internal, controllable load caps. These are backup if we need more.
Short to force bootrom
LPUART1 Debug Port
Place TP64 on signal without stub. Place TP65 near TP64.
TP18/TP70 Switch node measurement
RC close to pin: no deglitch at boot. Series R limits cap current when pin driven low.

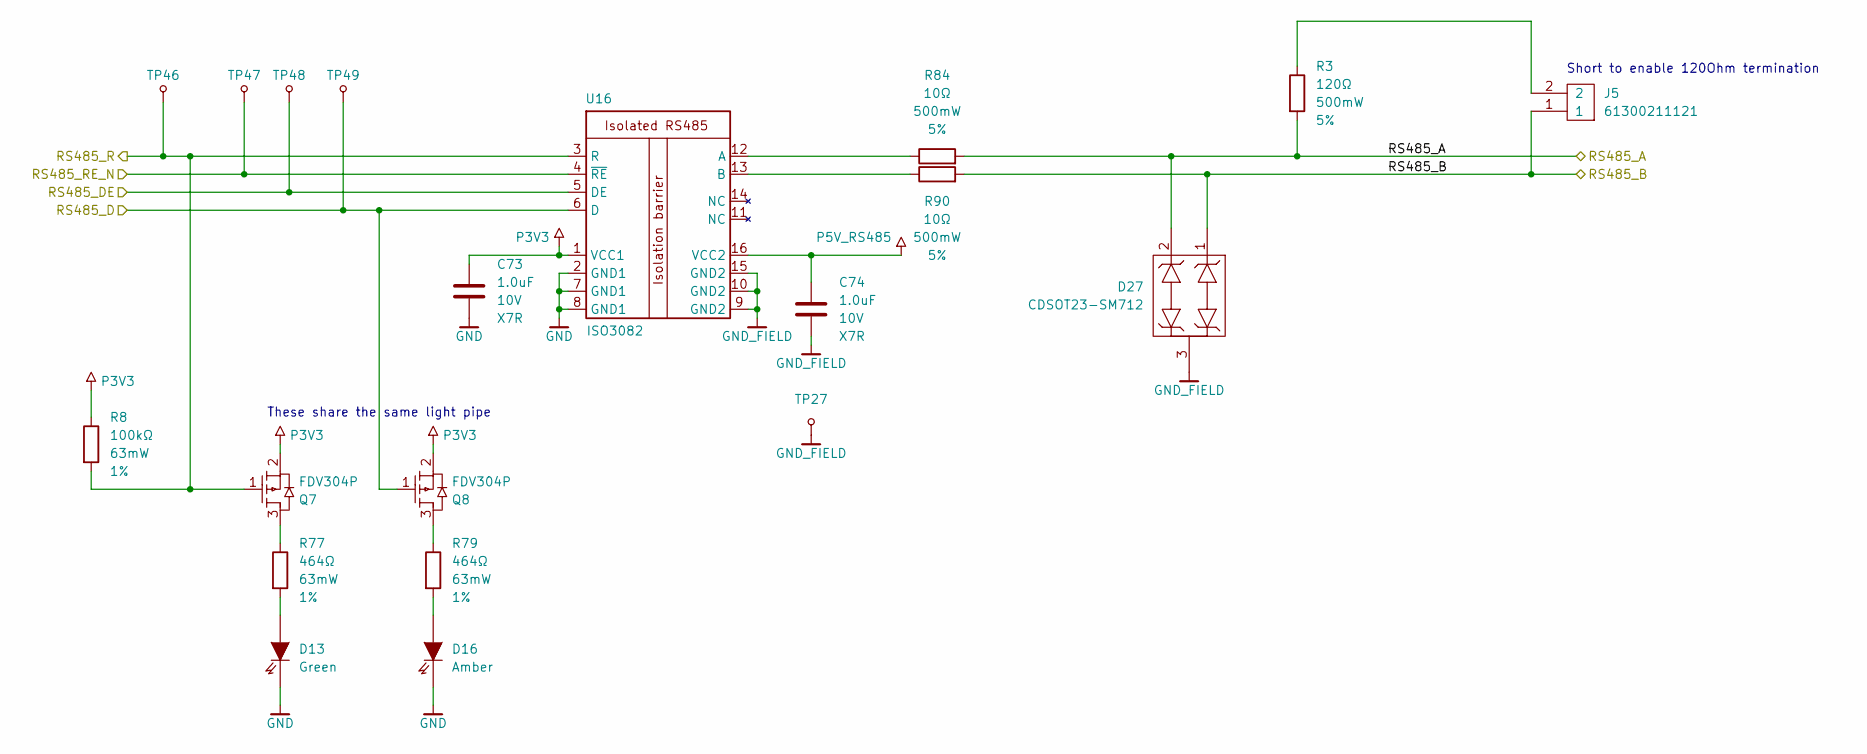
[picture p8: schematic rs485.kicad_sch, PoEtato - Isolated RS-485]

Parts:
C73, C74: 1.0uF; C_0402_1005Metric; Voltage 10V; Part Number GRM155Z71A105KE01
D13: LED0402_150040VS73240; LED_0402_1005Metric; Part Number 150040VS73240
D16: LED0402_150040AS73240; LED_0402_1005Metric; Part Number 150040AS73240
D27: CDSOT23-SM712; SOT-23; Part Number CDSOT23-SM712
J5: 61300211121; PinHeader_1x02_P2.54mm_Vertical; Part Number 61300211121
Q7, Q8: FDV304P; SOT-23; Part Number FDV304P
R3: 120Ω; R_1210_3225Metric; Tolerance 5%; Part Number ERJT14J121U
R8: 100kΩ; R_0402_1005Metric; Tolerance 1%; Part Number CRCW0402100KFKED
R77, R79: 464Ω; R_0402_1005Metric; Tolerance 1%; Part Number CRCW0402464RFKED
R84, R90: 10Ω; R_1210_3225Metric; Tolerance 5%; Part Number ERJT14J100U
TP27, TP46, TP47, TP48, TP49: TP; TestPoint_Pad_D1.0mm
U16: ISO3082; SOIC-16W_7.5x10.3mm_P1.27mm; Part Number ISO3082DWR

Connections:
/IO/RS485/RS485_A: D27.2, R3.2, R84.2; also elsewhere on the board
/IO/RS485/RS485_B: D27.1, J5.1, R90.2; also elsewhere on the board
/MCU/RS485_DE: TP48.1, U16.5 (DE); also elsewhere on the board
/MCU/RS485_RE_N: TP47.1, U16.4 (~RE); also elsewhere on the board
/MCU/RS485_RXD: Q7.1, R8.2, TP46.1, U16.3 (R); also elsewhere on the board
/MCU/RS485_TXD: Q8.1, TP49.1, U16.6 (D); also elsewhere on the board
GND: C73.2, D13.1, D16.1, U16.2 (GND1), U16.7 (GND1), U16.8 (GND1); also elsewhere on the board
GND_FIELD: C74.2, D27.3, TP27.1, U16.9 (GND2), U16.10 (GND2), U16.15 (GND2); also elsewhere on the board
unnamed: D13.2, R77.2
unnamed: D16.2, R79.2
unnamed: J5.2, R3.1
unnamed: Q7.3, R77.1
unnamed: Q8.3, R79.1
unnamed: R84.1, U16.12 (A)
unnamed: R90.1, U16.13 (B)
P3V3: C73.1, Q7.2, Q8.2, R8.1, U16.1 (VCC1); also elsewhere on the board
P5V_RS485: C74.1, U16.16 (VCC2); also elsewhere on the board

Notes on the sheet:
These share the same light pipe
Short to enable 120Ohm termination

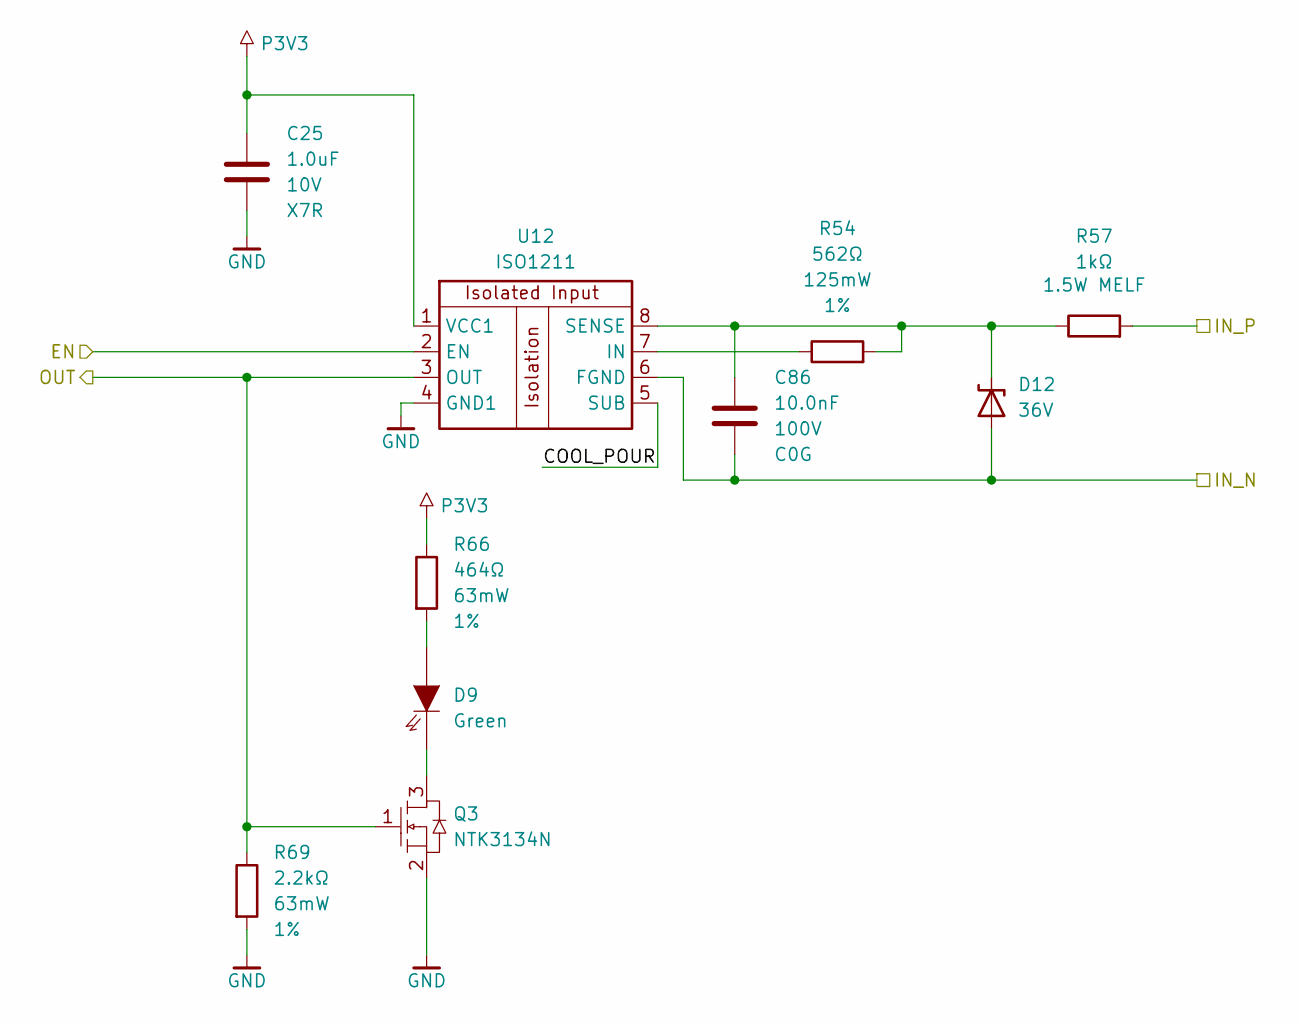
[picture p9: schematic di.kicad_sch, PoEtato - Digital input (ISO1211), one channel]

Parts:
C25: 1.0uF; C_0402_1005Metric; Voltage 10V; Part Number GRM155Z71A105KE01
C86: 10.0nF; C_0805_2012Metric; Voltage 100V; Part Number GRM2195C2A103JA01
D9: LED0402_150040VS73240; LED_0402_1005Metric; Part Number 150040VS73240
D12: 36V; D_SOD-123; Part Number SMF36A
Q3: NTK3134N; SOT-723; Part Number NTK3134NT1G
R54: 562Ω; R_0805_2012Metric; Tolerance 1%; Part Number CRCW0805562RFKEA
R57: 1kΩ; R_MiniMELF_MMA-0204; Part Number SMM02040C1001FB300
R66: 464Ω; R_0402_1005Metric; Tolerance 1%; Part Number CRCW0402464RFKED
R69: 2.2kΩ; R_0402_1005Metric; Tolerance 1%; Part Number CRCW04022K20FKED
U12: ISO1211; SOIC-8_3.9x4.9mm_P1.27mm; Part Number ISO1211DR

Connections:
/IO/DI1: Q3.1, R69.1, U12.3 (OUT); also elsewhere on the board
/IO/DI1/COOL_POUR: U12.5 (SUB)
/IO/DI_EN: U12.2 (EN); also elsewhere on the board
/IO/IN1_N: C86.2, D12.2 (A2), U12.6 (FGND); also elsewhere on the board
/IO/IN1_P: R57.2; also elsewhere on the board
GND: C25.2, Q3.2, R69.2, U12.4 (GND1); also elsewhere on the board
unnamed: D9.1, Q3.3
unnamed: D9.2, R66.2
unnamed: C86.1, D12.1 (A1), R54.2, R57.1, U12.8 (SENSE)
unnamed: R54.1, U12.7 (IN)
P3V3: C25.1, R66.1, U12.1 (VCC1); also elsewhere on the board

Parts of its further copies:
C26, C27: 1.0uF; C_0402_1005Metric; Voltage 10V; Part Number GRM155Z71A105KE01
C87, C88: 10.0nF; C_0805_2012Metric; Voltage 100V; Part Number GRM2195C2A103JA01
D10, D11: LED0402_150040VS73240; LED_0402_1005Metric; Part Number 150040VS73240
D20, D21: 36V; D_SOD-123; Part Number SMF36A
Q11, Q13: NTK3134N; SOT-723; Part Number NTK3134NT1G
R55, R56: 562Ω; R_0805_2012Metric; Tolerance 1%; Part Number CRCW0805562RFKEA
R58, R59: 1kΩ; R_MiniMELF_MMA-0204; Part Number SMM02040C1001FB300
R67, R68: 464Ω; R_0402_1005Metric; Tolerance 1%; Part Number CRCW0402464RFKED
R70, R71: 2.2kΩ; R_0402_1005Metric; Tolerance 1%; Part Number CRCW04022K20FKED
U13, U14: ISO1211; SOIC-8_3.9x4.9mm_P1.27mm; Part Number ISO1211DR

Connections of its further copies:
/IO/DI2: Q11.1, R70.1, U13.3 (OUT); also elsewhere on the board
/IO/DI2/COOL_POUR: U13.5 (SUB)
/IO/DI3: Q13.1, R71.1, U14.3 (OUT); also elsewhere on the board
/IO/DI3/COOL_POUR: U14.5 (SUB)
/IO/DI_EN: U13.2 (EN), U14.2 (EN); also elsewhere on the board
/IO/IN2_N: C87.2, D20.2 (A2), U13.6 (FGND); also elsewhere on the board
/IO/IN2_P: R58.2; also elsewhere on the board
/IO/IN3_N: C88.2, D21.2 (A2), U14.6 (FGND); also elsewhere on the board
/IO/IN3_P: R59.2; also elsewhere on the board
GND: C26.2, C27.2, Q11.2, Q13.2, R70.2, R71.2, U13.4 (GND1), U14.4 (GND1); also elsewhere on the board
unnamed: D10.1, Q11.3
unnamed: D10.2, R67.2
unnamed: D11.1, Q13.3
unnamed: D11.2, R68.2
unnamed: C87.1, D20.1 (A1), R55.2, R58.1, U13.8 (SENSE)
unnamed: C88.1, D21.1 (A1), R56.2, R59.1, U14.8 (SENSE)
unnamed: R55.1, U13.7 (IN)
unnamed: R56.1, U14.7 (IN)
P3V3: C26.1, C27.1, R67.1, R68.1, U13.1 (VCC1), U14.1 (VCC1); also elsewhere on the board

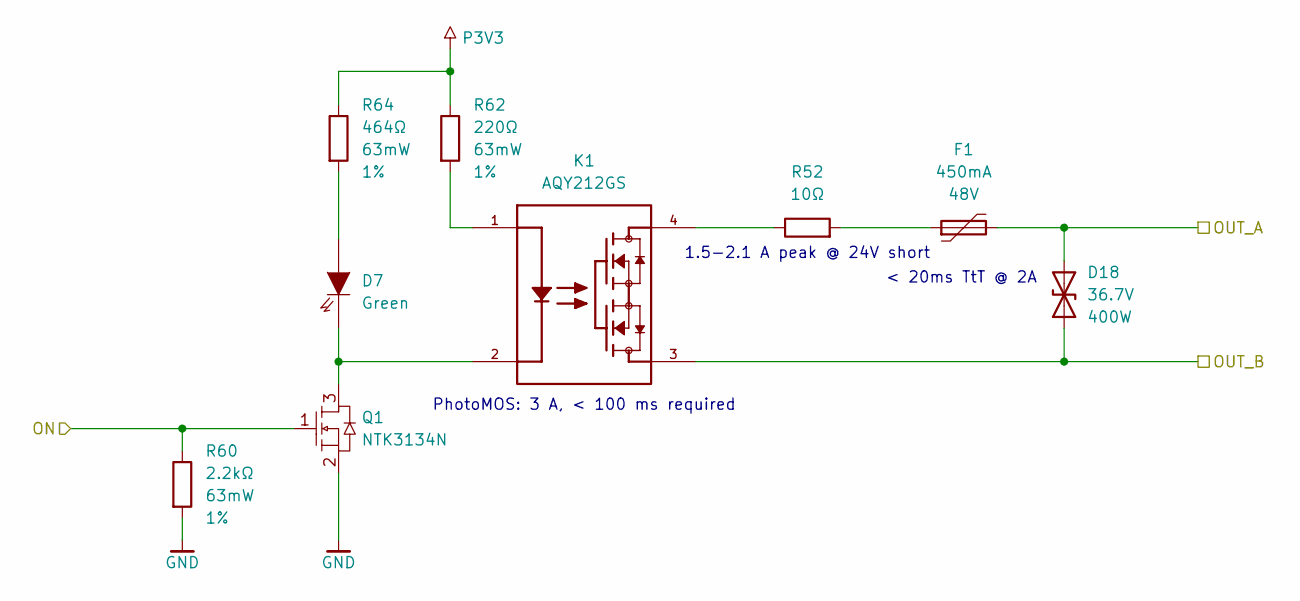
[picture p10: schematic do.kicad_sch, PoEtato - Digital output (PhotoMOS), one channel]

Parts:
D7: LED0402_150040VS73240; LED_0402_1005Metric; Part Number 150040VS73240
D18: 36.7V; D_SMA; Breakdown Voltage 36.7V; Standoff Voltage 33V; Part Number SMAJ33CA
F1: 450mA; FUSC3216X85N; Max Voltage 48V; Part Number 0ZCJ0016FF2E
K1: AQY212GS; SOIC254P680X230-4N; Part Number AQY212GS
Q1: NTK3134N; SOT-723; Part Number NTK3134NT1G
R52: 10Ω; R_2512_6332Metric; Part Number CRCW251210R0FKEGHP
R60: 2.2kΩ; R_0402_1005Metric; Tolerance 1%; Part Number CRCW04022K20FKED
R62: 220Ω; R_0402_1005Metric; Tolerance 1%; Part Number CRCW0402220RFKED
R64: 464Ω; R_0402_1005Metric; Tolerance 1%; Part Number CRCW0402464RFKED

Connections:
/IO/OUT1_A: D18.2 (A2), F1.2; also elsewhere on the board
/IO/OUT1_B: D18.1 (A1), K1.3; also elsewhere on the board
/MCU/DO1_ON: Q1.1, R60.1; also elsewhere on the board
GND: Q1.2, R60.2; also elsewhere on the board
unnamed: D7.1, K1.2, Q1.3
unnamed: D7.2, R64.2
unnamed: F1.1, R52.2
unnamed: K1.1, R62.2
unnamed: K1.4, R52.1
P3V3: R62.1, R64.1; also elsewhere on the board

Parts of its further copies:
D8: LED0402_150040VS73240; LED_0402_1005Metric; Part Number 150040VS73240
D19: 36.7V; D_SMA; Breakdown Voltage 36.7V; Standoff Voltage 33V; Part Number SMAJ33CA
F2: 450mA; FUSC3216X85N; Max Voltage 48V; Part Number 0ZCJ0016FF2E
K2: AQY212GS; SOIC254P680X230-4N; Part Number AQY212GS
Q12: NTK3134N; SOT-723; Part Number NTK3134NT1G
R53: 10Ω; R_2512_6332Metric; Part Number CRCW251210R0FKEGHP
R61: 2.2kΩ; R_0402_1005Metric; Tolerance 1%; Part Number CRCW04022K20FKED
R65: 464Ω; R_0402_1005Metric; Tolerance 1%; Part Number CRCW0402464RFKED
R96: 220Ω; R_0402_1005Metric; Tolerance 1%; Part Number CRCW0402220RFKED

Connections of its further copies:
/IO/OUT2_A: D19.2 (A2), F2.2; also elsewhere on the board
/IO/OUT2_B: D19.1 (A1), K2.3; also elsewhere on the board
/MCU/DO2_ON: Q12.1, R61.1; also elsewhere on the board
GND: Q12.2, R61.2; also elsewhere on the board
unnamed: D8.1, K2.2, Q12.3
unnamed: D8.2, R65.2
unnamed: F2.1, R53.2
unnamed: K2.1, R96.2
unnamed: K2.4, R53.1
P3V3: R65.1, R96.1; also elsewhere on the board

Notes on the sheet:
< 20ms TtT @ 2A
PhotoMOS: 3 A, < 100 ms required
1.5-2.1 A peak @ 24V short

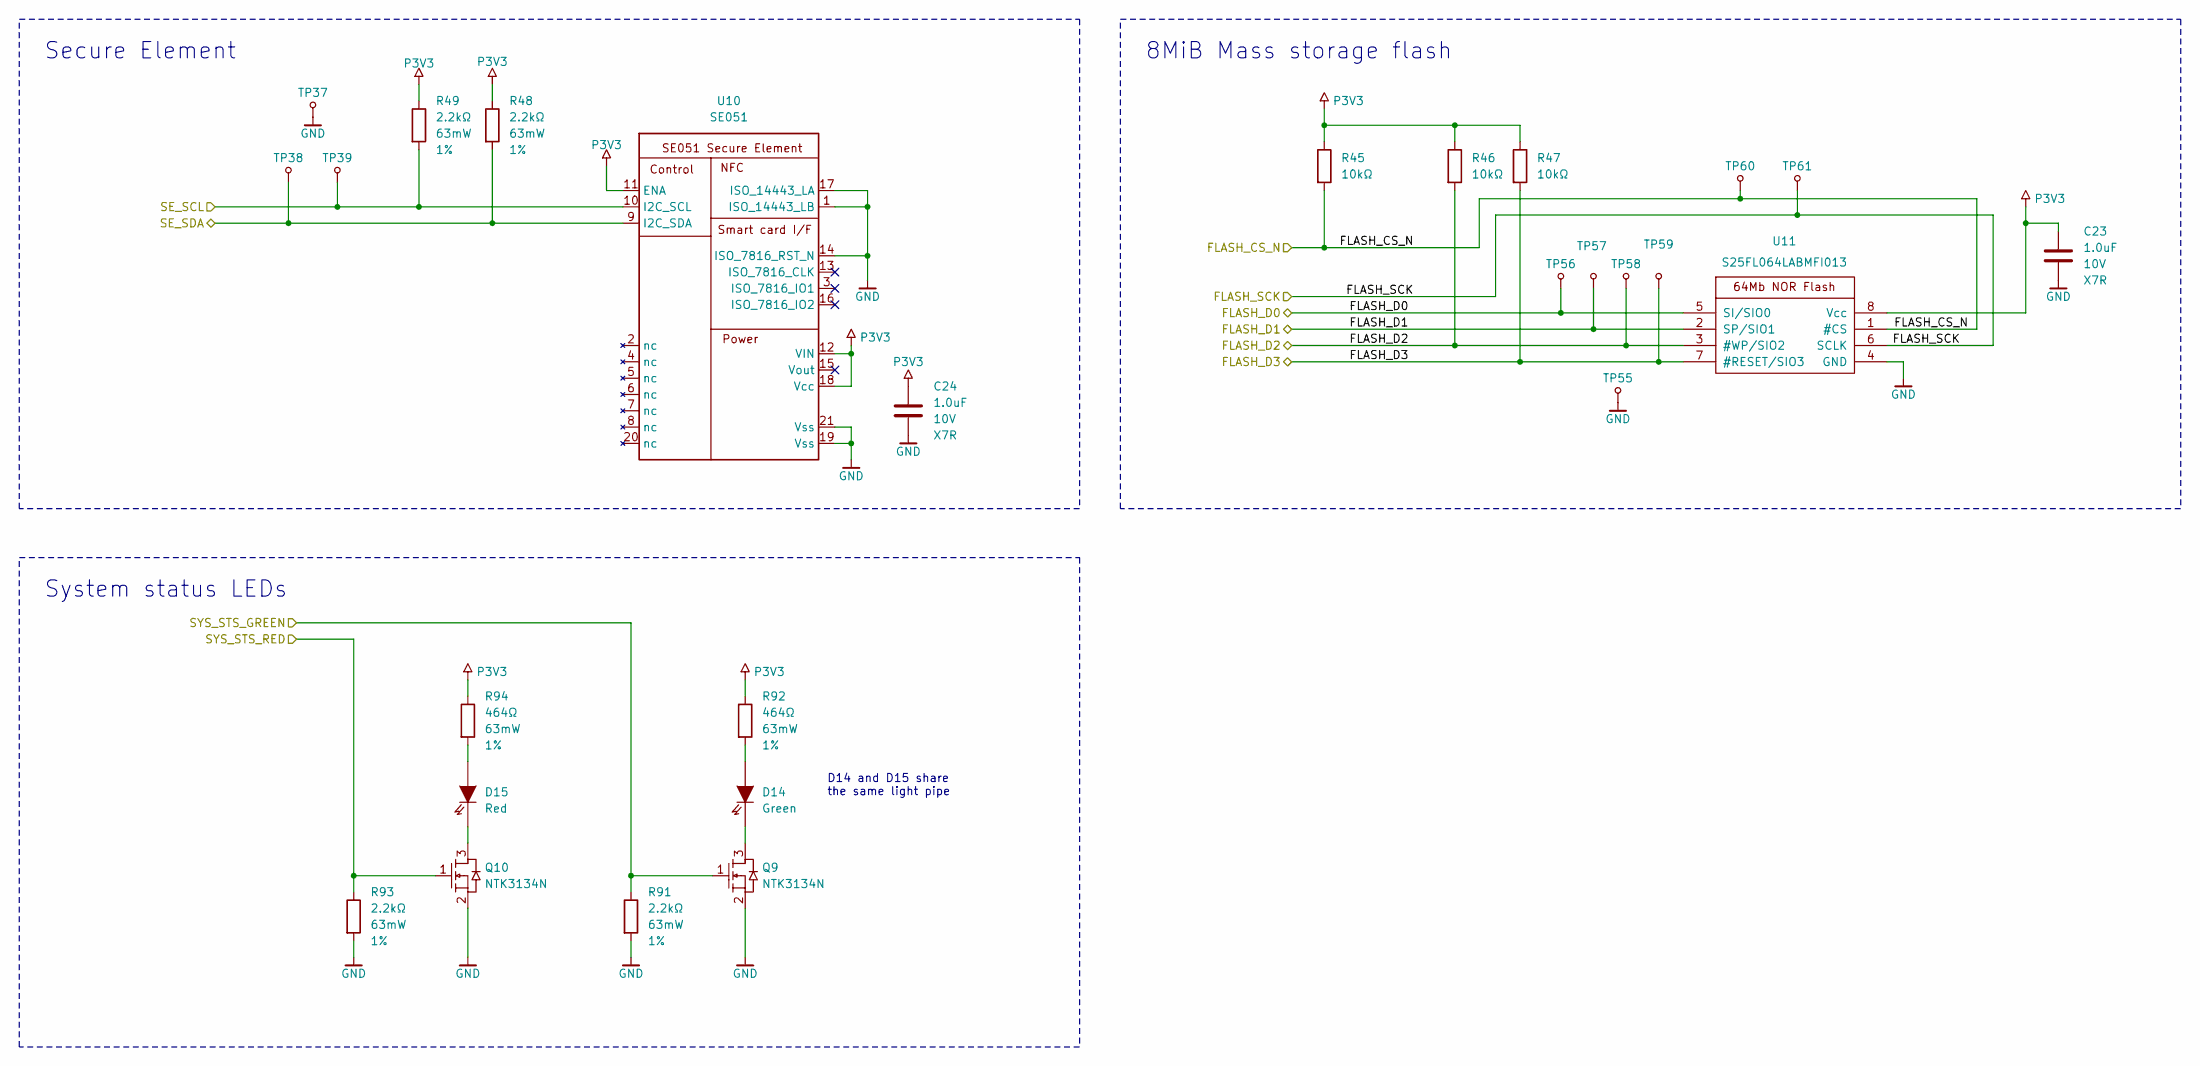
[picture p11: schematic mcu_periph.kicad_sch, PoEtato - MCU peripherals: flash, secure element, status LE…]

Parts:
C23, C24: 1.0uF; C_0402_1005Metric; Voltage 10V; Part Number GRM155Z71A105KE01
D14: LED0402_150040VS73240; LED_0402_1005Metric; Part Number 150040VS73240
D15: LED0402_150040SS73240; LED_0402_1005Metric; Part Number 150040SS73240
Q9, Q10: NTK3134N; SOT-723; Part Number NTK3134NT1G
R45, R46, R47: 10kΩ; R_0402_1005Metric; Tolerance 1%; Part Number CRCW040210K0FKED
R48, R49, R91, R93: 2.2kΩ; R_0402_1005Metric; Tolerance 1%; Part Number CRCW04022K20FKED
R92, R94: 464Ω; R_0402_1005Metric; Tolerance 1%; Part Number CRCW0402464RFKED
TP37, TP38, TP39, TP55, TP56, TP57, TP58, TP59, TP60, TP61: TP; TestPoint_Pad_D1.0mm
U10: SE051; UQFN-20-1EP_3x3mm_P0.4mm_EP1.85x1.85mm; Part Number SE051C2HQ1/Z01XDZ
U11: S25FL064LABMFI013; SOIC-8_5.3x5.3mm_P1.27mm; Part Number S25FL064LABMFI013

Connections:
/MCU/FLASH_CS_N: R45.2, TP60.1, U11.1 (#CS); also elsewhere on the board
/MCU/FLASH_D0: TP56.1, U11.5 (SI/SIO0); also elsewhere on the board
/MCU/FLASH_D1: TP57.1, U11.2 (SP/SIO1); also elsewhere on the board
/MCU/FLASH_D2: R46.2, TP58.1, U11.3 (#WP/SIO2); also elsewhere on the board
/MCU/FLASH_D3: R47.2, TP59.1, U11.7 (#RESET/SIO3); also elsewhere on the board
/MCU/FLASH_SCK: TP61.1, U11.6 (SCLK); also elsewhere on the board
/MCU/SE_SCL: R49.2, TP39.1, U10.10 (I2C_SCL); also elsewhere on the board
/MCU/SE_SDA: R48.2, TP38.1, U10.9 (I2C_SDA); also elsewhere on the board
/MCU/SYS_STS_GREEN: Q9.1, R91.1; also elsewhere on the board
/MCU/SYS_STS_RED: Q10.1, R93.1; also elsewhere on the board
GND: C23.2, C24.2, Q9.2, Q10.2, R91.2, R93.2, TP37.1, TP55.1, U10.1 (ISO_14443_LB), U10.14 (ISO_7816_RST_N), U10.17 (ISO_14443_LA), U10.19 (Vss), U10.21 (Vss), U11.4 (GND); also elsewhere on the board
unnamed: D14.1, Q9.3
unnamed: D14.2, R92.2
unnamed: D15.1, Q10.3
unnamed: D15.2, R94.2
P3V3: C23.1, C24.1, R45.1, R46.1, R47.1, R48.1, R49.1, R92.1, R94.1, U10.11 (ENA), U10.12 (VIN), U10.18 (Vcc), U11.8 (Vcc); also elsewhere on the board

Notes on the sheet:
Secure Element
System status LEDs
D14 and D15 share the same light pipe
8MiB Mass storage flash

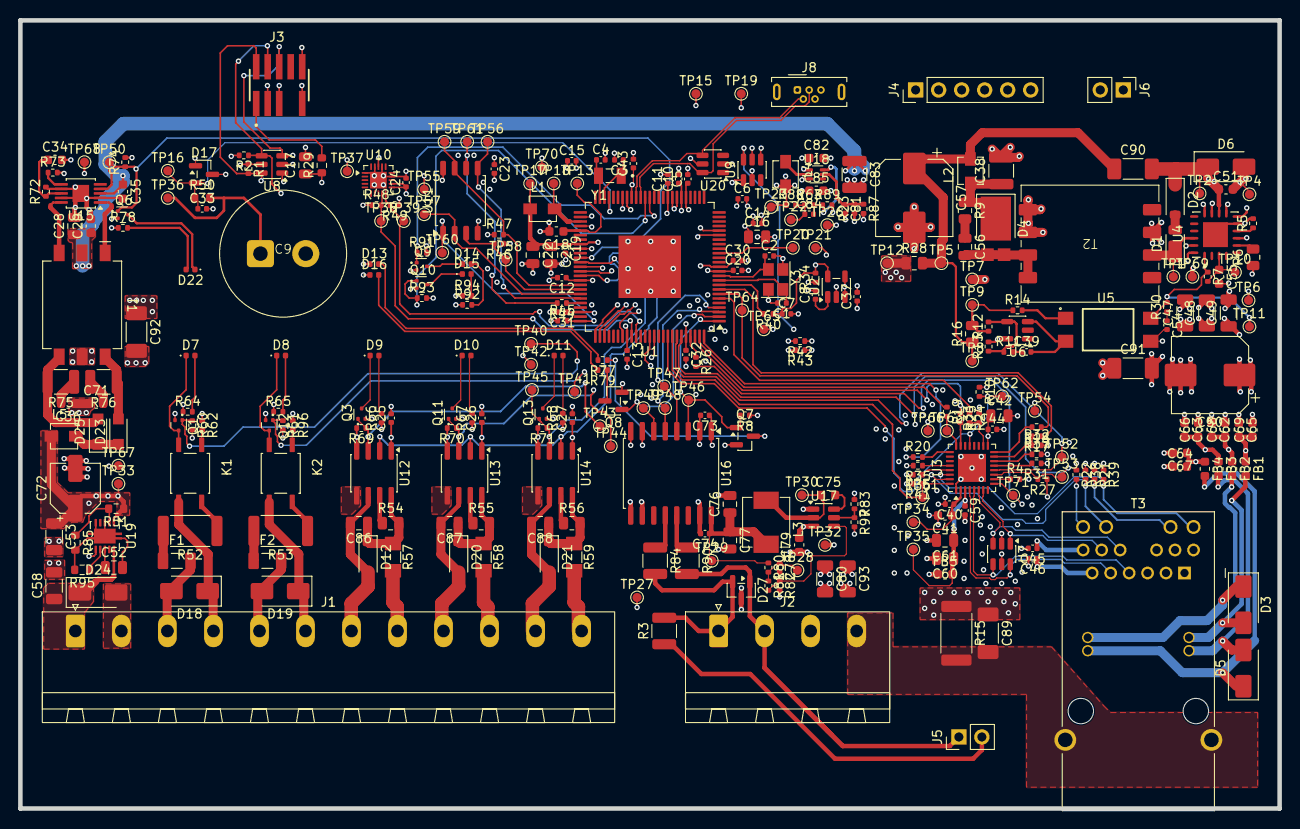
[picture p12: board poetato.kicad_pcb from above]

Board: 6 copper layers, 139.0 x 87.0 mm, 336 parts (0 on the bottom side), 186 nets.
