jonasblixt/poetato/(commit log)

2026-10-12 gitignore: ignore __pycache__ and KiCad local history
2026-10-12 hw: schematic and PCB update
    - SE051C2 secure element, ENA tied to 3V3, RST_N to GND
    - Epson TSX-3225 24 MHz and FC-135R 32.768 kHz crystals (replace NDK)
    - LMR51420 RS-485 5 V buck (replaces TPS54202H)
    - Field rail preload removed
    - Datasheets updated to match (Würth connector added, unused
    NDK, TPS54202H, IHLP and Murata cap datasheets removed)
2026-10-12 doc: sync with hardware, add verification plan and 2026-10-09 review
    - SE050 -> SE051 throughout docs and generated figures
    - Field preload removed: budget 4.14 W -> 4.07 W
    - Crystal, RTC backup and bench power decisions recorded
    - N947/N247 footprint compatibility dropped, no UART ISP header
    - doc/poe-verification.md folded into doc/verification-plan.md
    - Schematic review 2026-10-09 added, 2026-10-04 review updated
2026-10-12 Clean up repo and extend .gitignore
    - Remove stray poe6A42.kicad_prl (old project name)
    - Remove generated poetato.step 3D export
    - Stop tracking poetato.kicad_prl (per-user KiCad view state)
    - Anchor west workspace dirs to the repo root
    - Ignore KiCad backups/autosave/prl/step/production output,
    Python caches, .env, Claude local settings and OS files
2026-10-12 hw: RS485_RXD pull-up, 3V3 buck EN threshold, DC-only output rating
    - R8 100 kOhm pull-up from RS485_RXD to P3V3 (review X3-1)
    - 3V3 buck EN divider R23 127 kOhm / R87 20.5 kOhm (replaces R86
    47 kOhm): on at ~8.6 V, off at ~7.2 V (review Q-4)
    - IO sheet note: outputs rated <= 30 V DC only (review E1-1)
2026-10-12 doc: record 2026-10-12 review decisions
    - Outputs rated <= 30 V DC only (E1-1)
    - RS-485 relies on fail-safe receivers, no bias resistors (Q2-1)
    - VDD_BAT ramp accepted; bring-up note and R50 -> 2.2 kOhm fallback
    in verification-plan §3/§5.2, arch §3 reworded (W2-1)
    - R28 flyback debug link, J6 >= 9 V after EN change (Q-3, Q-4)
    - MLCC voltage derating accepted (R1-1); RS485_RXD pull-up fixed (X3-1)
2026-10-12 hw: remove orphan power.kicad_sch
    Empty sheet, not instantiated in the hierarchy (review H2-1).
2026-10-12 hw: name test point nets, debug UART series 1 kOhm, DO notes
    - Test point nets named (P12V0_FILTER, POE_VDD, POE_EROUT, VDD_SYS,
    VDD_BAT, VDD_CORE, DCDC_LX, V_SUPERCAP, loop injection nodes, ...)
    (review T4-1)
    - R42 330 Ohm -> 1 kOhm on LPUART1_RXD, limits back-feed from a
    USB-UART cable on J4 into an unpowered board (review X2-1)
    - DO sheet notes match arch §7: 1.5-2.1 A at a 24 V short (review H4-1)
2026-10-12 doc: schematic review 2026-10-12 status, released for layout
    X2-1 and H4-1 fixed, T4-1 partly fixed (TP63 only), T2-1 and H3-1
    closed. ERC clean on today's save. Remaining open items are notes.
2026-10-13 hw: add power tree to top-level sheet
2026-10-13 doc: schematic readability review 2026-10-13
2026-10-13 hw: sync symbols with kicadlib field text and value updates
    Update Symbols from Library for kicadlib 8686346 (field text 1.27 mm) and
    5b35b6c (units on misc R/C values). Value text sizes synced to the library
    by script, since a Value reset would also reset power-symbol net names.
    Restored BOM_Entry Manufacturer/Part Number and the R57 Power field that the
    update cleared, and field positions it reset. Nudged R1, C6, Q6 and C75 text
    clear of the larger power-symbol labels. ERC clean, netlist unchanged apart
    from the intended values.
2026-10-13 doc: drop DI mirroring from the readability review
    Field connectors stay on the right, so the DI channel keeps its layout.
2026-10-13 hw: move the DC/DC converters to a new top-level Power sheet
    power.kicad_sch (page 4) holds the 3.3 V buck (from MCU), the isolated
    24 V field supply with its enable FET and LED (from IO) and the RS-485
    5 V buck (from RS485). The two bucks are mirrored to read left to right.
    The PoE flyback stays on the Ethernet sheet.
    P5V_RS485 is now a power symbol and P24V_FIELD_EN goes from MCU to the
    Power sheet at the top level. On IO the eFuse moved next to J1, removing
    the output loop around the page. The power tree is redrawn more compact
    to make room for the new sheet symbol.
    Symbols keep their UUIDs and references. ERC clean; every net connects
    the same pins as before, 7 nets renamed by the new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
2026-10-13 hw: schematic touch-ups after the Power sheet split
    Layout touch-ups in KiCad; connectivity and values unchanged, ERC clean.
    The project file picks up the new sheet names (Power, DO1/DO2, DI1-DI3).
2026-10-13 hw: Remove stray kicad_sym file.
2026-10-13 hw: fix local text collisions and add strap and BOM notes
    - MCU: light-pipe note beside D14, TP64/TP65 references off the signal rows
    - Ethernet: KSZ8081 strap summary (PHY address 1, RMII, auto-neg 100M),
    TP6 reference clear of POE_VDD
    - IO: rating notes merged into the notes box
    - DO: PhotoMOS note under K1
    - Top level: frame and title around the BOM-only entries
    Text and graphics only; ERC clean, netlist unchanged.
2026-10-13 hw: move flash, SE051 and status LEDs to an MCU peripherals sub-sheet
    mcu_periph.kicad_sch (/MCU/Peripherals/, A4, page 3) holds U11 with its
    pull-ups and test points, U10 with the I2C pull-ups, and the two status
    LED drivers. U1 connects to it through short labelled stubs, which
    removes the SE_SCL/SE_SDA route over the top of the MCU sheet and the
    long SYS_STS wires. R44 stays next to U1.
    Symbols keep their UUIDs and references; netlist unchanged including
    net names. Later pages move down by one.
2026-10-13 hw: schematic touch-ups, J3 updated from library
    Layout touch-ups in KiCad. J3 (FTSH-105) pulled from kicadlib 81de170:
    pin numbers without leading zeros (01-10 -> 1-10). Otherwise connectivity
    and values unchanged; ERC clean. Project file picks up the Peripherals
    sheet name.
2026-10-13 hw: 2.54 mm block titles, DI sheets on A3
    - MCU: RTC block title at 2.54 mm (two lines); its contents move down
    7.62 mm to make room
    - Peripherals: the three block titles at 2.54 mm, left-aligned in their frames
    - DI: A3 like every other sheet, content placed as on the DO sheets; the
    COOL_POUR ERC exclusion in the project file follows the label
    ERC clean, netlist unchanged.
2026-10-13 doc: close the 2026-10-13 readability review
    FLOW-2, FLOW-6 and VAL-1 closed by decision. Adds a status row and an
    outcome table listing the commits. 19 fixed, 9 resolved by decision,
    FONT-4 partly fixed (LPUART1 debug port frame left open).
2026-10-13 hw: IO sheet touch-ups
    Layout touch-ups in KiCad; connectivity and values unchanged.
2026-10-13 hw, doc: JLC06161H-2116A stackup and impedance classes
    Stackup drawing and controlled-impedance table on User.3 (named
    User.Stackup), right of the board. New doc/pcb-stackup.md with the
    stackup, why 2116A, the 50/90/100 ohm classes and routing rules;
    doc/scripts/impedance.py is the 2D field solver behind the widths.
    Decision log row, verification-plan check of the fab impedance report.
2026-10-13 hw, doc: vendor-neutral fab requirements, physical stackup in Board Setup
    Board Setup now holds the JLC06161H-2116A stackup (impedance controlled,
    ENIG, LPI mask Dk 3.8), so the Gerber job, IPC-2581 and ODB++ exports
    carry it. Fabrication notes on User.Stackup below the board, and
    doc/pcb-stackup.md §7 with the same requirements: IPC-6012 Class 2,
    Tg >= 150, 1.60 mm +-10 %, finished copper, impedance +-10 % with
    coupons and report, the dielectric gaps another fab must keep.
    doc/scripts/stackup_drawing.py regenerates the drawing.
2026-10-13 hw, doc: design rules and impedance net classes
    Net classes 50Ohm_RMII, 50Ohm_QSPI, 90Ohm-diff_USB, 100Ohm-diff_MDI,
    assigned in the schematic: hidden Netclass fields on the labels, two
    rule areas for the PHY-side RMII stubs, ETH_REF_CLK_PHY label after
    R26. USB_DP/USB_DM renamed USB_D_P/USB_D_N so KiCad pairs them.
    Board rules per doc/pcb-stackup.md section 8: 0.12 mm min track,
    0.18 default, 0.15 clearance, vias 0.3/0.6 (0.25/0.45 small), silk and
    mask minimums, diff pair presets. poetato.kicad_dru holds the narrower
    L3 widths. Unused inner-layer pads removed on all vias. Fab notes:
    plain vias, no IPC-4761 Type VII required.
2026-10-13 hw, doc: net classes by schematic rule areas only
    Hidden Netclass fields on labels removed. Six rule areas with net-class
    flags instead: RMII RX, RMII TX/RXDV and REF_CLK (each spanning the
    33 ohm resistor so both sides get the class), MDI, QSPI (now including
    the R44 MCU-side stub) and USB. Netlist: same nets classed plus
    Net-(U1-P3_7), no strays; ERC unchanged.
2026-10-13 hw, doc: SWD as 50 ohm controlled impedance
    New net class 50Ohm_SWD (0.18 mm outer, 0.16 mm on L3 via the .kicad_dru
    rule) for SWDCLK, SWDIO and SWO, assigned by a rule area on the MCU
    sheet. MCX N247 SWD runs up to 25 MHz with 3 ns edges (datasheet
    Table 33). RESET_N stays Default. Docs and board drawing updated.
