jonasblixt/poetato/(notices)

Notices in the files:
hw/poetato/do.kicad_sch:
Copyright (c) 2026 Jonas Blixt. SPDX-License-Identifier: CERN-OHL-S-2.0
Licensed under CERN-OHL-S v2: https://ohwr.org/cern_ohl_s_v2.txt
